apertus-open-source-cinema/pcbs/boards/axiom_beta_power_board_v0.23.brd

## EAGLE design boards/axiom_beta_power_board_v0.23.brd (2021-12-13, an earlier design)

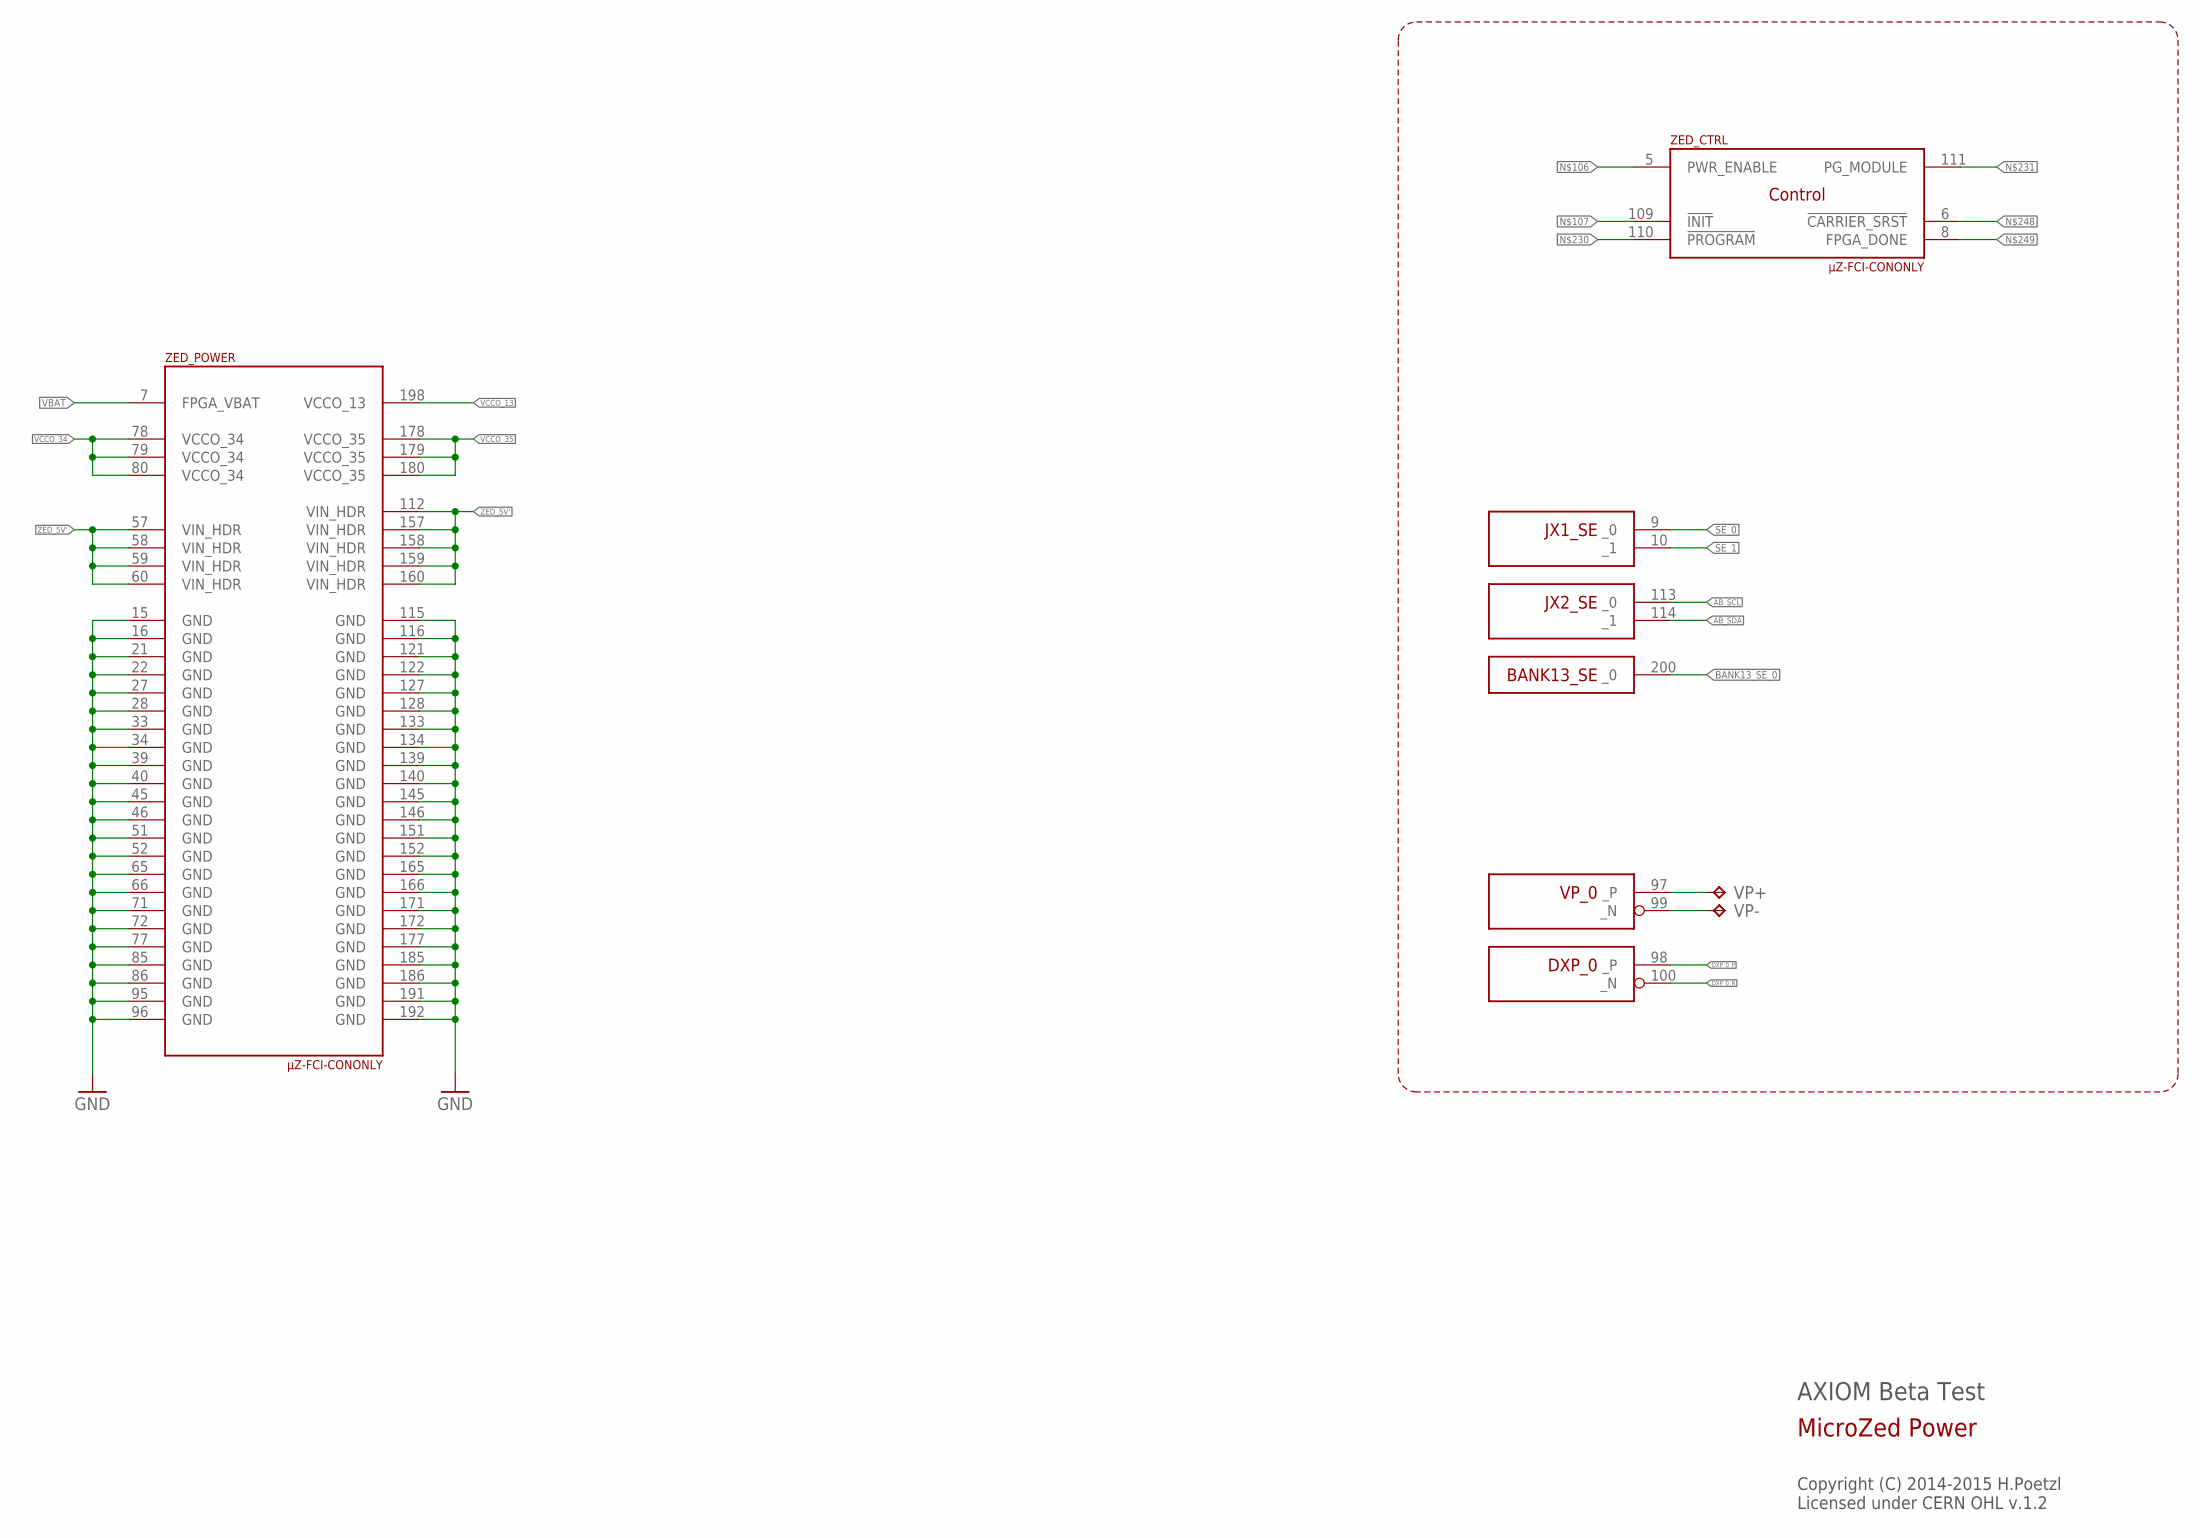
[picture p1: schematic axiom_beta_power_board_v0.23.sch, sheet 1]

Parts:
VP+: TPTP16SQ; TP16SQ
VP-: TPTP16SQ; TP16SQ
ZED: µZ-FCI-CONONLY; µZ-CONONLY

Connections:
AB_SCL: ZED.113 (_0); also elsewhere on the board
AB_SDA: ZED.114 (_1); also elsewhere on the board
BANK13_SE_0: ZED.200 (_0); also elsewhere on the board
DXP_0_N: ZED.100 (_N)
DXP_0_P: ZED.98 (_P)
GND: ZED.15 (GND), ZED.16 (GND), ZED.21 (GND), ZED.22 (GND), ZED.27 (GND), ZED.28 (GND), ZED.33 (GND), ZED.34 (GND), ZED.39 (GND), ZED.40 (GND), ZED.45 (GND), ZED.46 (GND), ZED.51 (GND), ZED.52 (GND), ZED.65 (GND), ZED.66 (GND), ZED.71 (GND), ZED.72 (GND), ZED.77 (GND), ZED.85 (GND), ZED.86 (GND), ZED.95 (GND), ZED.96 (GND), ZED.115 (GND), ZED.116 (GND), ZED.121 (GND), ZED.122 (GND), ZED.127 (GND), ZED.128 (GND), ZED.133 (GND), ZED.134 (GND), ZED.139 (GND), ZED.140 (GND), ZED.145 (GND), ZED.146 (GND), ZED.151 (GND), ZED.152 (GND), ZED.165 (GND), ZED.166 (GND), ZED.171 (GND), ZED.172 (GND), ZED.177 (GND), ZED.185 (GND), ZED.186 (GND), ZED.191 (GND), ZED.192 (GND); also elsewhere on the board
SE_0: ZED.9 (_0); also elsewhere on the board
SE_1: ZED.10 (_1); also elsewhere on the board
VBAT: ZED.7 (FPGA_VBAT)
VCCO_13: ZED.198 (VCCO_13); also elsewhere on the board
VCCO_34: ZED.78 (VCCO_34), ZED.79 (VCCO_34), ZED.80 (VCCO_34); also elsewhere on the board
VCCO_35: ZED.178 (VCCO_35), ZED.179 (VCCO_35), ZED.180 (VCCO_35); also elsewhere on the board
VP_0_N: VP-.TP, ZED.99 (_N)
VP_0_P: VP+.TP, ZED.97 (_P)
ZED_5V': ZED.57 (VIN_HDR), ZED.58 (VIN_HDR), ZED.59 (VIN_HDR), ZED.60 (VIN_HDR), ZED.112 (VIN_HDR), ZED.157 (VIN_HDR), ZED.158 (VIN_HDR), ZED.159 (VIN_HDR), ZED.160 (VIN_HDR); also elsewhere on the board

Notes on the sheet:
AXIOM Beta Test
Copyright (C) 2014-2015 H.Poetzl Licensed under CERN OHL v.1.2
MicroZed Power

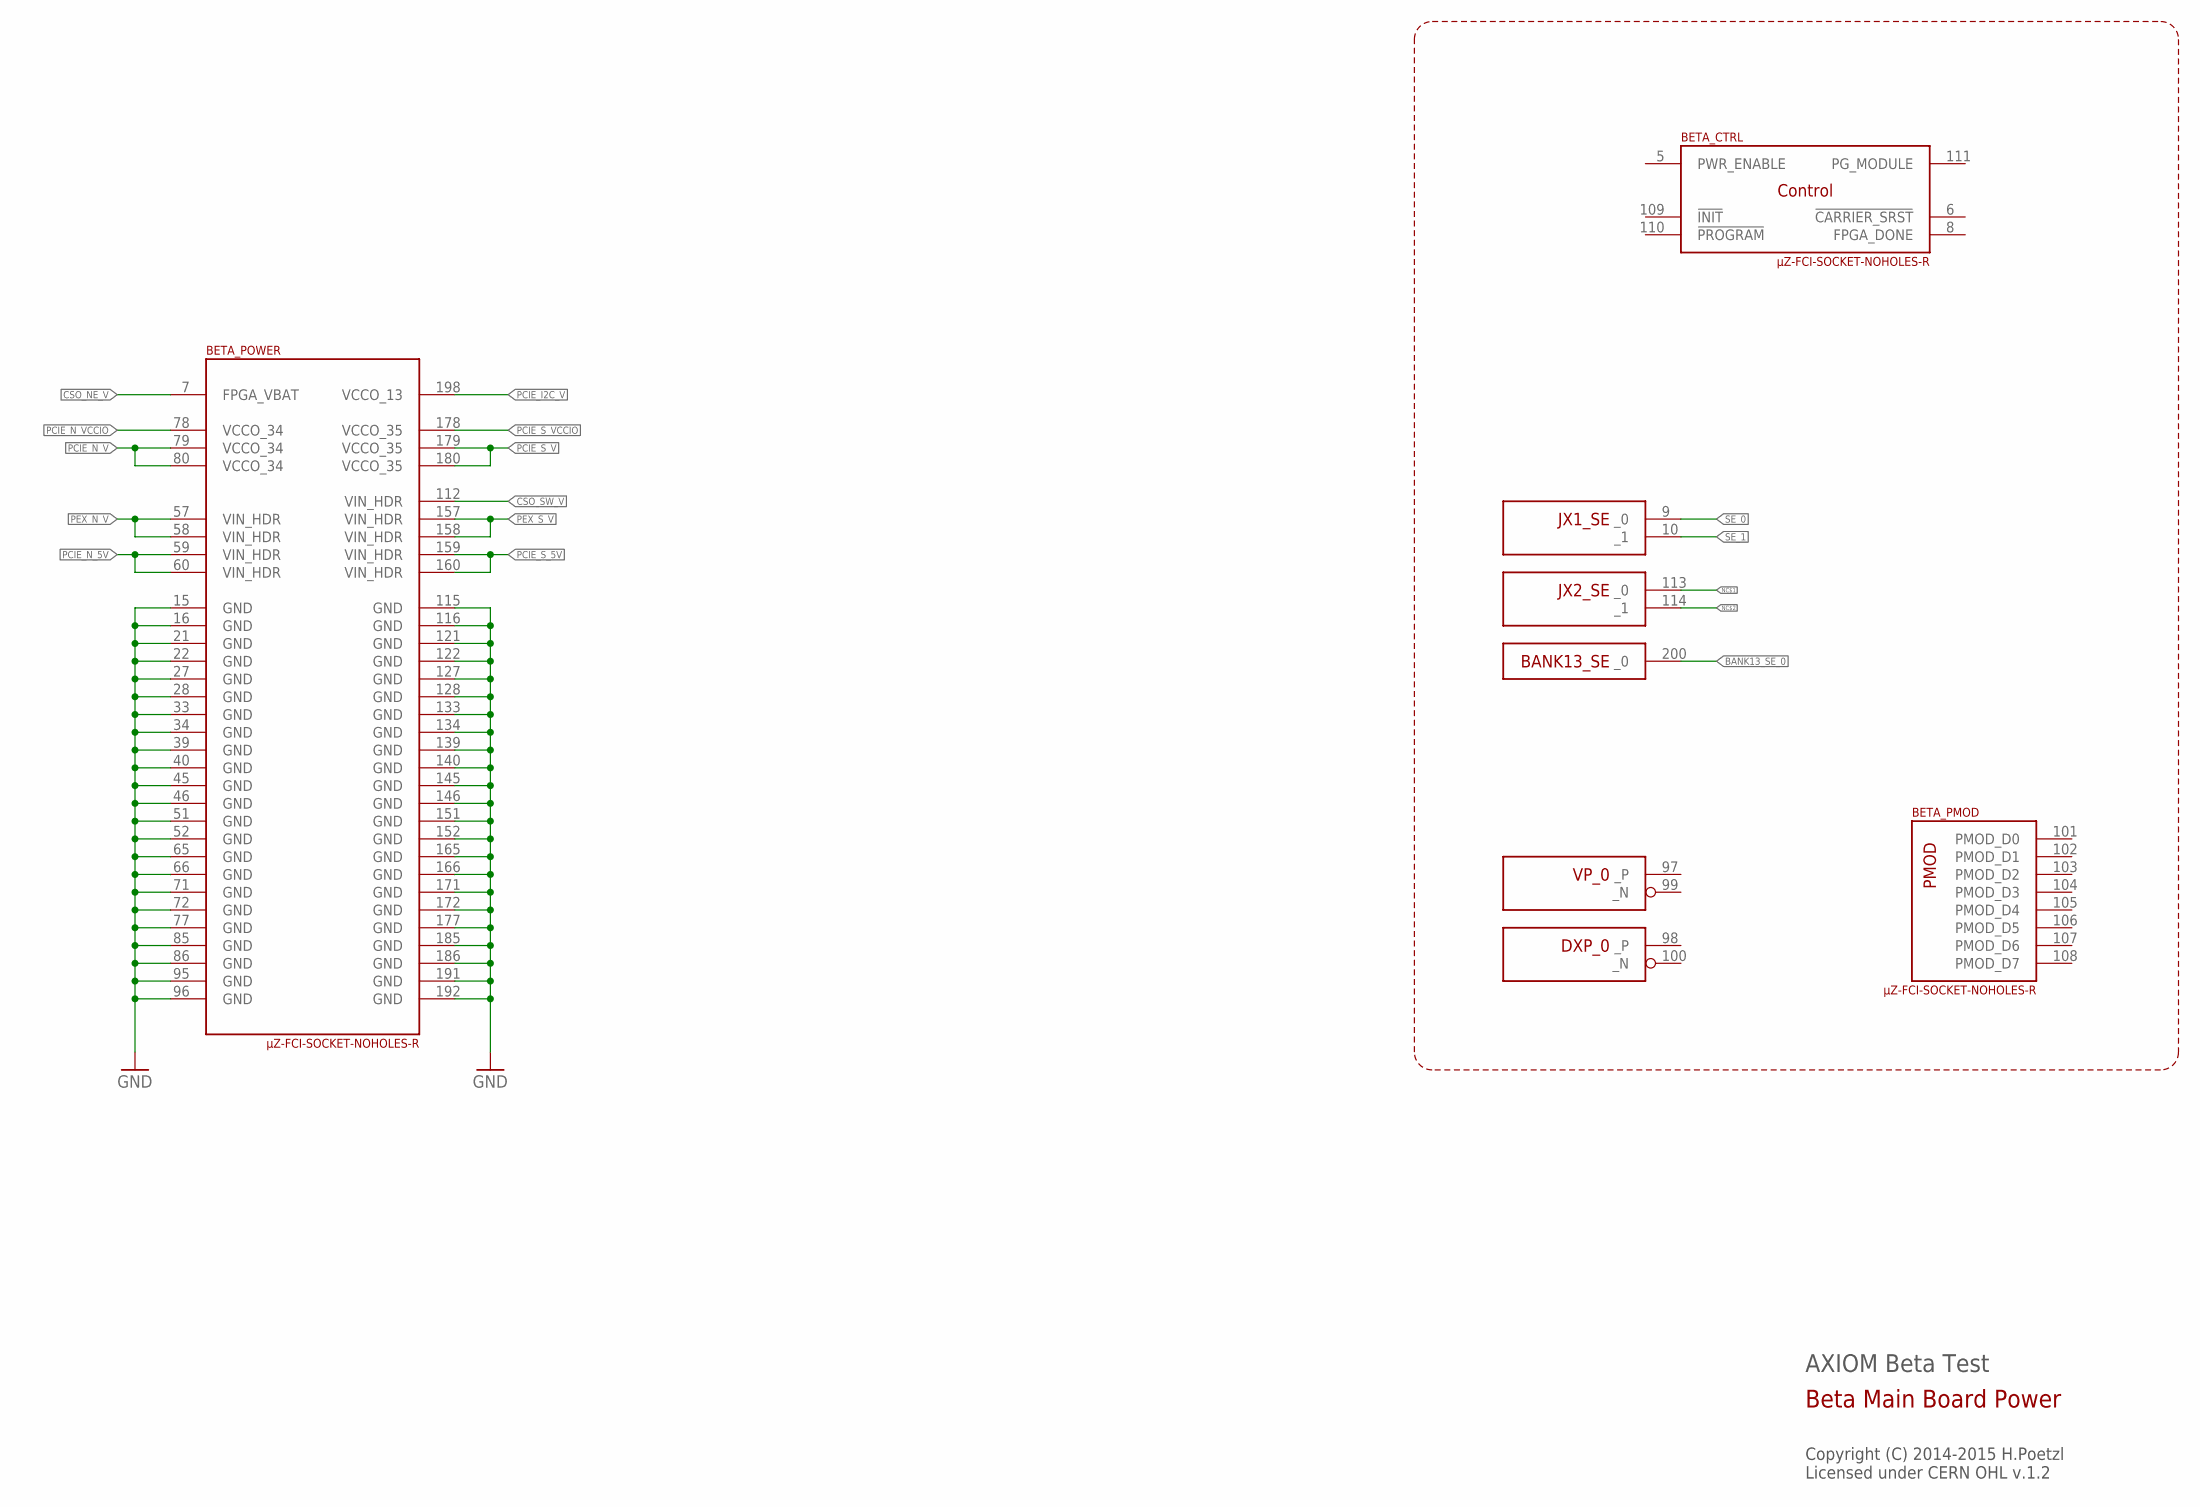
[picture p2: schematic axiom_beta_power_board_v0.23.sch, sheet 2]

Parts:
BETA: µZ-FCI-SOCKET-NOHOLES-R; µZ-SOCKET-NOHOLES-R

Connections:
BANK13_SE_0: BETA.200 (_0); also elsewhere on the board
CSO_NE_V: BETA.7 (FPGA_VBAT); also elsewhere on the board
CSO_SW_V: BETA.112 (VIN_HDR); also elsewhere on the board
GND: BETA.15 (GND), BETA.16 (GND), BETA.21 (GND), BETA.22 (GND), BETA.27 (GND), BETA.28 (GND), BETA.33 (GND), BETA.34 (GND), BETA.39 (GND), BETA.40 (GND), BETA.45 (GND), BETA.46 (GND), BETA.51 (GND), BETA.52 (GND), BETA.65 (GND), BETA.66 (GND), BETA.71 (GND), BETA.72 (GND), BETA.77 (GND), BETA.85 (GND), BETA.86 (GND), BETA.95 (GND), BETA.96 (GND), BETA.115 (GND), BETA.116 (GND), BETA.121 (GND), BETA.122 (GND), BETA.127 (GND), BETA.128 (GND), BETA.133 (GND), BETA.134 (GND), BETA.139 (GND), BETA.140 (GND), BETA.145 (GND), BETA.146 (GND), BETA.151 (GND), BETA.152 (GND), BETA.165 (GND), BETA.166 (GND), BETA.171 (GND), BETA.172 (GND), BETA.177 (GND), BETA.185 (GND), BETA.186 (GND), BETA.191 (GND), BETA.192 (GND); also elsewhere on the board
NC$1: BETA.113 (_0)
NC$2: BETA.114 (_1)
PCIE_I2C_V: BETA.198 (VCCO_13)
PCIE_N_5V: BETA.59 (VIN_HDR), BETA.60 (VIN_HDR)
PCIE_N_V: BETA.79 (VCCO_34), BETA.80 (VCCO_34); also elsewhere on the board
PCIE_N_VCCIO: BETA.78 (VCCO_34)
PCIE_S_5V: BETA.159 (VIN_HDR), BETA.160 (VIN_HDR)
PCIE_S_V: BETA.179 (VCCO_35), BETA.180 (VCCO_35); also elsewhere on the board
PCIE_S_VCCIO: BETA.178 (VCCO_35)
PEX_N_V: BETA.57 (VIN_HDR), BETA.58 (VIN_HDR)
PEX_S_V: BETA.157 (VIN_HDR), BETA.158 (VIN_HDR)
SE_0: BETA.9 (_0); also elsewhere on the board
SE_1: BETA.10 (_1); also elsewhere on the board

Notes on the sheet:
AXIOM Beta Test
Copyright (C) 2014-2015 H.Poetzl Licensed under CERN OHL v.1.2
Beta Main Board Power

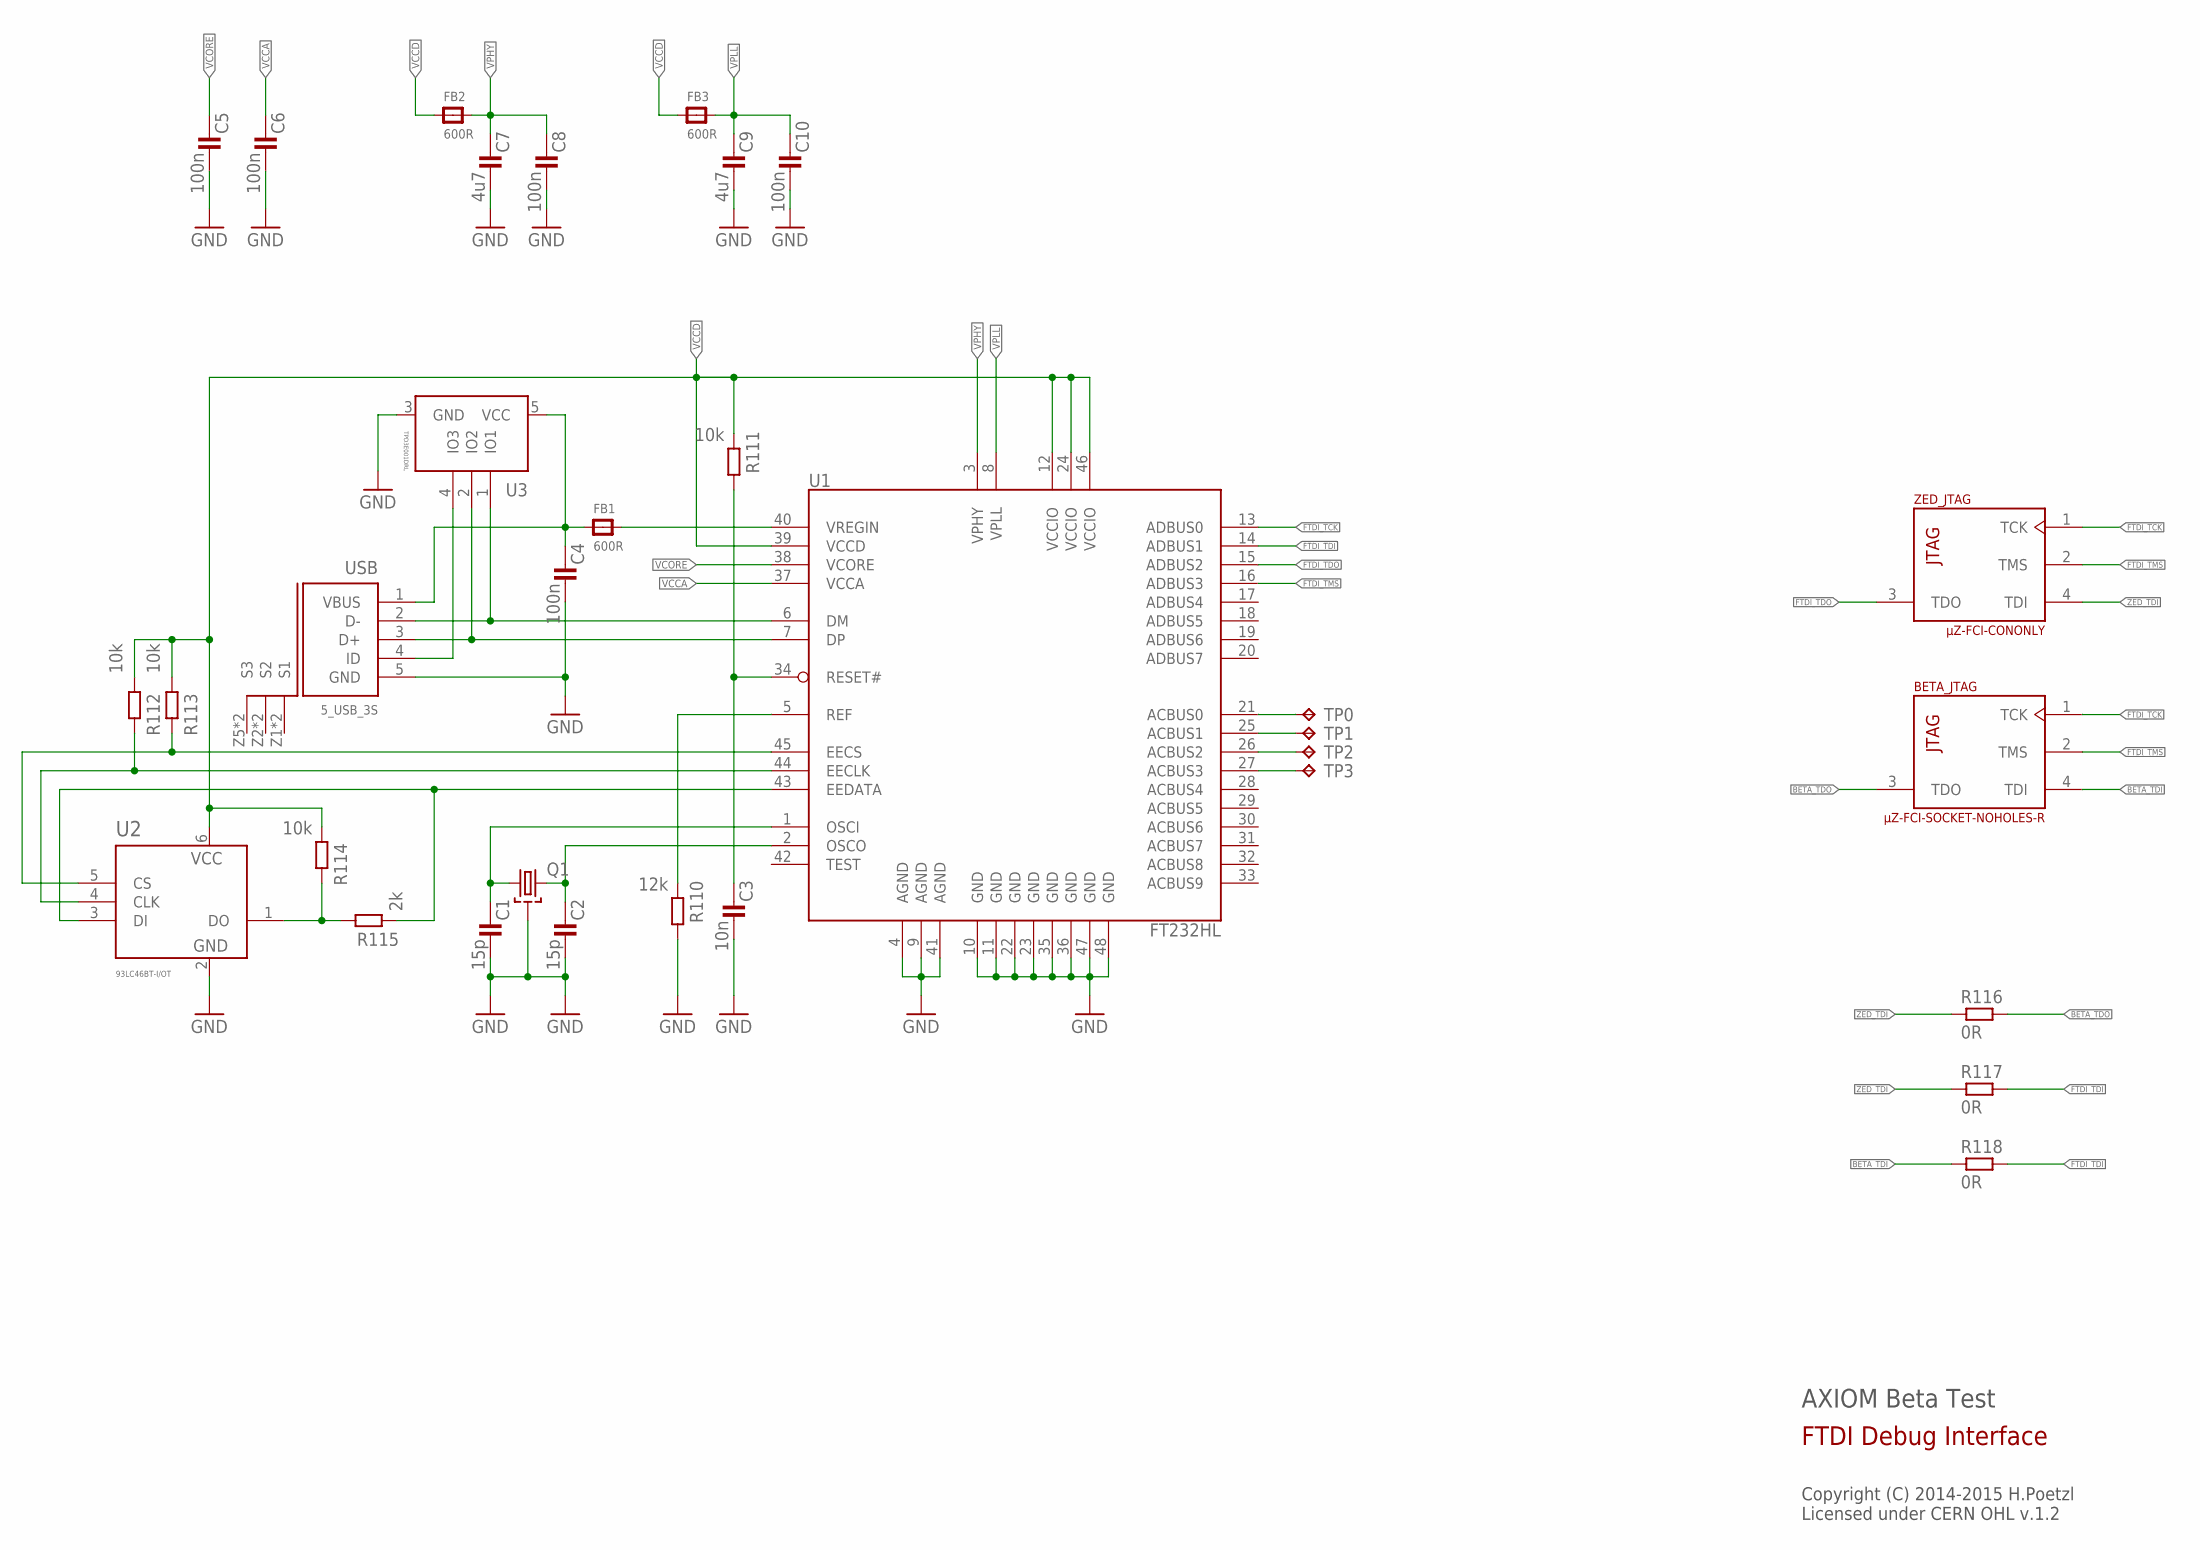
[picture p3: schematic axiom_beta_power_board_v0.23.sch, sheet 3]

Parts:
BETA: µZ-FCI-SOCKET-NOHOLES-R; µZ-SOCKET-NOHOLES-R
C1, C2: 15p; 0402-B
C3: 10n; 0402-B
C4: 100n; 0603-B
C5, C6, C8, C10: 100n; 0402-B
C7, C9: 4u7; 0603-B
FB1, FB2, FB3: 600R; _0603MP
Q1: SMD-4P-2G-3.2X2.5; ABM8G
R110: 12k; 0402-B
R111, R112, R113, R114: 10k; 0402-B
R115: 2k; 0402-B
R116, R117, R118: 0R; 0402-B
TP0, TP1, TP2, TP3: TPTP16SQ; TP16SQ
U1: FT232HL; LQFP48
U2: 93LC46BT-I/OT; SOT95P280X145-6N
U3: TPD3E001DRL; R-PDSO-N5
USB: 5_USB_3S; MICRO-AB-H-SMT
ZED: µZ-FCI-CONONLY; µZ-CONONLY

Connections:
BETA_TDI: BETA.4 (TDI), R118.2
BETA_TDO: BETA.3 (TDO), R116.1
EE_CLK1: R112.1, U1.44 (EECLK), U2.4 (CLK)
EE_CS1: R113.1, U1.45 (EECS), U2.5 (CS)
EE_DATA1: R115.2, U1.43 (EEDATA), U2.3 (DI)
FTDI_D_N: U1.6 (DM), U3.1 (IO1), USB.2 (D-)
FTDI_D_P: U1.7 (DP), U3.2 (IO2), USB.3 (D+)
FTDI_TCK: BETA.1 (TCK), U1.13 (ADBUS0), ZED.1 (TCK)
FTDI_TDI: R117.1, R118.1, U1.14 (ADBUS1)
FTDI_TDO: U1.15 (ADBUS2), ZED.3 (TDO)
FTDI_TMS: BETA.2 (TMS), U1.16 (ADBUS3), ZED.2 (TMS)
GND: C1.2, C2.2, C3.2, C4.2, C5.2, C6.2, C7.2, C8.2, C9.2, C10.2, Q1.2 (GND), Q1.4 (GND), R110.1, U1.4 (AGND), U1.9 (AGND), U1.10 (GND), U1.11 (GND), U1.22 (GND), U1.23 (GND), U1.35 (GND), U1.36 (GND), U1.41 (AGND), U1.47 (GND), U1.48 (GND), U2.2 (VSS), U3.3 (GND), USB.5 (GND); also elsewhere on the board
unnamed: C4.1, FB1.1, U3.5 (VCC), USB.1 (VBUS)
unnamed: TP1.TP, U1.25 (ACBUS1)
unnamed: TP2.TP, U1.26 (ACBUS2)
unnamed: TP3.TP, U1.27 (ACBUS3)
unnamed: TP0.TP, U1.21 (ACBUS0)
unnamed: R114.1, R115.1, U2.1 (DO)
unnamed: C1.1, Q1.1, U1.1 (OSCI)
unnamed: C2.1, Q1.3 (2), U1.2 (OSCO)
unnamed: C3.1, R111.1, U1.34 (RESET#)
unnamed: R110.2, U1.5 (REF)
unnamed: U3.4 (IO3), USB.4 (ID)
VCCA: C6.1, U1.37 (VCCA)
VCCD: FB2.1, FB3.1, R111.2, R112.2, R113.2, R114.2, U1.12 (VCCIO), U1.24 (VCCIO), U1.39 (VCCD), U1.46 (VCCIO), U2.6 (VCC)
VCORE: C5.1, U1.38 (VCORE)
VPHY: C7.1, C8.1, FB2.2, U1.3 (VPHY)
VPLL: C9.1, C10.1, FB3.2, U1.8 (VPLL)
VREGIN: FB1.2, U1.40 (VREGIN)
ZED_TDI: R116.2, R117.2, ZED.4 (TDI)

Notes on the sheet:
AXIOM Beta Test
Copyright (C) 2014-2015 H.Poetzl Licensed under CERN OHL v.1.2
FTDI Debug Interface

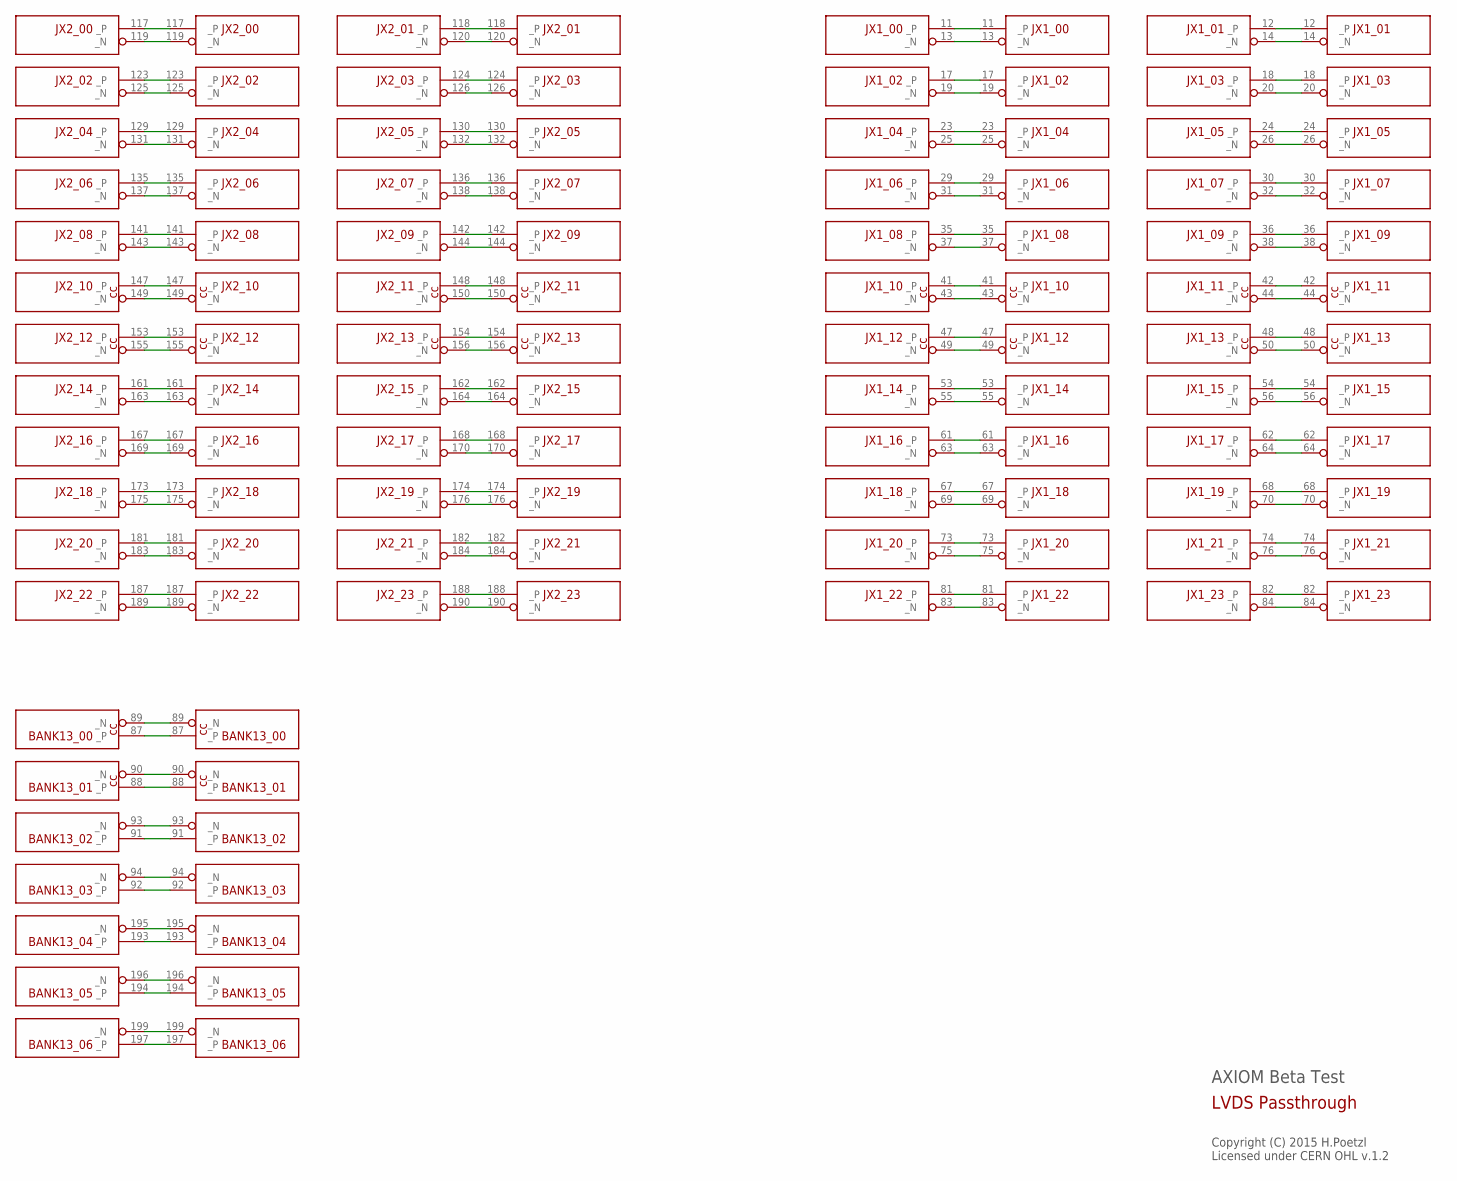
[picture p4: schematic axiom_beta_power_board_v0.23.sch, sheet 4]

Parts:
BETA: µZ-FCI-SOCKET-NOHOLES-R; µZ-SOCKET-NOHOLES-R
ZED: µZ-FCI-CONONLY; µZ-CONONLY

Connections:
BANK13_00_N: BETA.89 (_N), ZED.89 (_N)
BANK13_00_P: BETA.87 (_P), ZED.87 (_P)
BANK13_01_N: BETA.90 (_N), ZED.90 (_N)
BANK13_01_P: BETA.88 (_P), ZED.88 (_P)
BANK13_02_N: BETA.93 (_N), ZED.93 (_N)
BANK13_02_P: BETA.91 (_P), ZED.91 (_P)
BANK13_03_N: BETA.94 (_N), ZED.94 (_N)
BANK13_03_P: BETA.92 (_P), ZED.92 (_P)
BANK13_04_N: BETA.195 (_N), ZED.195 (_N)
BANK13_04_P: BETA.193 (_P), ZED.193 (_P)
BANK13_05_N: BETA.196 (_N), ZED.196 (_N)
BANK13_05_P: BETA.194 (_P), ZED.194 (_P)
BANK13_06_N: BETA.199 (_N), ZED.199 (_N)
BANK13_06_P: BETA.197 (_P), ZED.197 (_P)
JX1_00_N: BETA.13 (_N), ZED.13 (_N)
JX1_00_P: BETA.11 (_P), ZED.11 (_P)
JX1_01_N: BETA.14 (_N), ZED.14 (_N)
JX1_01_P: BETA.12 (_P), ZED.12 (_P)
JX1_02_N: BETA.19 (_N), ZED.19 (_N)
JX1_02_P: BETA.17 (_P), ZED.17 (_P)
JX1_03_N: BETA.20 (_N), ZED.20 (_N)
JX1_03_P: BETA.18 (_P), ZED.18 (_P)
JX1_04_N: BETA.25 (_N), ZED.25 (_N)
JX1_04_P: BETA.23 (_P), ZED.23 (_P)
JX1_05_N: BETA.26 (_N), ZED.26 (_N)
JX1_05_P: BETA.24 (_P), ZED.24 (_P)
JX1_06_N: BETA.31 (_N), ZED.31 (_N)
JX1_06_P: BETA.29 (_P), ZED.29 (_P)
JX1_07_N: BETA.32 (_N), ZED.32 (_N)
JX1_07_P: BETA.30 (_P), ZED.30 (_P)
JX1_08_N: BETA.37 (_N), ZED.37 (_N)
JX1_08_P: BETA.35 (_P), ZED.35 (_P)
JX1_09_N: BETA.38 (_N), ZED.38 (_N)
JX1_09_P: BETA.36 (_P), ZED.36 (_P)
JX1_10_N: BETA.43 (_N), ZED.43 (_N)
JX1_10_P: BETA.41 (_P), ZED.41 (_P)
JX1_11_N: BETA.44 (_N), ZED.44 (_N)
JX1_11_P: BETA.42 (_P), ZED.42 (_P)
JX1_12_N: BETA.49 (_N), ZED.49 (_N)
JX1_12_P: BETA.47 (_P), ZED.47 (_P)
JX1_13_N: BETA.50 (_N), ZED.50 (_N)
JX1_13_P: BETA.48 (_P), ZED.48 (_P)
JX1_14_N: BETA.55 (_N), ZED.55 (_N)
JX1_14_P: BETA.53 (_P), ZED.53 (_P)
JX1_15_N: BETA.56 (_N), ZED.56 (_N)
JX1_15_P: BETA.54 (_P), ZED.54 (_P)
JX1_16_N: BETA.63 (_N), ZED.63 (_N)
JX1_16_P: BETA.61 (_P), ZED.61 (_P)
JX1_17_N: BETA.64 (_N), ZED.64 (_N)
JX1_17_P: BETA.62 (_P), ZED.62 (_P)
JX1_18_N: BETA.69 (_N), ZED.69 (_N)
JX1_18_P: BETA.67 (_P), ZED.67 (_P)
JX1_19_N: BETA.70 (_N), ZED.70 (_N)
JX1_19_P: BETA.68 (_P), ZED.68 (_P)
JX1_20_N: BETA.75 (_N), ZED.75 (_N)
JX1_20_P: BETA.73 (_P), ZED.73 (_P)
JX1_21_N: BETA.76 (_N), ZED.76 (_N)
JX1_21_P: BETA.74 (_P), ZED.74 (_P)
JX1_22_N: BETA.83 (_N), ZED.83 (_N)
JX1_22_P: BETA.81 (_P), ZED.81 (_P)
JX1_23_N: BETA.84 (_N), ZED.84 (_N)
JX1_23_P: BETA.82 (_P), ZED.82 (_P)
JX2_00_N: BETA.119 (_N), ZED.119 (_N)
JX2_00_P: BETA.117 (_P), ZED.117 (_P)
JX2_01_N: BETA.120 (_N), ZED.120 (_N)
JX2_01_P: BETA.118 (_P), ZED.118 (_P)
JX2_02_N: BETA.125 (_N), ZED.125 (_N)
JX2_02_P: BETA.123 (_P), ZED.123 (_P)
JX2_03_N: BETA.126 (_N), ZED.126 (_N)
JX2_03_P: BETA.124 (_P), ZED.124 (_P)
JX2_04_N: BETA.131 (_N), ZED.131 (_N)
JX2_04_P: BETA.129 (_P), ZED.129 (_P)
JX2_05_N: BETA.132 (_N), ZED.132 (_N)
JX2_05_P: BETA.130 (_P), ZED.130 (_P)
JX2_06_N: BETA.137 (_N), ZED.137 (_N)
JX2_06_P: BETA.135 (_P), ZED.135 (_P)
JX2_07_N: BETA.138 (_N), ZED.138 (_N)
JX2_07_P: BETA.136 (_P), ZED.136 (_P)
JX2_08_N: BETA.143 (_N), ZED.143 (_N)
JX2_08_P: BETA.141 (_P), ZED.141 (_P)
JX2_09_N: BETA.144 (_N), ZED.144 (_N)
JX2_09_P: BETA.142 (_P), ZED.142 (_P)
JX2_10_N: BETA.149 (_N), ZED.149 (_N)
JX2_10_P: BETA.147 (_P), ZED.147 (_P)
JX2_11_N: BETA.150 (_N), ZED.150 (_N)
JX2_11_P: BETA.148 (_P), ZED.148 (_P)
JX2_12_N: BETA.155 (_N), ZED.155 (_N)
JX2_12_P: BETA.153 (_P), ZED.153 (_P)
JX2_13_N: BETA.156 (_N), ZED.156 (_N)
JX2_13_P: BETA.154 (_P), ZED.154 (_P)
JX2_14_N: BETA.163 (_N), ZED.163 (_N)
JX2_14_P: BETA.161 (_P), ZED.161 (_P)
JX2_15_N: BETA.164 (_N), ZED.164 (_N)
JX2_15_P: BETA.162 (_P), ZED.162 (_P)
JX2_16_N: BETA.169 (_N), ZED.169 (_N)
JX2_16_P: BETA.167 (_P), ZED.167 (_P)
JX2_17_N: BETA.170 (_N), ZED.170 (_N)
JX2_17_P: BETA.168 (_P), ZED.168 (_P)
JX2_18_N: BETA.175 (_N), ZED.175 (_N)
JX2_18_P: BETA.173 (_P), ZED.173 (_P)
JX2_19_N: BETA.176 (_N), ZED.176 (_N)
JX2_19_P: BETA.174 (_P), ZED.174 (_P)
JX2_20_N: BETA.183 (_N), ZED.183 (_N)
JX2_20_P: BETA.181 (_P), ZED.181 (_P)
JX2_21_N: BETA.184 (_N), ZED.184 (_N)
JX2_21_P: BETA.182 (_P), ZED.182 (_P)
JX2_22_N: BETA.189 (_N), ZED.189 (_N)
JX2_22_P: BETA.187 (_P), ZED.187 (_P)
JX2_23_N: BETA.190 (_N), ZED.190 (_N)
JX2_23_P: BETA.188 (_P), ZED.188 (_P)

Notes on the sheet:
AXIOM Beta Test
Copyright (C) 2015 H.Poetzl Licensed under CERN OHL v.1.2
LVDS Passthrough
