apertus-open-source-cinema/pcbs/boards/axiom_beta_power_board_v0.23.brd

## EAGLE design boards/axiom_beta_power_board_v0.23.brd (continued)

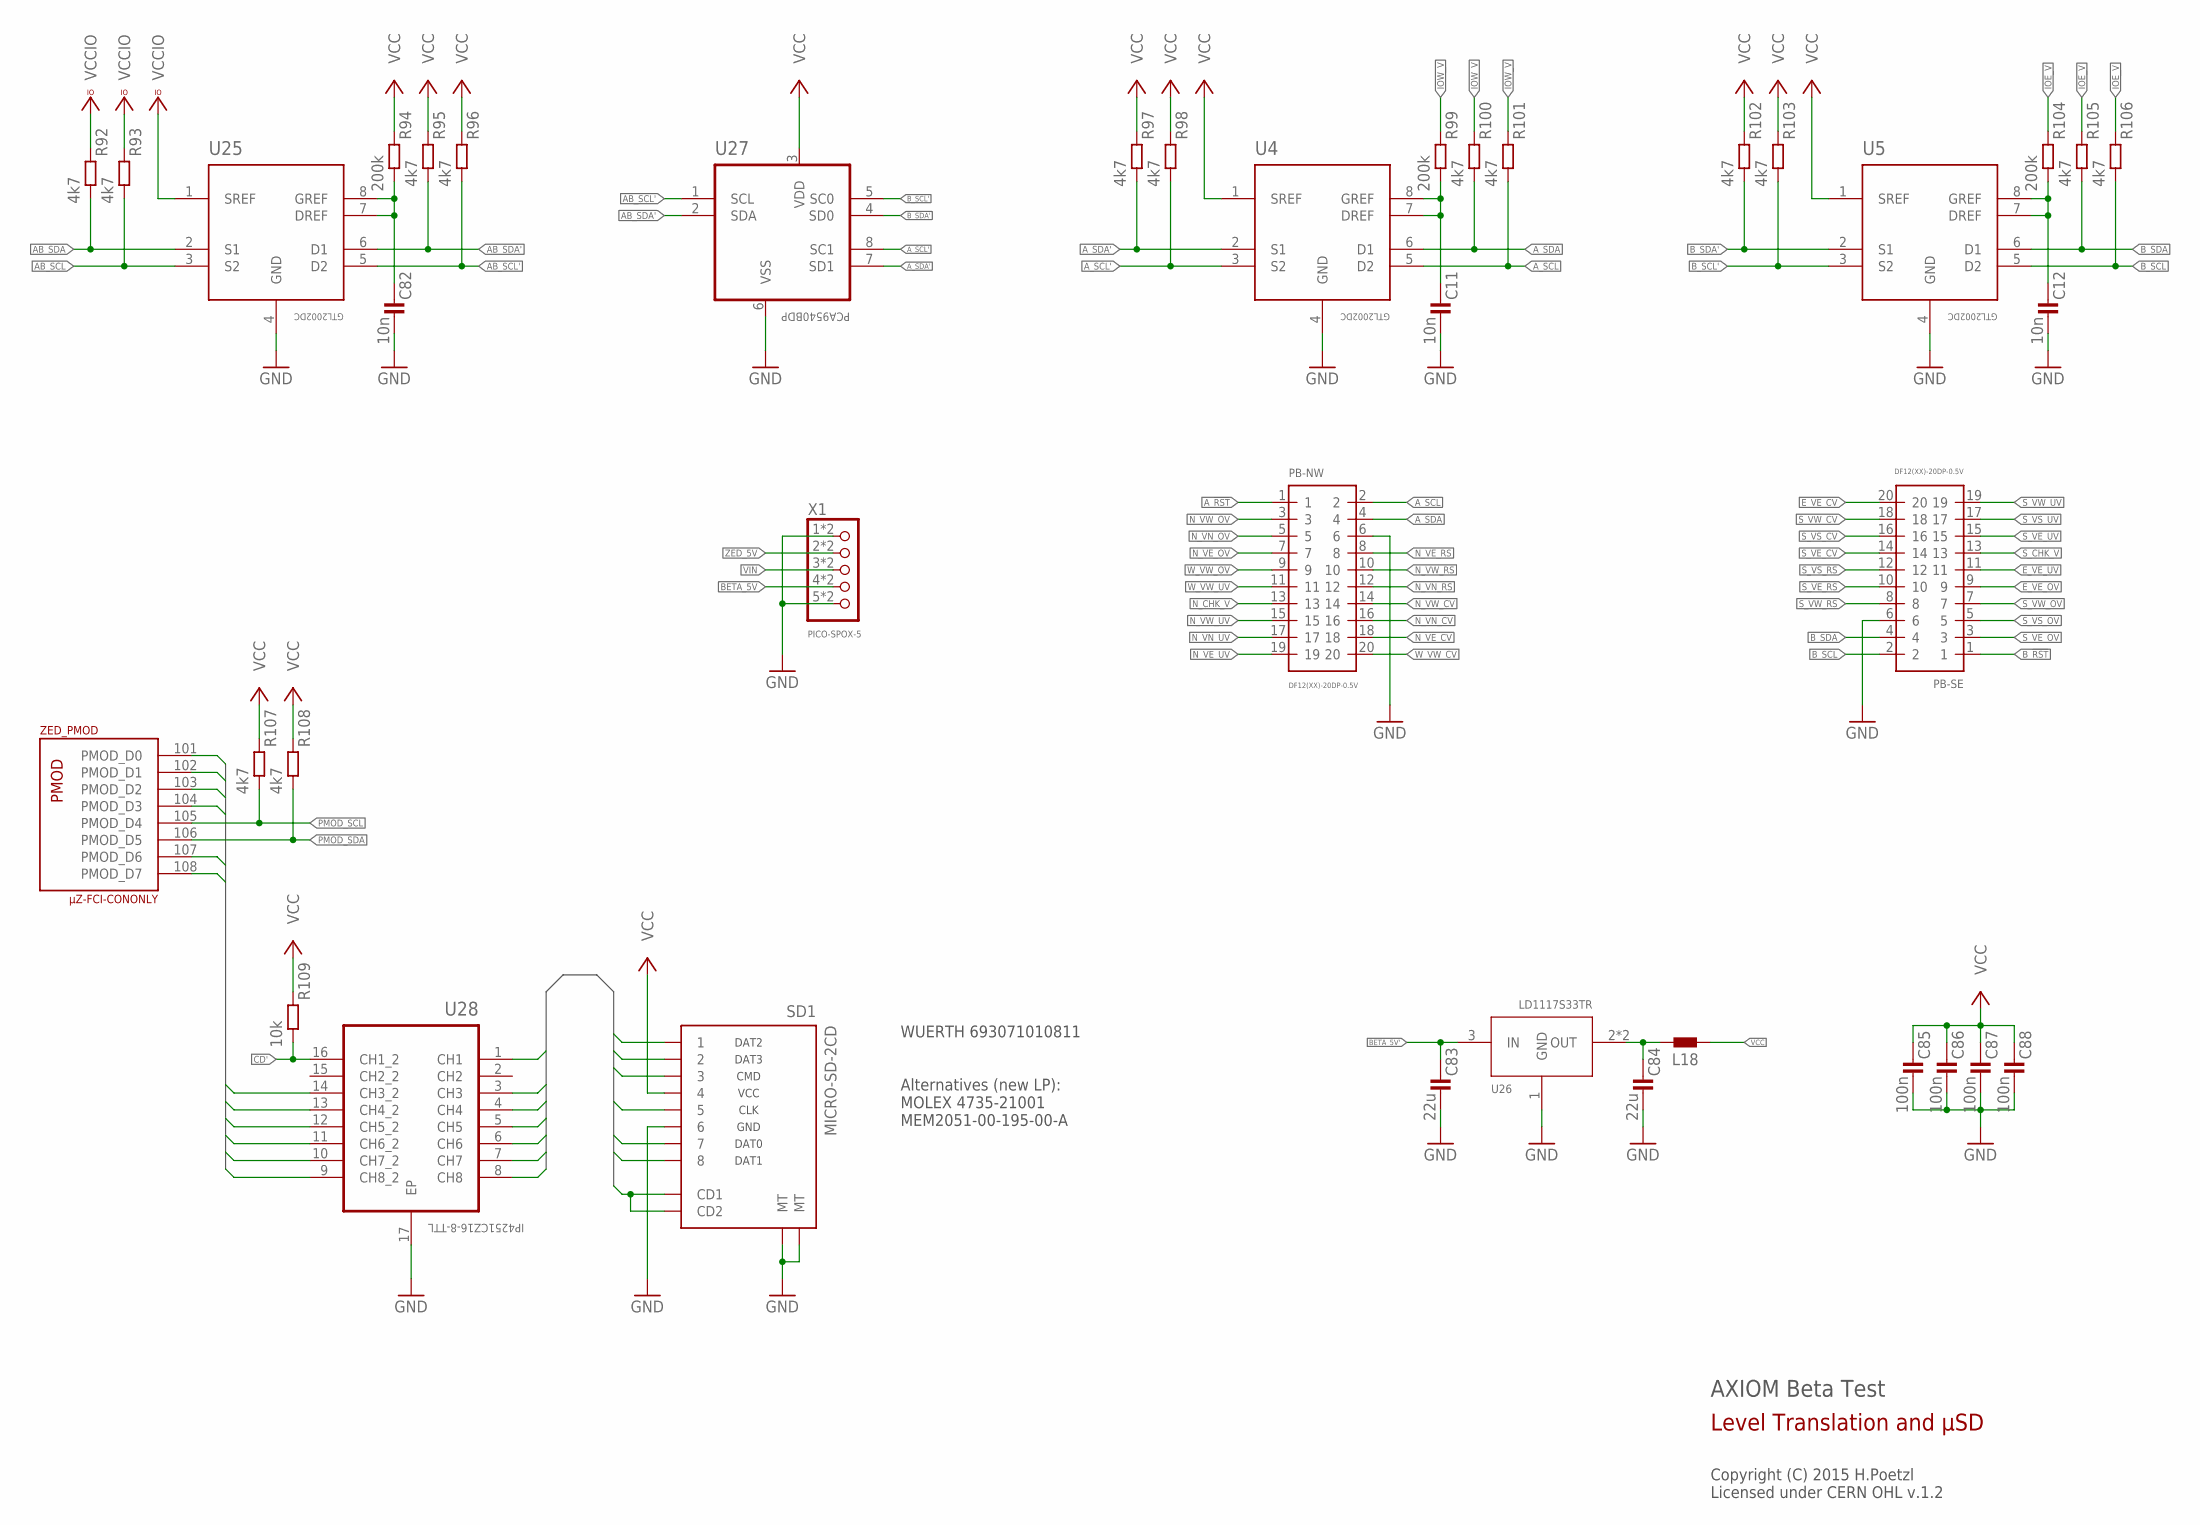
[picture p5: schematic axiom_beta_power_board_v0.23.sch, sheet 5]

Parts:
C11, C12, C82: 10n; 0402-B
C83, C84: 22u; 0805-B
C85, C86, C87, C88: 100n; 0402-B
L18: L0805-A; 0805-A
PB-NW: DF12(XX)-20DP-0.5V
PB-SE: DF12(XX)-20DP-0.5V
R92, R93, R95, R96, R97, R98, R100, R101, R102, R103, R105, R106, R107, R108: 4k7; 0402-B
R94, R99, R104: 200k; 0402-B
R109: 10k; 0402-B
SD1: MICRO-SD-2CD; TF-MICRO-SD_PP2
U4, U5, U25: GTL2002DC; VSSOP-8
U26: LD1117S33TR; SOT-223
U27: PCA9540BDP; SOP65P490X300-8N
U28: IP4251CZ16-8-TTL; SON40P135X330X55-17N
X1: PICO-SPOX-5
ZED: µZ-FCI-CONONLY; µZ-CONONLY

Connections:
AB_SCL: R93.2, U25.3 (S2); also elsewhere on the board
AB_SCL': R96.2, U25.5 (D2), U27.1 (SCL)
AB_SDA: R92.2, U25.2 (S1); also elsewhere on the board
AB_SDA': R95.2, U25.6 (D1), U27.2 (SDA)
A_!RST: PB-NW.1; also elsewhere on the board
A_SCL: PB-NW.2, R101.2, U4.5 (D2)
A_SCL': R98.2, U4.3 (S2), U27.8 (SC1)
A_SDA: PB-NW.4, R100.2, U4.6 (D1)
A_SDA': R97.2, U4.2 (S1), U27.7 (SD1)
BETA_5V: X1.4, X1.4A (4); also elsewhere on the board
BETA_5V': C83.1, U26.3 (IN); also elsewhere on the board
B_!RST: PB-SE.1; also elsewhere on the board
B_SCL: PB-SE.2, R106.2, U5.5 (D2)
B_SCL': R103.2, U5.3 (S2), U27.5 (SC0)
B_SDA: PB-SE.4, R105.2, U5.6 (D1)
B_SDA': R102.2, U5.2 (S1), U27.4 (SD0)
CD: SD1.CD1, SD1.CD2, U28.1 (CH1)
CD': R109.2, U28.16 (CH1_2); also elsewhere on the board
CLK: SD1.5, U28.6 (CH6)
CMD: SD1.3, U28.5 (CH5)
DAT0: SD1.7, U28.7 (CH7)
DAT1: SD1.8, U28.8 (CH8)
DAT2: SD1.1, U28.3 (CH3)
DAT3: SD1.2, U28.4 (CH4)
E_VE_CV: PB-SE.20
E_VE_OV: PB-SE.9
E_VE_UV: PB-SE.11
GND: C11.2, C12.2, C82.2, C83.2, C84.2, C85.2, C86.2, C87.2, C88.2, PB-NW.6, PB-SE.6, SD1.6, SD1.MT1 (MT), SD1.MT2 (MT), U4.4 (GND), U5.4 (GND), U25.4 (GND), U26.1 (GND), U27.6 (VSS), U28.17 (EP), X1.1, X1.1A (1), X1.5, X1.5A (5); also elsewhere on the board
IOE_V: R104.1, R105.1, R106.1; also elsewhere on the board
IOW_V: R99.1, R100.1, R101.1; also elsewhere on the board
unnamed: C11.1, R99.2, U4.7 (DREF), U4.8 (GREF)
unnamed: C12.1, R104.2, U5.7 (DREF), U5.8 (GREF)
unnamed: C82.1, R94.2, U25.7 (DREF), U25.8 (GREF)
N_CHK_V: PB-NW.13
N_VE_CV: PB-NW.18
N_VE_OV: PB-NW.7
N_VE_RS: PB-NW.8
N_VE_UV: PB-NW.19
N_VN_CV: PB-NW.16
N_VN_OV: PB-NW.5
N_VN_RS: PB-NW.12
N_VN_UV: PB-NW.17
N_VW_CV: PB-NW.14
N_VW_OV: PB-NW.3
N_VW_RS: PB-NW.10
N_VW_UV: PB-NW.15
PMOD_D0: U28.9 (CH8_2), ZED.101 (PMOD_D0)
PMOD_D1: U28.10 (CH7_2), ZED.102 (PMOD_D1)
PMOD_D2: U28.12 (CH5_2), ZED.103 (PMOD_D2)
PMOD_D3: U28.11 (CH6_2), ZED.104 (PMOD_D3)
PMOD_D6: U28.14 (CH3_2), ZED.107 (PMOD_D6)
PMOD_D7: U28.13 (CH4_2), ZED.108 (PMOD_D7)
PMOD_SCL: R107.2, ZED.105 (PMOD_D4); also elsewhere on the board
PMOD_SDA: R108.2, ZED.106 (PMOD_D5); also elsewhere on the board
REGOUT: C84.1, L18.1, U26.2 (OUT), U26.TER (OUT)
S_CHK_V: PB-SE.13
S_VE_CV: PB-SE.14
S_VE_OV: PB-SE.3
S_VE_RS: PB-SE.10
S_VE_UV: PB-SE.15
S_VS_CV: PB-SE.16
S_VS_OV: PB-SE.5
S_VS_RS: PB-SE.12
S_VS_UV: PB-SE.17
S_VW_CV: PB-SE.18
S_VW_OV: PB-SE.7
S_VW_RS: PB-SE.8
S_VW_UV: PB-SE.19
VCC: C85.1, C86.1, C87.1, C88.1, L18.2, R94.1, R95.1, R96.1, R97.1, R98.1, R102.1, R103.1, R107.1, R108.1, R109.1, SD1.4, U4.1 (SREF), U5.1 (SREF), U27.3 (VDD); also elsewhere on the board
VCCIO: R92.1, R93.1, U25.1 (SREF); also elsewhere on the board
VIN: X1.3, X1.3A (3)
W_VW_CV: PB-NW.20
W_VW_OV: PB-NW.9
W_VW_UV: PB-NW.11
ZED_5V: X1.2, X1.2A (2); also elsewhere on the board

Notes on the sheet:
AXIOM Beta Test
Copyright (C) 2015 H.Poetzl Licensed under CERN OHL v.1.2
Level Translation and µSD
WUERTH 693071010811 Alternatives (new LP): MOLEX 4735-21001 MEM2051-00-195-00-A

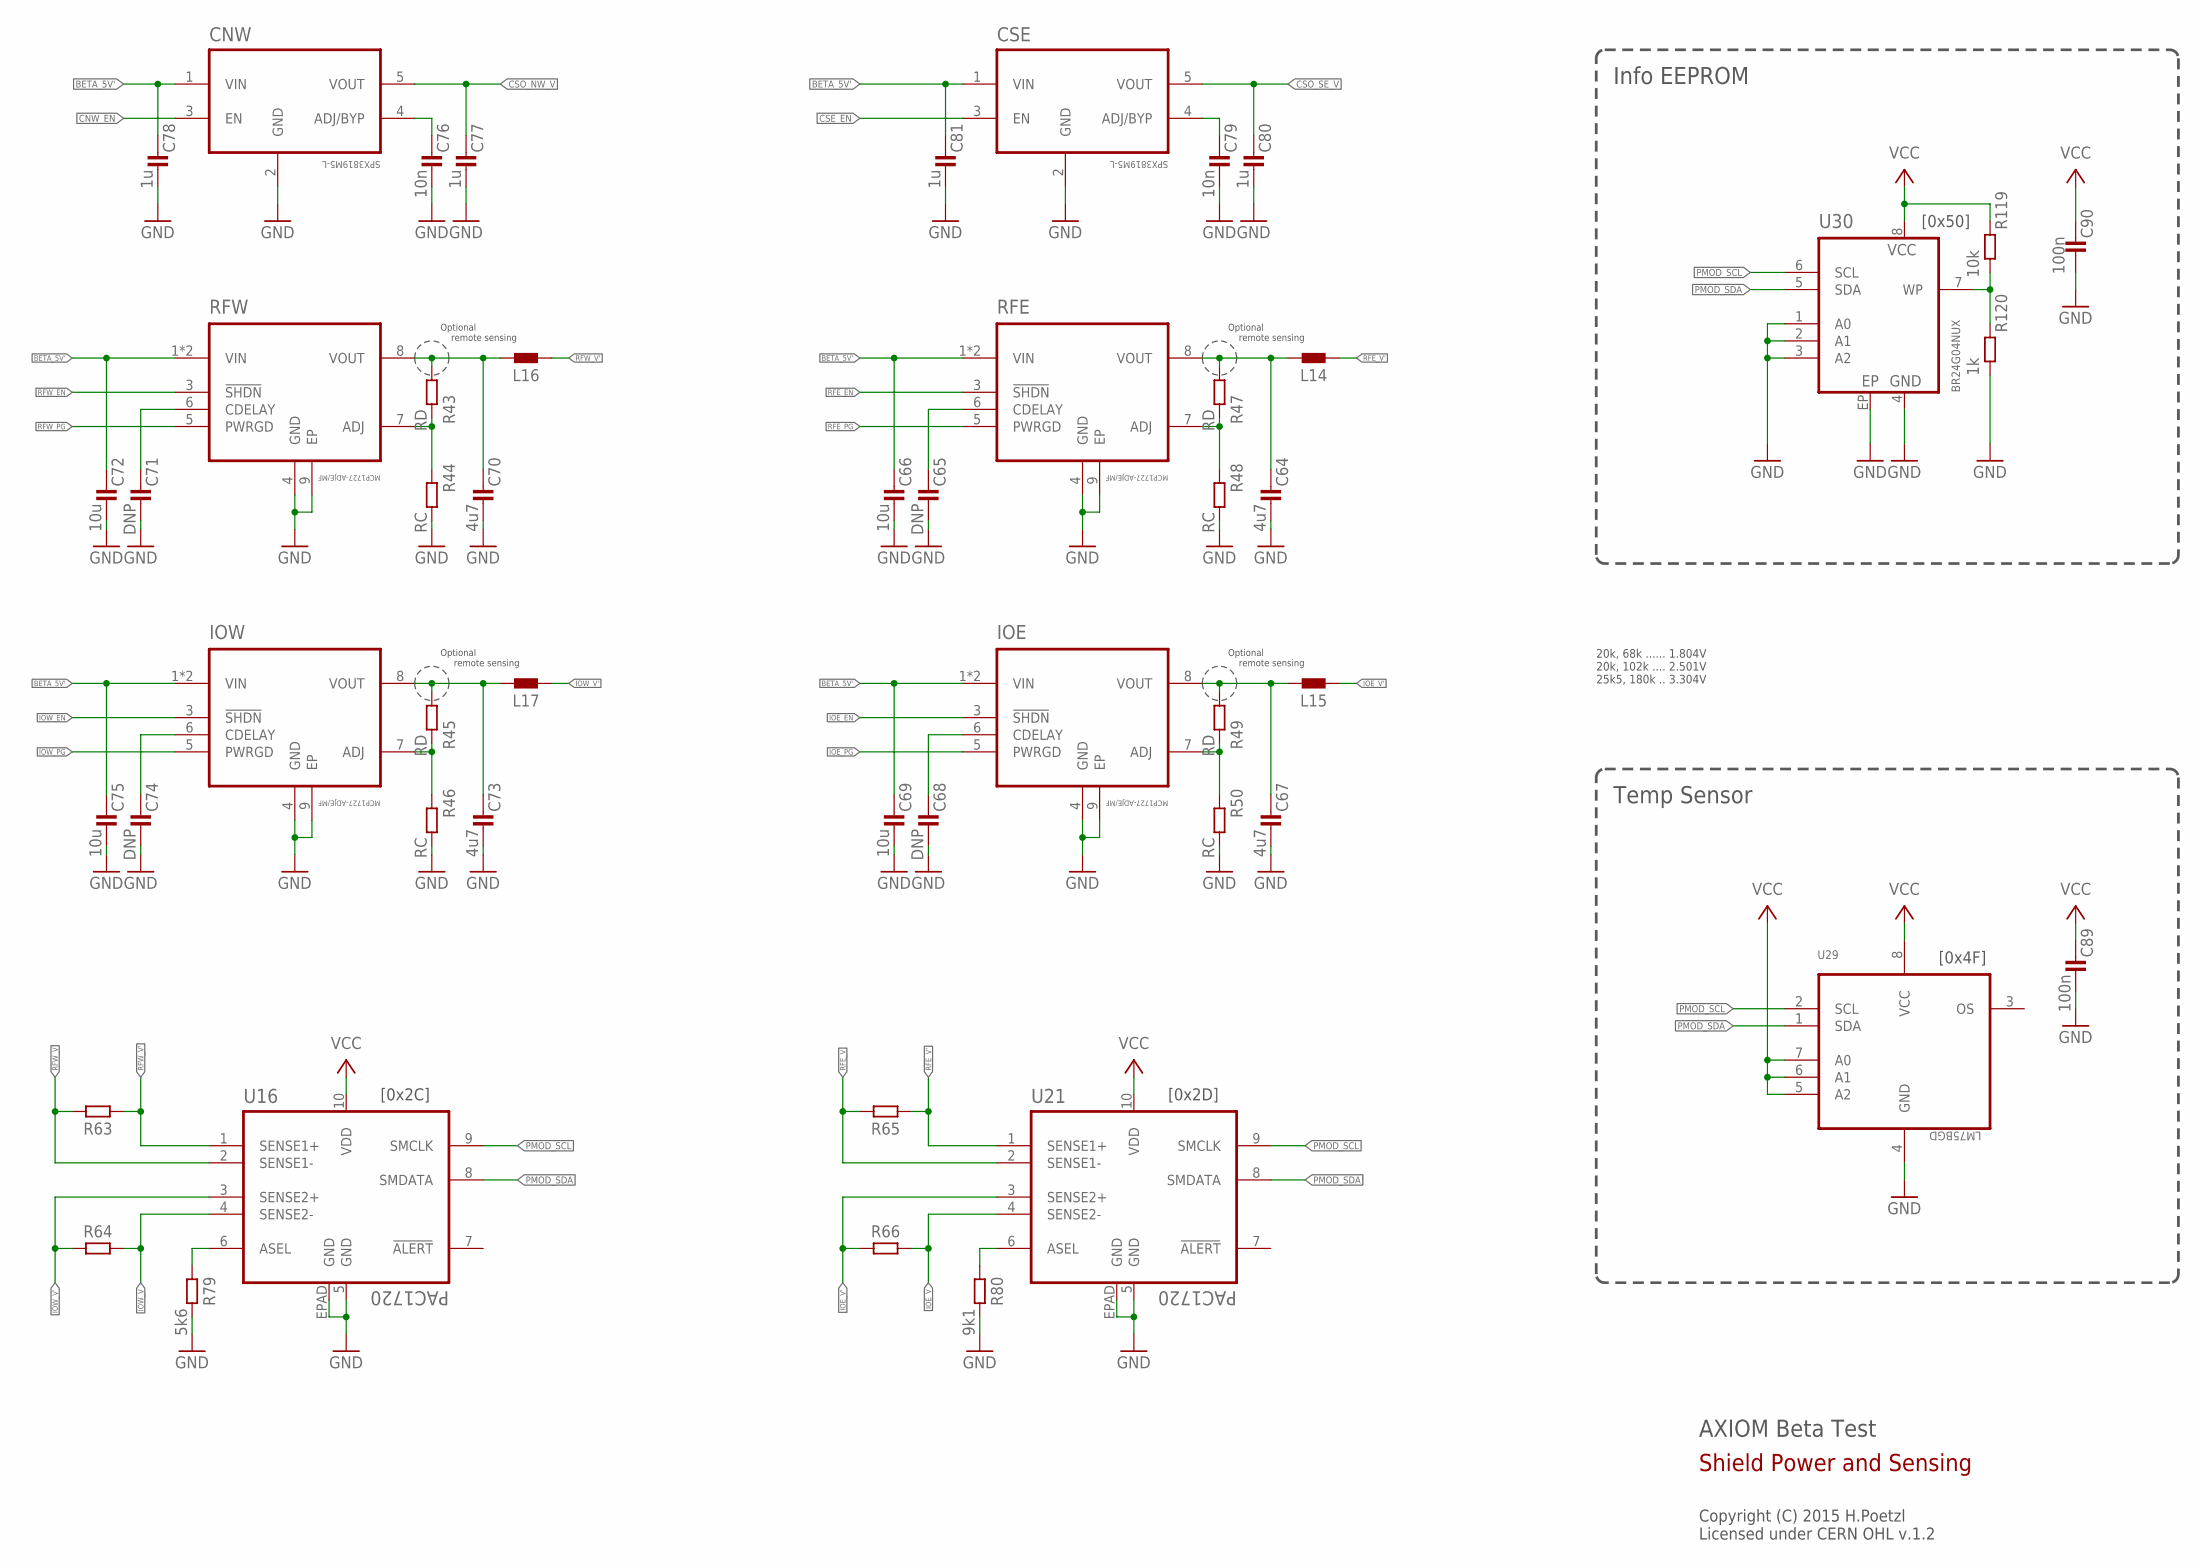
[picture p6: schematic axiom_beta_power_board_v0.23.sch, sheet 6]

Parts:
C64, C67, C70, C73: 4u7; 0603-B
C65, C68, C71, C74: DNP; 0402-B
C66, C69, C72, C75: 10u; 0603-B
C76, C79: 10n; 0402-B
C77, C78, C80, C81: 1u; 0402-B
C89, C90: 100n; 0402-B
CNW: SPX3819M5-L; SOT95P280X145-5N
CSE: SPX3819M5-L; SOT95P280X145-5N
IOE: MCP1727-ADJE/MF; DFN65P300X300X100-9N
IOW: MCP1727-ADJE/MF; DFN65P300X300X100-9N
L14, L15, L16, L17: L0805-B; 0805-B
R43, R45, R47, R49: RD; 0402-B
R44, R46, R48, R50: RC; 0402-B
R63, R64, R65, R66: R1206-B; 1206-B
R79: 5k6; 0402-B
R80: 9k1; 0402-B
R119: 10k; 0402-B
R120: 1k; 0402-B
RFE: MCP1727-ADJE/MF; DFN65P300X300X100-9N
RFW: MCP1727-ADJE/MF; DFN65P300X300X100-9N
U16, U21: PAC1720; DFN3X3_10LEAD
U29: LM75BGD; SOT996-2/3
U30: BR24G04NUX; DFN200X300X100-9N

Connections:
BETA_5V': C66.1, C69.1, C72.1, C75.1, C78.1, C81.1, CNW.1 (VIN), CSE.1 (VIN), IOE.1 (VIN), IOE.2 (VIN), IOW.1 (VIN), IOW.2 (VIN), RFE.1 (VIN), RFE.2 (VIN), RFW.1 (VIN), RFW.2 (VIN); also elsewhere on the board
CNW_EN: CNW.3 (EN); also elsewhere on the board
CSE_EN: CSE.3 (EN); also elsewhere on the board
CSO_NW_V: C77.1, CNW.5 (VOUT); also elsewhere on the board
CSO_SE_V: C80.1, CSE.5 (VOUT); also elsewhere on the board
GND: C64.2, C65.2, C66.2, C67.2, C68.2, C69.2, C70.2, C71.2, C72.2, C73.2, C74.2, C75.2, C76.2, C77.2, C78.2, C79.2, C80.2, C81.2, C89.2, C90.2, CNW.2 (GND), CSE.2 (GND), IOE.4 (GND), IOE.9 (EP), IOW.4 (GND), IOW.9 (EP), R44.2, R46.2, R48.2, R50.2, R79.2, R80.2, R120.2, RFE.4 (GND), RFE.9 (EP), RFW.4 (GND), RFW.9 (EP), U16.5 (GND), U16.EPAD (GND), U21.5 (GND), U21.EPAD (GND), U29.4 (GND), U30.1 (A0), U30.2 (A1), U30.3 (A2), U30.4 (GND), U30.EP; also elsewhere on the board
IOE_EN: IOE.3 (!SHDN); also elsewhere on the board
IOE_PG: IOE.5 (PWRGD); also elsewhere on the board
IOE_V: R66.2, U21.4 (SENSE2-); also elsewhere on the board
IOE_V': L15.2, R66.1, U21.3 (SENSE2+)
IOW_EN: IOW.3 (!SHDN); also elsewhere on the board
IOW_PG: IOW.5 (PWRGD); also elsewhere on the board
IOW_V: R64.2, U16.4 (SENSE2-); also elsewhere on the board
IOW_V': L17.2, R64.1, U16.3 (SENSE2+)
unnamed: R119.2, R120.1, U30.7 (WP)
unnamed: C64.1, L14.1, R47.1, RFE.8 (VOUT)
unnamed: R47.2, R48.1, RFE.7 (ADJ)
unnamed: C65.1, RFE.6 (CDELAY)
unnamed: C67.1, IOE.8 (VOUT), L15.1, R49.1
unnamed: IOE.7 (ADJ), R49.2, R50.1
unnamed: C68.1, IOE.6 (CDELAY)
unnamed: C70.1, L16.1, R43.1, RFW.8 (VOUT)
unnamed: R43.2, R44.1, RFW.7 (ADJ)
unnamed: C71.1, RFW.6 (CDELAY)
unnamed: C73.1, IOW.8 (VOUT), L17.1, R45.1
unnamed: IOW.7 (ADJ), R45.2, R46.1
unnamed: C74.1, IOW.6 (CDELAY)
unnamed: R79.1, U16.6 (ASEL)
unnamed: R80.1, U21.6 (ASEL)
unnamed: C76.1, CNW.4 (ADJ/BYP)
unnamed: C79.1, CSE.4 (ADJ/BYP)
PMOD_SCL: U16.9 (SMCLK), U21.9 (SMCLK), U29.2 (SCL), U30.6 (SCL); also elsewhere on the board
PMOD_SDA: U16.8 (SMDATA), U21.8 (SMDATA), U29.1 (SDA), U30.5 (SDA); also elsewhere on the board
RFE_EN: RFE.3 (!SHDN); also elsewhere on the board
RFE_PG: RFE.5 (PWRGD); also elsewhere on the board
RFE_V: R65.2, U21.2 (SENSE1-); also elsewhere on the board
RFE_V': L14.2, R65.1, U21.1 (SENSE1+)
RFW_EN: RFW.3 (!SHDN); also elsewhere on the board
RFW_PG: RFW.5 (PWRGD); also elsewhere on the board
RFW_V: R63.2, U16.2 (SENSE1-); also elsewhere on the board
RFW_V': L16.2, R63.1, U16.1 (SENSE1+)
VCC: C89.1, C90.1, R119.1, U16.10 (VDD), U21.10 (VDD), U29.5 (A2), U29.6 (A1), U29.7 (A0), U29.8 (VCC), U30.8 (VCC); also elsewhere on the board

Notes on the sheet:
Optional remote sensing
Optional remote sensing
AXIOM Beta Test
Copyright (C) 2015 H.Poetzl Licensed under CERN OHL v.1.2
Shield Power and Sensing
20k, 68k ...... 1.804V 20k, 102k .... 2.501V 25k5, 180k .. 3.304V
[0x2C]
[0x2D]
[0x4F]
Info EEPROM
[0x50]
Temp Sensor

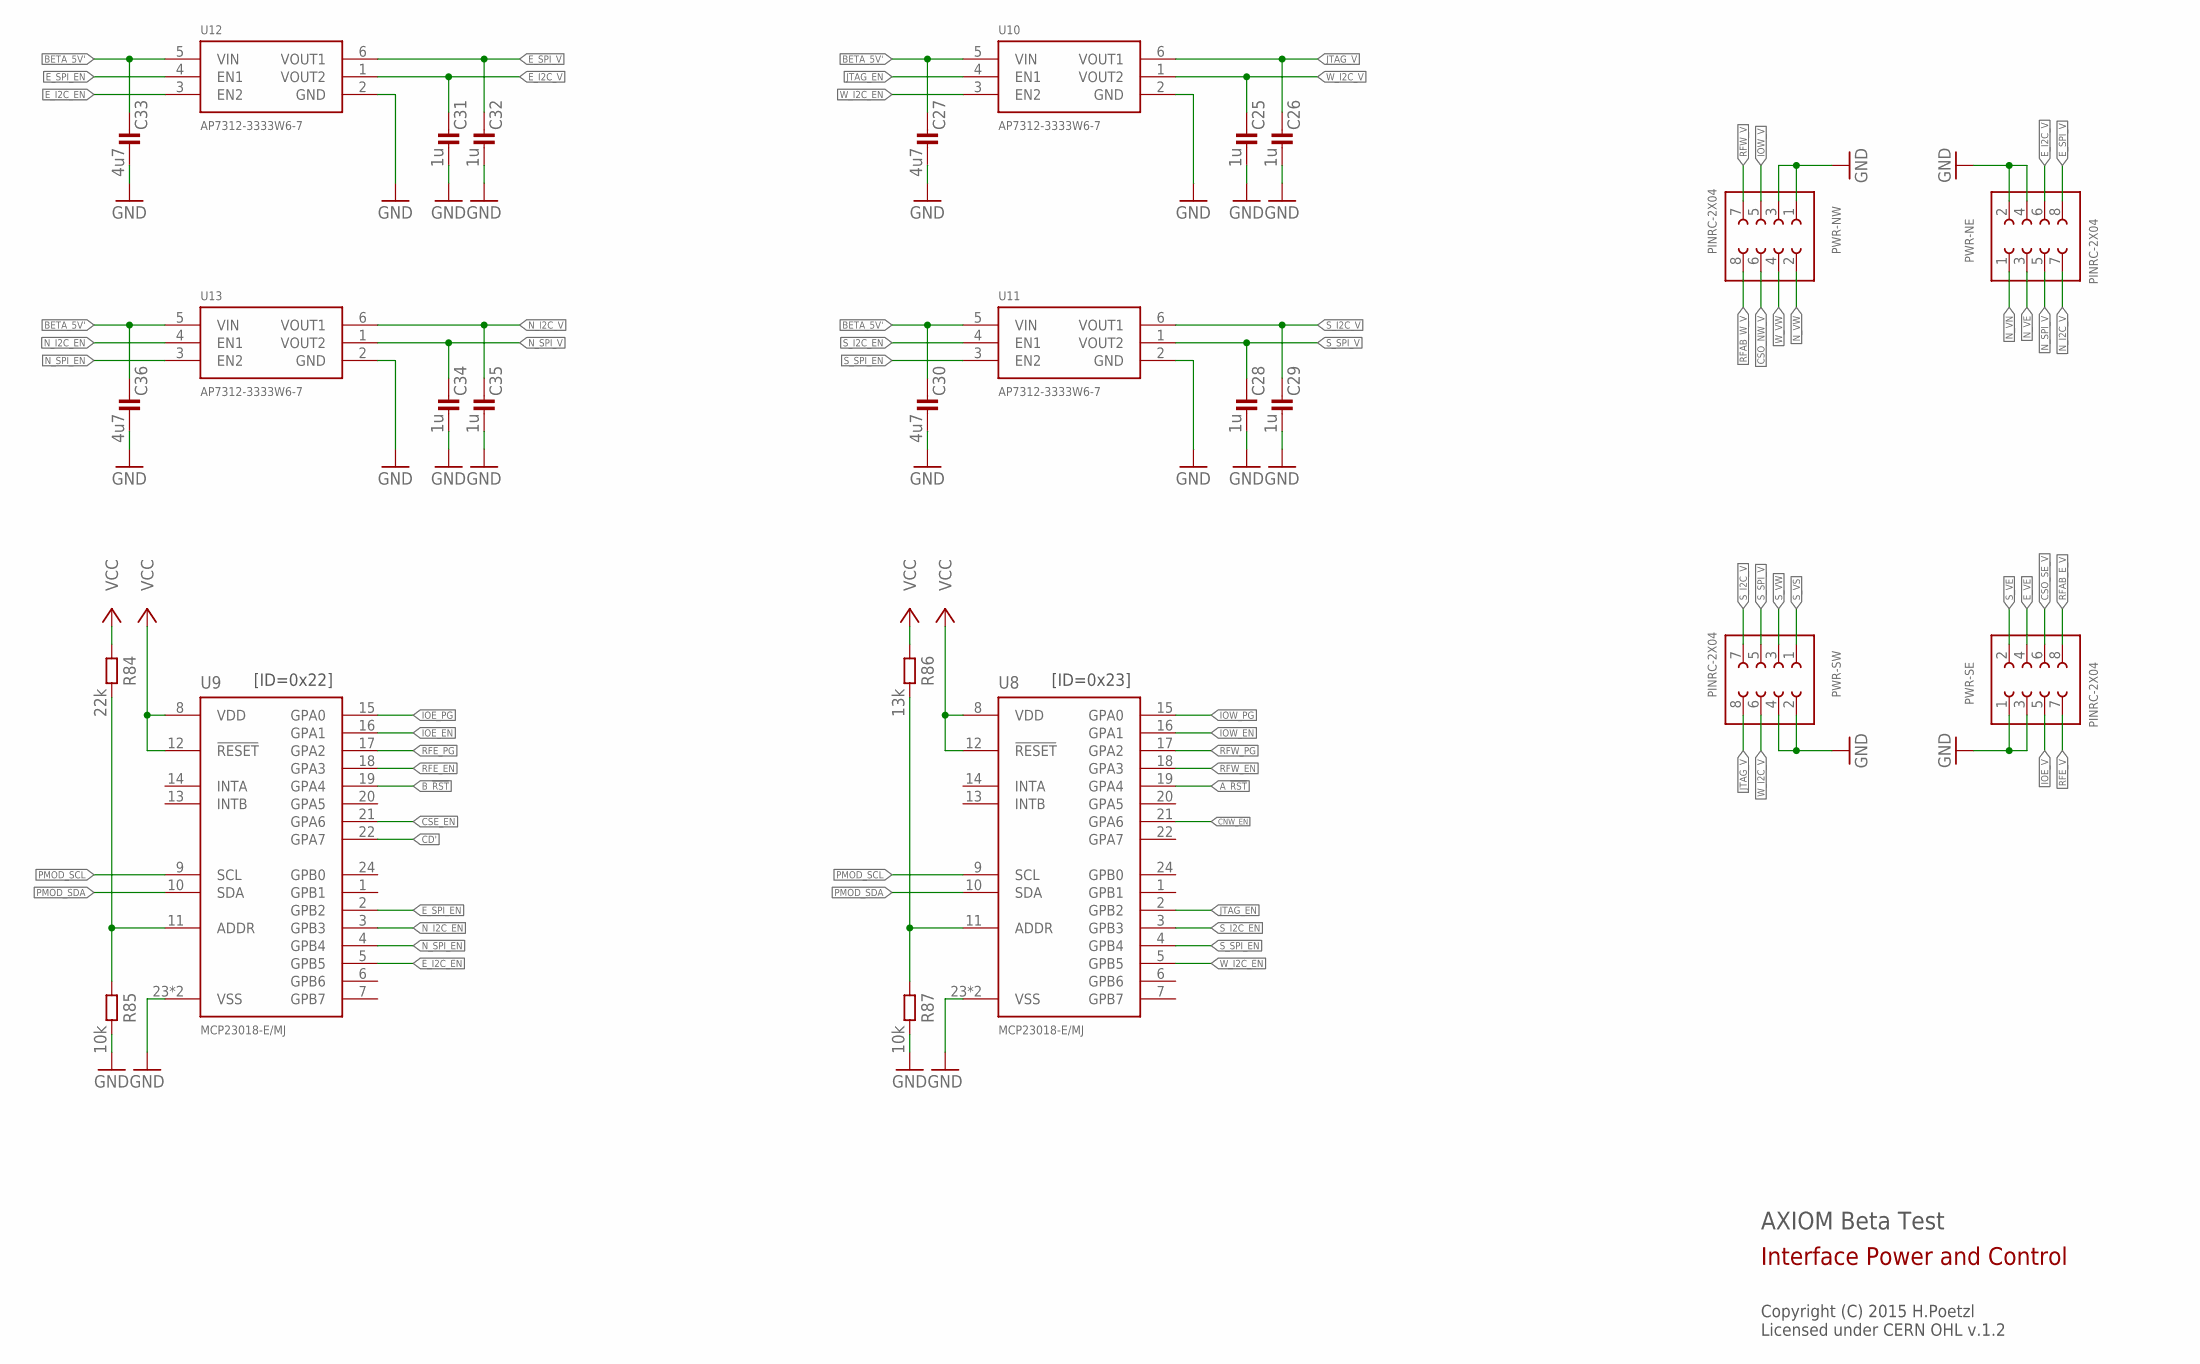
[picture p7: schematic axiom_beta_power_board_v0.23.sch, sheet 7]

Parts:
C25, C26, C28, C29, C31, C32, C34, C35: 1u; 0402-B
C27, C30, C33, C36: 4u7; 0603-B
PWR-NE: PINRC-2X04; R2X04
PWR-NW: PINRC-2X04; R2X04
PWR-SE: PINRC-2X04; R2X04
PWR-SW: PINRC-2X04; R2X04
R84: 22k; 0402-B
R85, R87: 10k; 0402-B
R86: 13k; 0402-B
U8, U9: MCP23018-E/MJ; QFN50P400X400X80-25N
U10, U11, U12, U13: AP7312-3333W6-7; SOT23-6

Connections:
A_!RST: U8.19 (GPA4); also elsewhere on the board
BETA_5V': C27.1, C30.1, C33.1, C36.1, U10.5 (VIN), U11.5 (VIN), U12.5 (VIN), U13.5 (VIN); also elsewhere on the board
B_!RST: U9.19 (GPA4); also elsewhere on the board
CD': U9.22 (GPA7); also elsewhere on the board
CNW_EN: U8.21 (GPA6); also elsewhere on the board
CSE_EN: U9.21 (GPA6); also elsewhere on the board
CSO_NW_V: PWR-NW.6; also elsewhere on the board
CSO_SE_V: PWR-SE.6; also elsewhere on the board
E_I2C_EN: U9.5 (GPB5), U12.3 (EN2)
E_I2C_V: C31.1, PWR-NE.6, U12.1 (VOUT2)
E_SPI_EN: U9.2 (GPB2), U12.4 (EN1)
E_SPI_V: C32.1, PWR-NE.8, U12.6 (VOUT1)
E_VE: PWR-SE.4; also elsewhere on the board
GND: C25.2, C26.2, C27.2, C28.2, C29.2, C30.2, C31.2, C32.2, C33.2, C34.2, C35.2, C36.2, PWR-NE.2, PWR-NE.4, PWR-NW.1, PWR-NW.3, PWR-SE.1, PWR-SE.3, PWR-SW.2, PWR-SW.4, R85.2, R87.2, U8.23 (VSS), U8.25 (VSS), U9.23 (VSS), U9.25 (VSS), U10.2 (GND), U11.2 (GND), U12.2 (GND), U13.2 (GND); also elsewhere on the board
IOE_EN: U9.16 (GPA1); also elsewhere on the board
IOE_PG: U9.15 (GPA0); also elsewhere on the board
IOE_V: PWR-SE.5; also elsewhere on the board
IOW_EN: U8.16 (GPA1); also elsewhere on the board
IOW_PG: U8.15 (GPA0); also elsewhere on the board
IOW_V: PWR-NW.5; also elsewhere on the board
JTAG_EN: U8.2 (GPB2), U10.4 (EN1)
JTAG_V: C26.1, PWR-SW.8, U10.6 (VOUT1)
unnamed: R84.2, R85.1, U9.11 (ADDR)
unnamed: R86.2, R87.1, U8.11 (ADDR)
N_I2C_EN: U9.3 (GPB3), U13.4 (EN1)
N_I2C_V: C35.1, PWR-NE.7, U13.6 (VOUT1)
N_SPI_EN: U9.4 (GPB4), U13.3 (EN2)
N_SPI_V: C34.1, PWR-NE.5, U13.1 (VOUT2)
N_VE: PWR-NE.3; also elsewhere on the board
N_VN: PWR-NE.1; also elsewhere on the board
N_VW: PWR-NW.2; also elsewhere on the board
PMOD_SCL: U8.9 (SCL), U9.9 (SCL); also elsewhere on the board
PMOD_SDA: U8.10 (SDA), U9.10 (SDA); also elsewhere on the board
RFAB_E_V: PWR-SE.8
RFAB_W_V: PWR-NW.8
RFE_EN: U9.18 (GPA3); also elsewhere on the board
RFE_PG: U9.17 (GPA2); also elsewhere on the board
RFE_V: PWR-SE.7; also elsewhere on the board
RFW_EN: U8.18 (GPA3); also elsewhere on the board
RFW_PG: U8.17 (GPA2); also elsewhere on the board
RFW_V: PWR-NW.7; also elsewhere on the board
S_I2C_EN: U8.3 (GPB3), U11.4 (EN1)
S_I2C_V: C29.1, PWR-SW.7, U11.6 (VOUT1)
S_SPI_EN: U8.4 (GPB4), U11.3 (EN2)
S_SPI_V: C28.1, PWR-SW.5, U11.1 (VOUT2)
S_VE: PWR-SE.2; also elsewhere on the board
S_VS: PWR-SW.1; also elsewhere on the board
S_VW: PWR-SW.3; also elsewhere on the board
VCC: R84.1, R86.1, U8.8 (VDD), U8.12 (!RESET), U9.8 (VDD), U9.12 (!RESET); also elsewhere on the board
W_I2C_EN: U8.5 (GPB5), U10.3 (EN2)
W_I2C_V: C25.1, PWR-SW.6, U10.1 (VOUT2)
W_VW: PWR-NW.4; also elsewhere on the board

Notes on the sheet:
AXIOM Beta Test
Copyright (C) 2015 H.Poetzl Licensed under CERN OHL v.1.2
Interface Power and Control
[ID=0x22]
[ID=0x23]

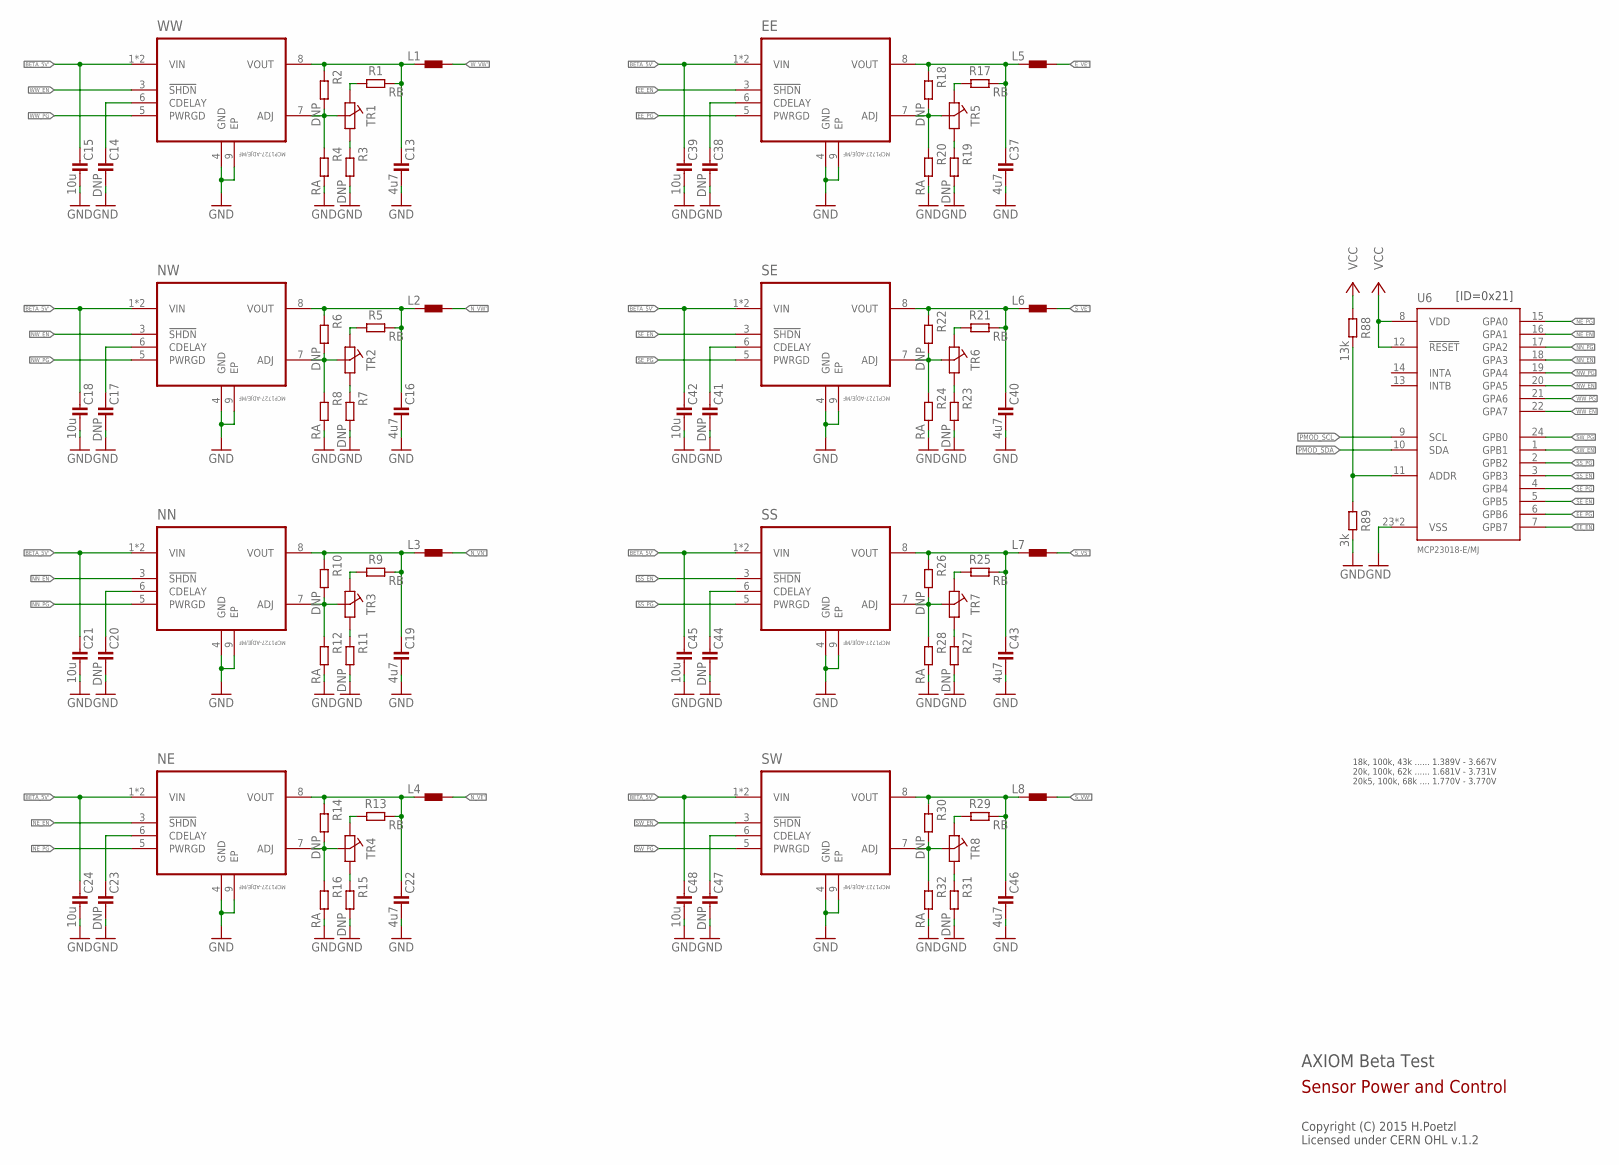
[picture p8: schematic axiom_beta_power_board_v0.23.sch, sheet 8]

Parts:
C13, C16, C19, C22, C37, C40, C43, C46: 4u7; 0603-B
C14, C17, C20, C23, C38, C41, C44, C47: DNP; 0402-B
C15, C18, C21, C24, C39, C42, C45, C48: 10u; 0603-B
EE: MCP1727-ADJE/MF; DFN65P300X300X100-9N
L1, L2, L3, L4, L5, L6, L7, L8: L0805-B; 0805-B
NE: MCP1727-ADJE/MF; DFN65P300X300X100-9N
NN: MCP1727-ADJE/MF; DFN65P300X300X100-9N
NW: MCP1727-ADJE/MF; DFN65P300X300X100-9N
R1, R5, R9, R13, R17, R21, R25, R29: RB; 0402-B
R2, R3, R6, R7, R10, R11, R14, R15, R18, R19, R22, R23, R26, R27, R30, R31: DNP; 0402-B
R4, R8, R12, R16, R20, R24, R28, R32: RA; 0402-B
R88: 13k; 0402-B
R89: 3k; 0402-B
SE: MCP1727-ADJE/MF; DFN65P300X300X100-9N
SS: MCP1727-ADJE/MF; DFN65P300X300X100-9N
SW: MCP1727-ADJE/MF; DFN65P300X300X100-9N
TR1, TR2, TR3, TR4, TR5, TR6, TR7, TR8: PVZ2A; TRIM-PVZ2A
U6: MCP23018-E/MJ; QFN50P400X400X80-25N
WW: MCP1727-ADJE/MF; DFN65P300X300X100-9N

Connections:
BETA_5V': C15.1, C18.1, C21.1, C24.1, C39.1, C42.1, C45.1, C48.1, EE.1 (VIN), EE.2 (VIN), NE.1 (VIN), NE.2 (VIN), NN.1 (VIN), NN.2 (VIN), NW.1 (VIN), NW.2 (VIN), SE.1 (VIN), SE.2 (VIN), SS.1 (VIN), SS.2 (VIN), SW.1 (VIN), SW.2 (VIN), WW.1 (VIN), WW.2 (VIN); also elsewhere on the board
EE_EN: EE.3 (!SHDN), U6.7 (GPB7)
EE_PG: EE.5 (PWRGD), U6.6 (GPB6)
E_VE': L5.2; also elsewhere on the board
GND: C13.2, C14.2, C15.2, C16.2, C17.2, C18.2, C19.2, C20.2, C21.2, C22.2, C23.2, C24.2, C37.2, C38.2, C39.2, C40.2, C41.2, C42.2, C43.2, C44.2, C45.2, C46.2, C47.2, C48.2, EE.4 (GND), EE.9 (EP), NE.4 (GND), NE.9 (EP), NN.4 (GND), NN.9 (EP), NW.4 (GND), NW.9 (EP), R3.2, R4.2, R7.2, R8.2, R11.2, R12.2, R15.2, R16.2, R19.2, R20.2, R23.2, R24.2, R27.2, R28.2, R31.2, R32.2, R89.2, SE.4 (GND), SE.9 (EP), SS.4 (GND), SS.9 (EP), SW.4 (GND), SW.9 (EP), U6.23 (VSS), U6.25 (VSS), WW.4 (GND), WW.9 (EP); also elsewhere on the board
unnamed: C13.1, L1.1, R1.2, R2.1, WW.8 (VOUT)
unnamed: R2.2, R4.1, TR1.2 (B), WW.7 (ADJ)
unnamed: R3.1, TR1.1 (A)
unnamed: C14.1, WW.6 (CDELAY)
unnamed: R1.1, TR1.3 (C)
unnamed: C16.1, L2.1, NW.8 (VOUT), R5.2, R6.1
unnamed: NW.7 (ADJ), R6.2, R8.1, TR2.2 (B)
unnamed: R7.1, TR2.1 (A)
unnamed: C17.1, NW.6 (CDELAY)
unnamed: C19.1, L3.1, NN.8 (VOUT), R9.2, R10.1
unnamed: NN.7 (ADJ), R10.2, R12.1, TR3.2 (B)
unnamed: R5.1, TR2.3 (C)
unnamed: C20.1, NN.6 (CDELAY)
unnamed: C22.1, L4.1, NE.8 (VOUT), R13.2, R14.1
unnamed: NE.7 (ADJ), R14.2, R16.1, TR4.2 (B)
unnamed: R11.1, TR3.1 (A)
unnamed: C23.1, NE.6 (CDELAY)
unnamed: C37.1, EE.8 (VOUT), L5.1, R17.2, R18.1
unnamed: EE.7 (ADJ), R18.2, R20.1, TR5.2 (B)
unnamed: R9.1, TR3.3 (C)
unnamed: C38.1, EE.6 (CDELAY)
unnamed: R15.1, TR4.1 (A)
unnamed: C40.1, L6.1, R21.2, R22.1, SE.8 (VOUT)
unnamed: R22.2, R24.1, SE.7 (ADJ), TR6.2 (B)
unnamed: R13.1, TR4.3 (C)
unnamed: C41.1, SE.6 (CDELAY)
unnamed: R19.1, TR5.1 (A)
unnamed: C43.1, L7.1, R25.2, R26.1, SS.8 (VOUT)
unnamed: R26.2, R28.1, SS.7 (ADJ), TR7.2 (B)
unnamed: R17.1, TR5.3 (C)
unnamed: C44.1, SS.6 (CDELAY)
unnamed: R23.1, TR6.1 (A)
unnamed: C46.1, L8.1, R29.2, R30.1, SW.8 (VOUT)
unnamed: R30.2, R32.1, SW.7 (ADJ), TR8.2 (B)
unnamed: R21.1, TR6.3 (C)
unnamed: C47.1, SW.6 (CDELAY)
unnamed: R27.1, TR7.1 (A)
unnamed: R25.1, TR7.3 (C)
unnamed: R31.1, TR8.1 (A)
unnamed: R29.1, TR8.3 (C)
unnamed: R88.2, R89.1, U6.11 (ADDR)
NE_EN: NE.3 (!SHDN), U6.16 (GPA1)
NE_PG: NE.5 (PWRGD), U6.15 (GPA0)
NN_EN: NN.3 (!SHDN), U6.18 (GPA3)
NN_PG: NN.5 (PWRGD), U6.17 (GPA2)
NW_EN: NW.3 (!SHDN), U6.20 (GPA5)
NW_PG: NW.5 (PWRGD), U6.19 (GPA4)
N_VE': L4.2; also elsewhere on the board
N_VN': L3.2; also elsewhere on the board
N_VW': L2.2; also elsewhere on the board
PMOD_SCL: U6.9 (SCL); also elsewhere on the board
PMOD_SDA: U6.10 (SDA); also elsewhere on the board
SE_EN: SE.3 (!SHDN), U6.5 (GPB5)
SE_PG: SE.5 (PWRGD), U6.4 (GPB4)
SS_EN: SS.3 (!SHDN), U6.3 (GPB3)
SS_PG: SS.5 (PWRGD), U6.2 (GPB2)
SW_EN: SW.3 (!SHDN), U6.1 (GPB1)
SW_PG: SW.5 (PWRGD), U6.24 (GPB0)
S_VE': L6.2; also elsewhere on the board
S_VS': L7.2; also elsewhere on the board
S_VW': L8.2; also elsewhere on the board
VCC: R88.1, U6.8 (VDD), U6.12 (!RESET); also elsewhere on the board
WW_EN: U6.22 (GPA7), WW.3 (!SHDN)
WW_PG: U6.21 (GPA6), WW.5 (PWRGD)
W_VW': L1.2; also elsewhere on the board

Notes on the sheet:
AXIOM Beta Test
Copyright (C) 2015 H.Poetzl Licensed under CERN OHL v.1.2
Sensor Power and Control
[ID=0x21]
18k, 100k, 43k ...... 1.389V - 3.667V 20k, 100k, 62k ...... 1.681V - 3.731V 20k5, 100k, 68k .... 1.770V - 3.770V
