apertus-open-source-cinema/pcbs/boards/axiom_beta_power_board_v0.23.brd

## EAGLE design boards/axiom_beta_power_board_v0.23.brd (continued)

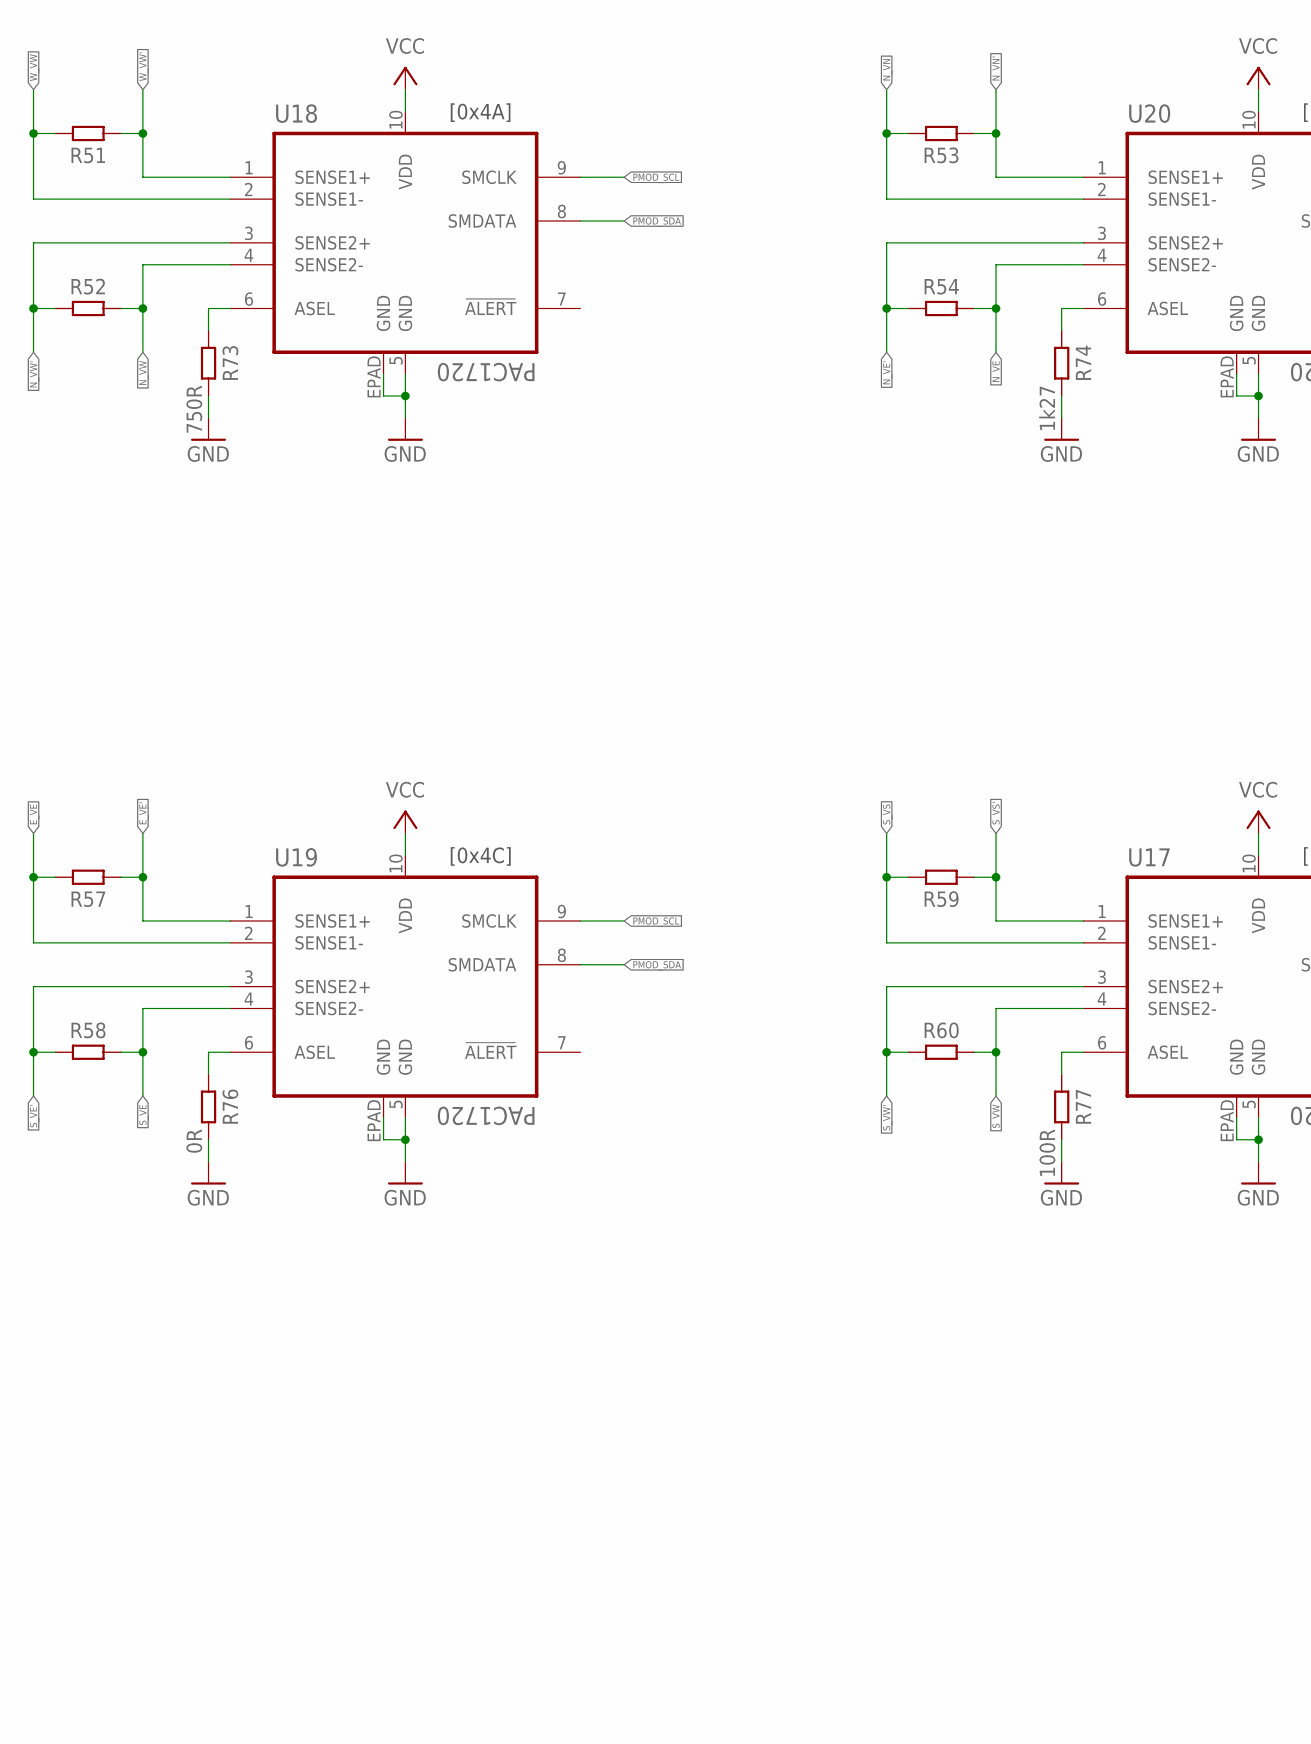
[picture p9: schematic axiom_beta_power_board_v0.23.sch, sheet 9, part in row 1, column 1]

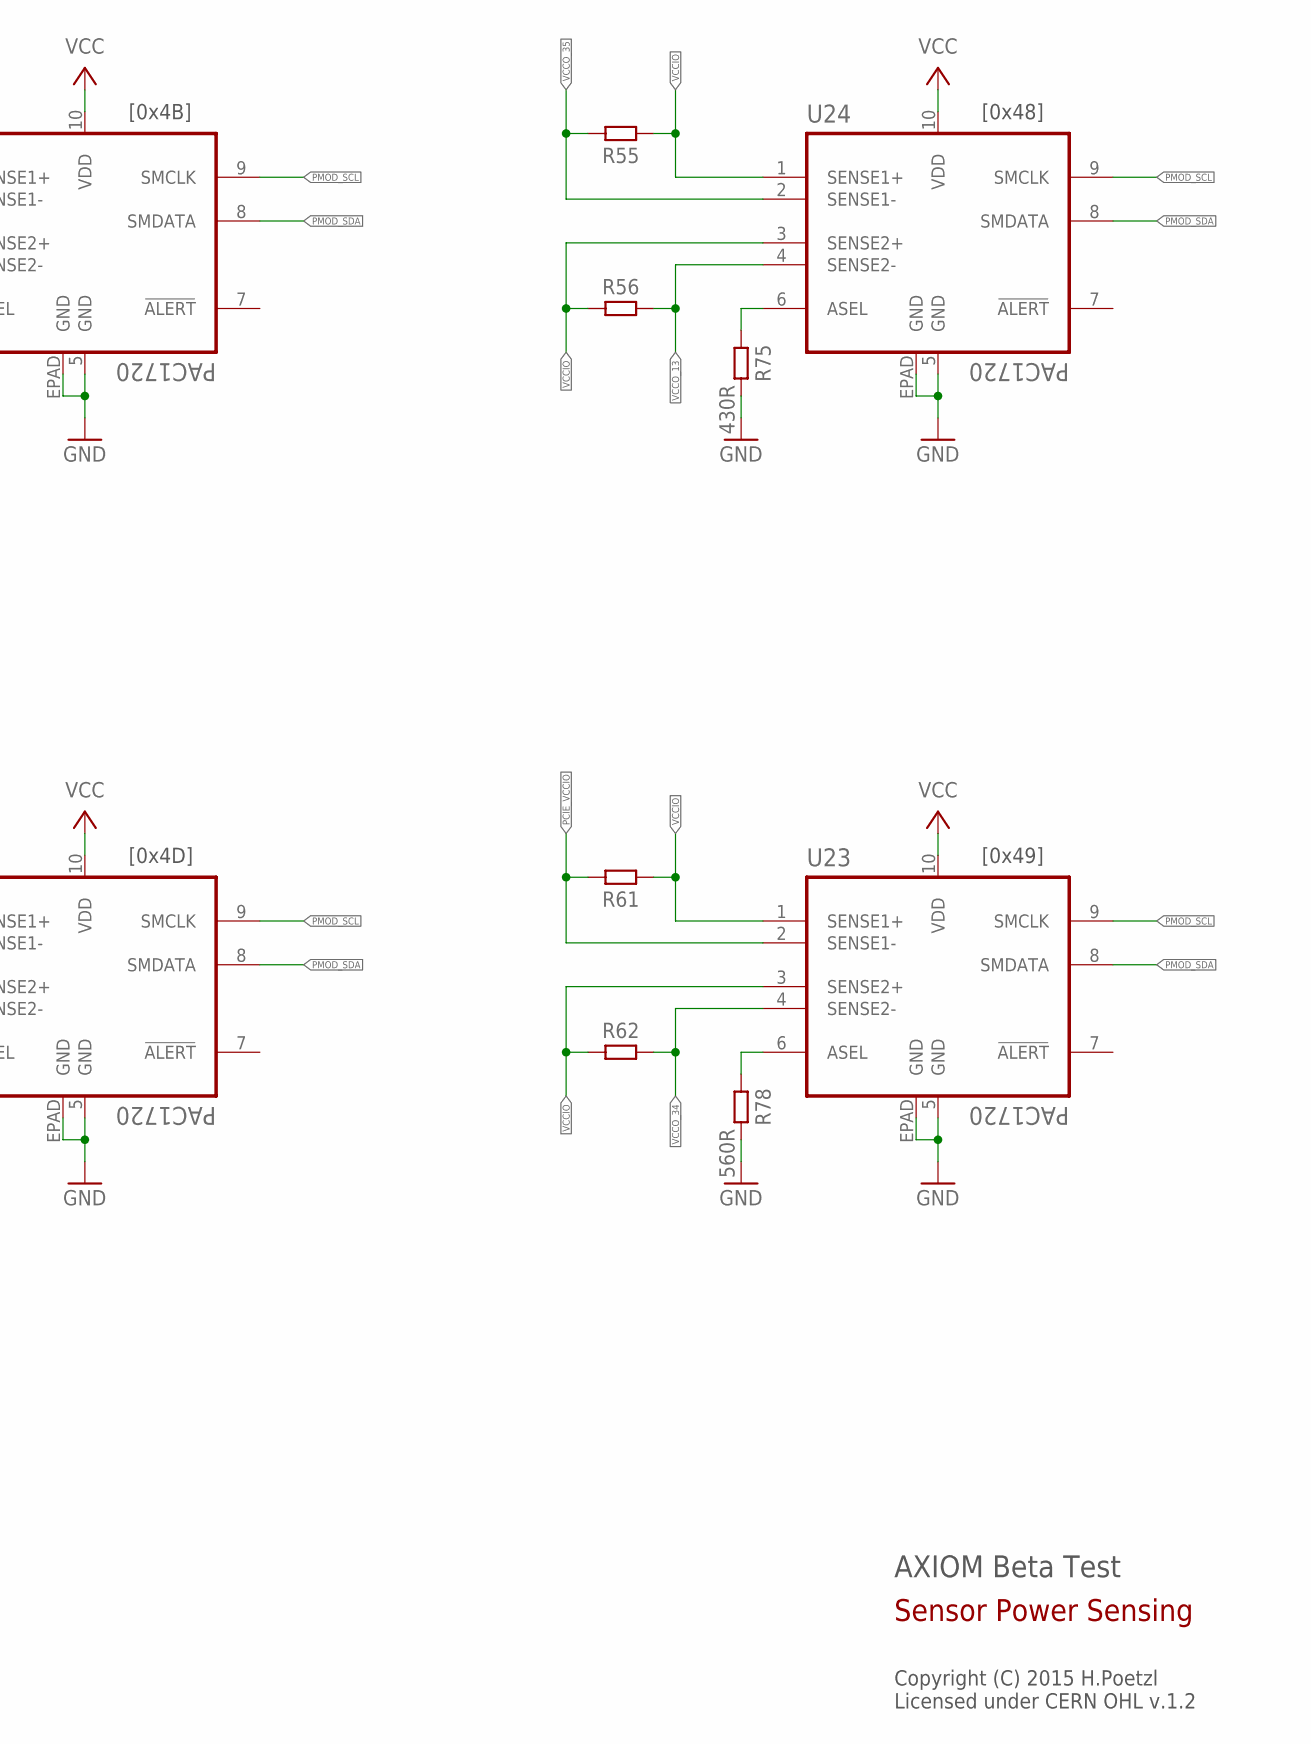
[picture p10: schematic axiom_beta_power_board_v0.23.sch, sheet 9, part in row 1, column 2]

Parts:
R51, R52, R53, R54, R55, R56, R57, R58, R59, R60, R61, R62: R1206-B; 1206-B
R73: 750R; 0402-B
R74: 1k27; 0402-B
R75: 430R; 0402-B
R76: 0R; 0402-B
R77: 100R; 0402-B
R78: 560R; 0402-B
U17, U18, U19, U20, U23, U24: PAC1720; DFN3X3_10LEAD

Connections:
E_VE: R57.2, U19.2 (SENSE1-); also elsewhere on the board
E_VE': R57.1, U19.1 (SENSE1+); also elsewhere on the board
GND: R73.2, R74.2, R75.2, R76.2, R77.2, R78.2, U17.5 (GND), U17.EPAD (GND), U18.5 (GND), U18.EPAD (GND), U19.5 (GND), U19.EPAD (GND), U20.5 (GND), U20.EPAD (GND), U23.5 (GND), U23.EPAD (GND), U24.5 (GND), U24.EPAD (GND); also elsewhere on the board
unnamed: R73.1, U18.6 (ASEL)
unnamed: R75.1, U24.6 (ASEL)
unnamed: R78.1, U23.6 (ASEL)
unnamed: R74.1, U20.6 (ASEL)
unnamed: R76.1, U19.6 (ASEL)
unnamed: R77.1, U17.6 (ASEL)
N_VE: R54.2, U20.4 (SENSE2-); also elsewhere on the board
N_VE': R54.1, U20.3 (SENSE2+); also elsewhere on the board
N_VN: R53.2, U20.2 (SENSE1-); also elsewhere on the board
N_VN': R53.1, U20.1 (SENSE1+); also elsewhere on the board
N_VW: R52.2, U18.4 (SENSE2-); also elsewhere on the board
N_VW': R52.1, U18.3 (SENSE2+); also elsewhere on the board
PCIE_VCCIO: R61.2, U23.2 (SENSE1-)
PMOD_SCL: U17.9 (SMCLK), U18.9 (SMCLK), U19.9 (SMCLK), U20.9 (SMCLK), U23.9 (SMCLK), U24.9 (SMCLK); also elsewhere on the board
PMOD_SDA: U17.8 (SMDATA), U18.8 (SMDATA), U19.8 (SMDATA), U20.8 (SMDATA), U23.8 (SMDATA), U24.8 (SMDATA); also elsewhere on the board
S_VE: R58.2, U19.4 (SENSE2-); also elsewhere on the board
S_VE': R58.1, U19.3 (SENSE2+); also elsewhere on the board
S_VS: R59.2, U17.2 (SENSE1-); also elsewhere on the board
S_VS': R59.1, U17.1 (SENSE1+); also elsewhere on the board
S_VW: R60.2, U17.4 (SENSE2-); also elsewhere on the board
S_VW': R60.1, U17.3 (SENSE2+); also elsewhere on the board
VCC: U17.10 (VDD), U18.10 (VDD), U19.10 (VDD), U20.10 (VDD), U23.10 (VDD), U24.10 (VDD); also elsewhere on the board
VCCIO: R55.1, R56.1, R61.1, R62.1, U23.1 (SENSE1+), U23.3 (SENSE2+), U24.1 (SENSE1+), U24.3 (SENSE2+); also elsewhere on the board
VCCO_13: R56.2, U24.4 (SENSE2-); also elsewhere on the board
VCCO_34: R62.2, U23.4 (SENSE2-); also elsewhere on the board
VCCO_35: R55.2, U24.2 (SENSE1-); also elsewhere on the board
W_VW: R51.2, U18.2 (SENSE1-); also elsewhere on the board
W_VW': R51.1, U18.1 (SENSE1+); also elsewhere on the board

Notes on the sheet:
AXIOM Beta Test
Copyright (C) 2015 H.Poetzl Licensed under CERN OHL v.1.2
Sensor Power Sensing
[0x48]
[0x49]
[0x4B]
[0x4D]
[0x4A]
[0x4C]

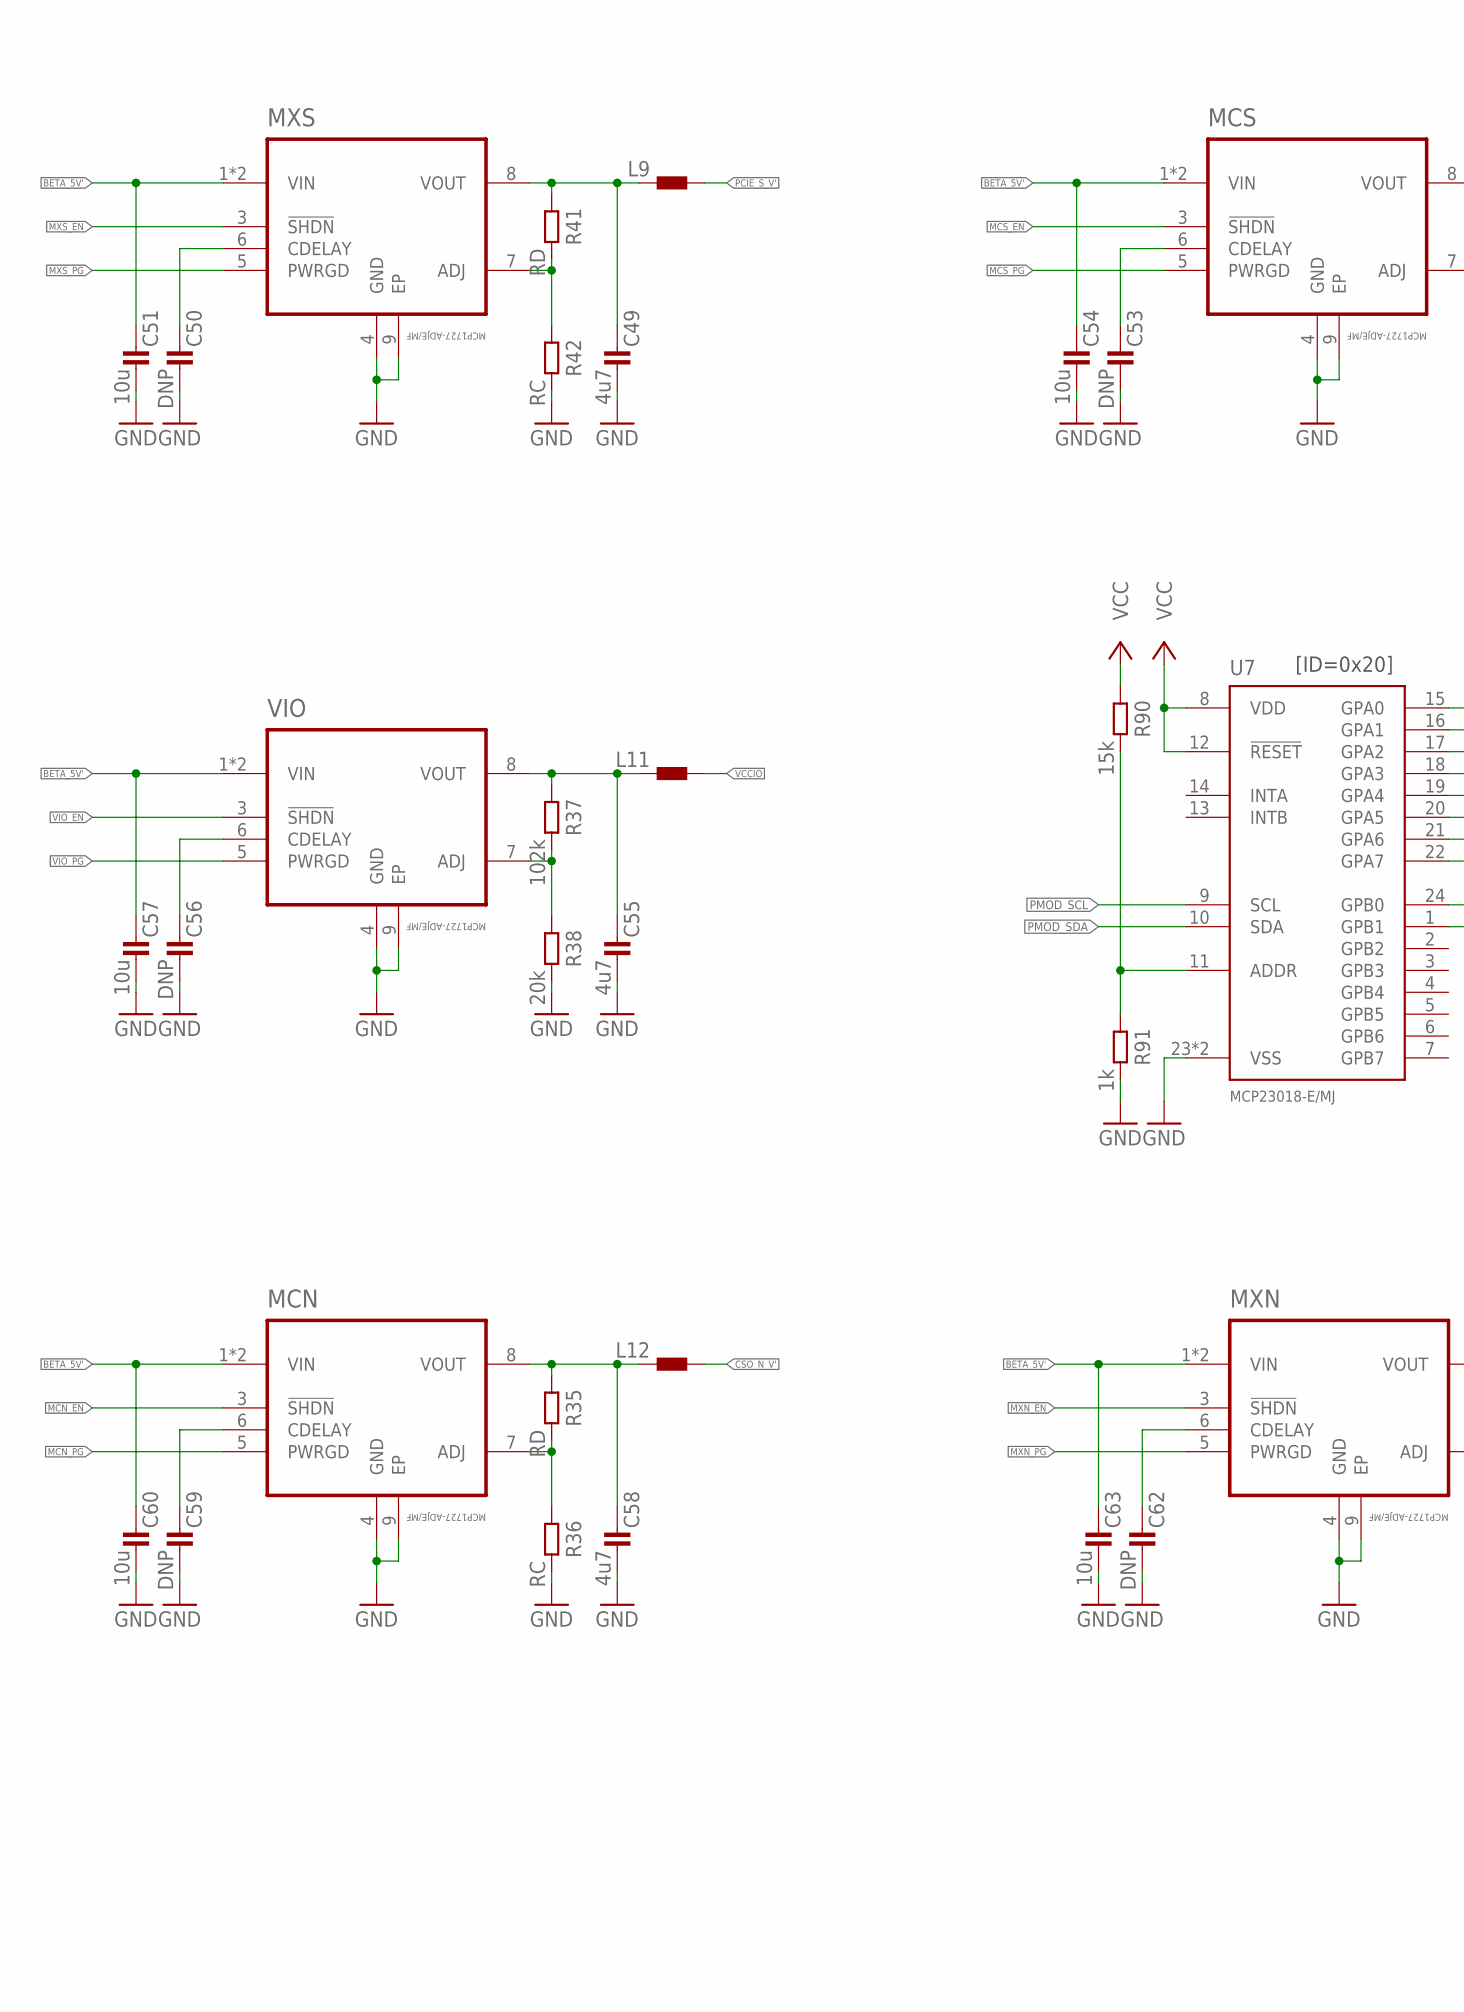
[picture p11: schematic axiom_beta_power_board_v0.23.sch, sheet 10, part in row 1, column 1]

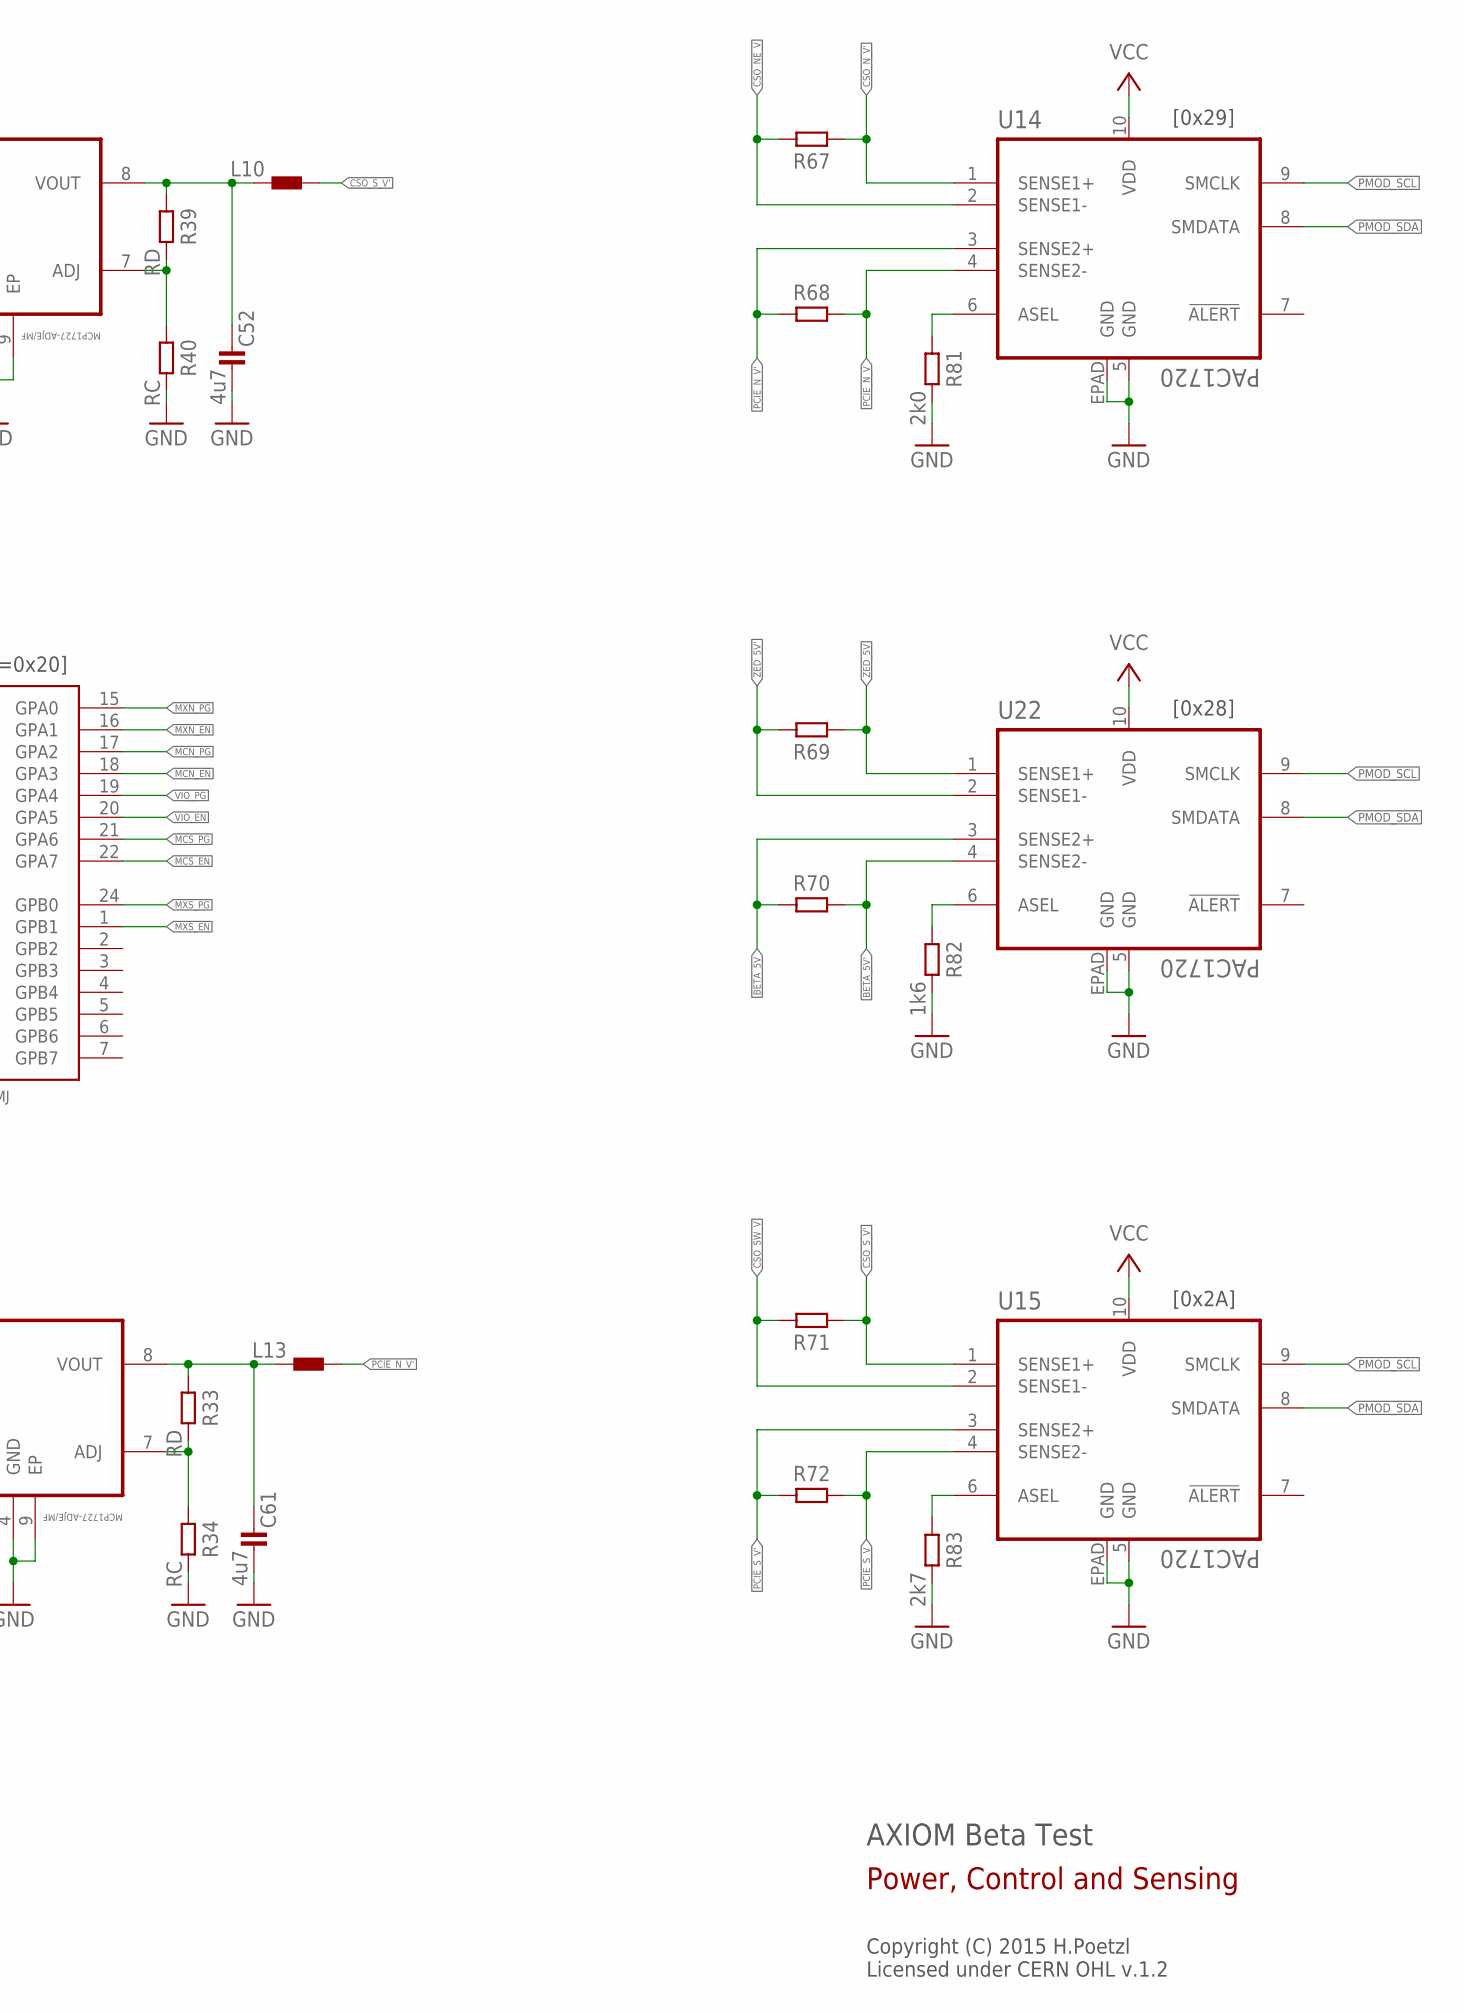
[picture p12: schematic axiom_beta_power_board_v0.23.sch, sheet 10, part in row 1, column 2]

Parts:
C49, C52, C55, C58, C61: 4u7; 0603-B
C50, C53, C56, C59, C62: DNP; 0402-B
C51, C54, C57, C60, C63: 10u; 0603-B
L9, L10, L11, L12, L13: L0805-A; 0805-A
MCN: MCP1727-ADJE/MF; DFN65P300X300X100-9N
MCS: MCP1727-ADJE/MF; DFN65P300X300X100-9N
MXN: MCP1727-ADJE/MF; DFN65P300X300X100-9N
MXS: MCP1727-ADJE/MF; DFN65P300X300X100-9N
R33, R35, R39, R41: RD; 0402-B
R34, R36, R40, R42: RC; 0402-B
R37: 102k; 0402-B
R38: 20k; 0402-B
R67, R68, R69, R70, R71, R72: R1206-B; 1206-B
R81: 2k0; 0402-B
R82: 1k6; 0402-B
R83: 2k7; 0402-B
R90: 15k; 0402-B
R91: 1k; 0402-B
U7: MCP23018-E/MJ; QFN50P400X400X80-25N
U14, U15, U22: PAC1720; DFN3X3_10LEAD
VIO: MCP1727-ADJE/MF; DFN65P300X300X100-9N

Connections:
BETA_5V: R70.1, U22.3 (SENSE2+); also elsewhere on the board
BETA_5V': C51.1, C54.1, C57.1, C60.1, C63.1, MCN.1 (VIN), MCN.2 (VIN), MCS.1 (VIN), MCS.2 (VIN), MXN.1 (VIN), MXN.2 (VIN), MXS.1 (VIN), MXS.2 (VIN), R70.2, U22.4 (SENSE2-), VIO.1 (VIN), VIO.2 (VIN); also elsewhere on the board
CSO_NE_V: R67.2, U14.2 (SENSE1-); also elsewhere on the board
CSO_N_V': L12.2, R67.1, U14.1 (SENSE1+)
CSO_SW_V: R71.2, U15.2 (SENSE1-); also elsewhere on the board
CSO_S_V': L10.2, R71.1, U15.1 (SENSE1+)
GND: C49.2, C50.2, C51.2, C52.2, C53.2, C54.2, C55.2, C56.2, C57.2, C58.2, C59.2, C60.2, C61.2, C62.2, C63.2, MCN.4 (GND), MCN.9 (EP), MCS.4 (GND), MCS.9 (EP), MXN.4 (GND), MXN.9 (EP), MXS.4 (GND), MXS.9 (EP), R34.2, R36.2, R38.2, R40.2, R42.2, R81.2, R82.2, R83.2, R91.2, U7.23 (VSS), U7.25 (VSS), U14.5 (GND), U14.EPAD (GND), U15.5 (GND), U15.EPAD (GND), U22.5 (GND), U22.EPAD (GND), VIO.4 (GND), VIO.9 (EP); also elsewhere on the board
MCN_EN: MCN.3 (!SHDN), U7.18 (GPA3)
MCN_PG: MCN.5 (PWRGD), U7.17 (GPA2)
MCS_EN: MCS.3 (!SHDN), U7.22 (GPA7)
MCS_PG: MCS.5 (PWRGD), U7.21 (GPA6)
MXN_EN: MXN.3 (!SHDN), U7.16 (GPA1)
MXN_PG: MXN.5 (PWRGD), U7.15 (GPA0)
MXS_EN: MXS.3 (!SHDN), U7.1 (GPB1)
MXS_PG: MXS.5 (PWRGD), U7.24 (GPB0)
unnamed: C49.1, L9.1, MXS.8 (VOUT), R41.1
unnamed: MXS.7 (ADJ), R41.2, R42.1
unnamed: C50.1, MXS.6 (CDELAY)
unnamed: R81.1, U14.6 (ASEL)
unnamed: R83.1, U15.6 (ASEL)
unnamed: C52.1, L10.1, MCS.8 (VOUT), R39.1
unnamed: MCS.7 (ADJ), R39.2, R40.1
unnamed: C53.1, MCS.6 (CDELAY)
unnamed: R82.1, U22.6 (ASEL)
unnamed: C55.1, L11.1, R37.1, VIO.8 (VOUT)
unnamed: R37.2, R38.1, VIO.7 (ADJ)
unnamed: C56.1, VIO.6 (CDELAY)
unnamed: C58.1, L12.1, MCN.8 (VOUT), R35.1
unnamed: MCN.7 (ADJ), R35.2, R36.1
unnamed: C59.1, MCN.6 (CDELAY)
unnamed: C61.1, L13.1, MXN.8 (VOUT), R33.1
unnamed: MXN.7 (ADJ), R33.2, R34.1
unnamed: C62.1, MXN.6 (CDELAY)
unnamed: R90.2, R91.1, U7.11 (ADDR)
PCIE_N_V: R68.2, U14.4 (SENSE2-); also elsewhere on the board
PCIE_N_V': L13.2, R68.1, U14.3 (SENSE2+)
PCIE_S_V: R72.2, U15.4 (SENSE2-); also elsewhere on the board
PCIE_S_V': L9.2, R72.1, U15.3 (SENSE2+)
PMOD_SCL: U7.9 (SCL), U14.9 (SMCLK), U15.9 (SMCLK), U22.9 (SMCLK); also elsewhere on the board
PMOD_SDA: U7.10 (SDA), U14.8 (SMDATA), U15.8 (SMDATA), U22.8 (SMDATA); also elsewhere on the board
VCC: R90.1, U7.8 (VDD), U7.12 (!RESET), U14.10 (VDD), U15.10 (VDD), U22.10 (VDD); also elsewhere on the board
VCCIO: L11.2; also elsewhere on the board
VIO_EN: U7.20 (GPA5), VIO.3 (!SHDN)
VIO_PG: U7.19 (GPA4), VIO.5 (PWRGD)
ZED_5V: R69.1, U22.1 (SENSE1+); also elsewhere on the board
ZED_5V': R69.2, U22.2 (SENSE1-); also elsewhere on the board

Notes on the sheet:
AXIOM Beta Test
Copyright (C) 2015 H.Poetzl Licensed under CERN OHL v.1.2
Power, Control and Sensing
[ID=0x20]
[0x29]
[0x28]
[0x2A]

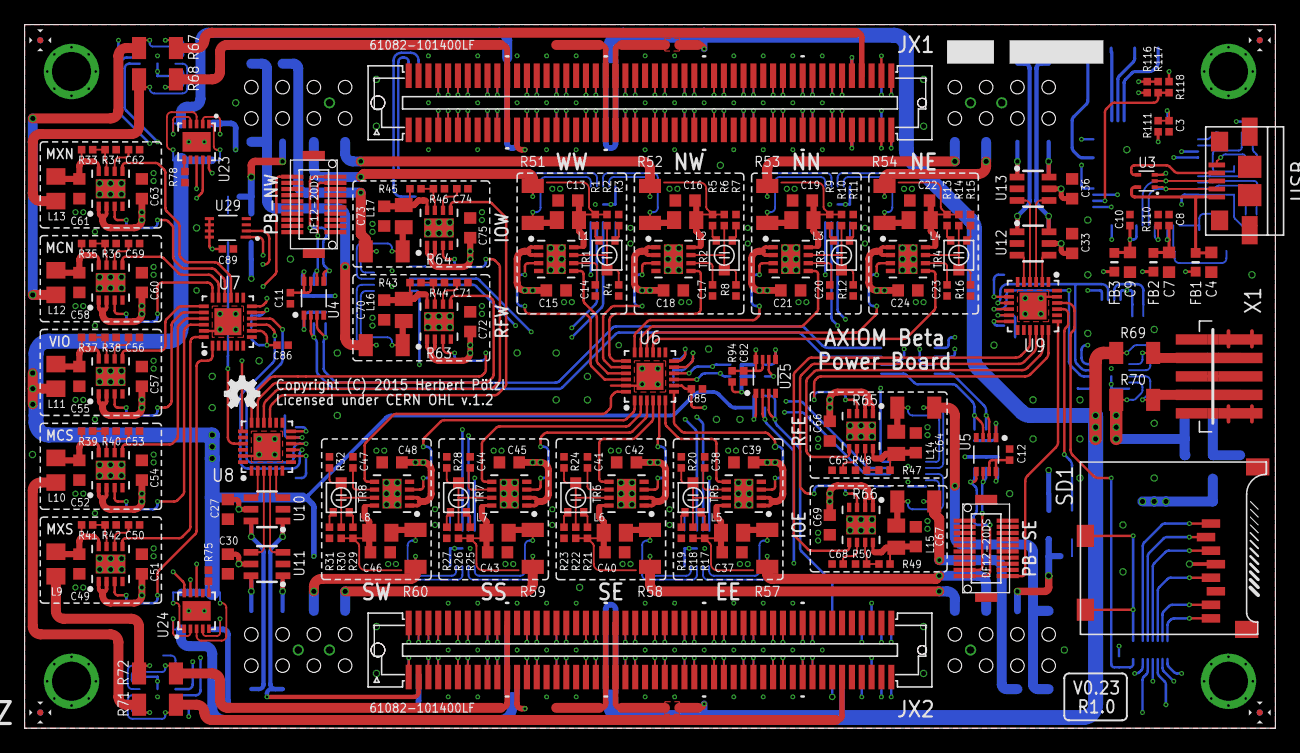
[picture p13: board axiom_beta_power_board_v0.23.brd from above]

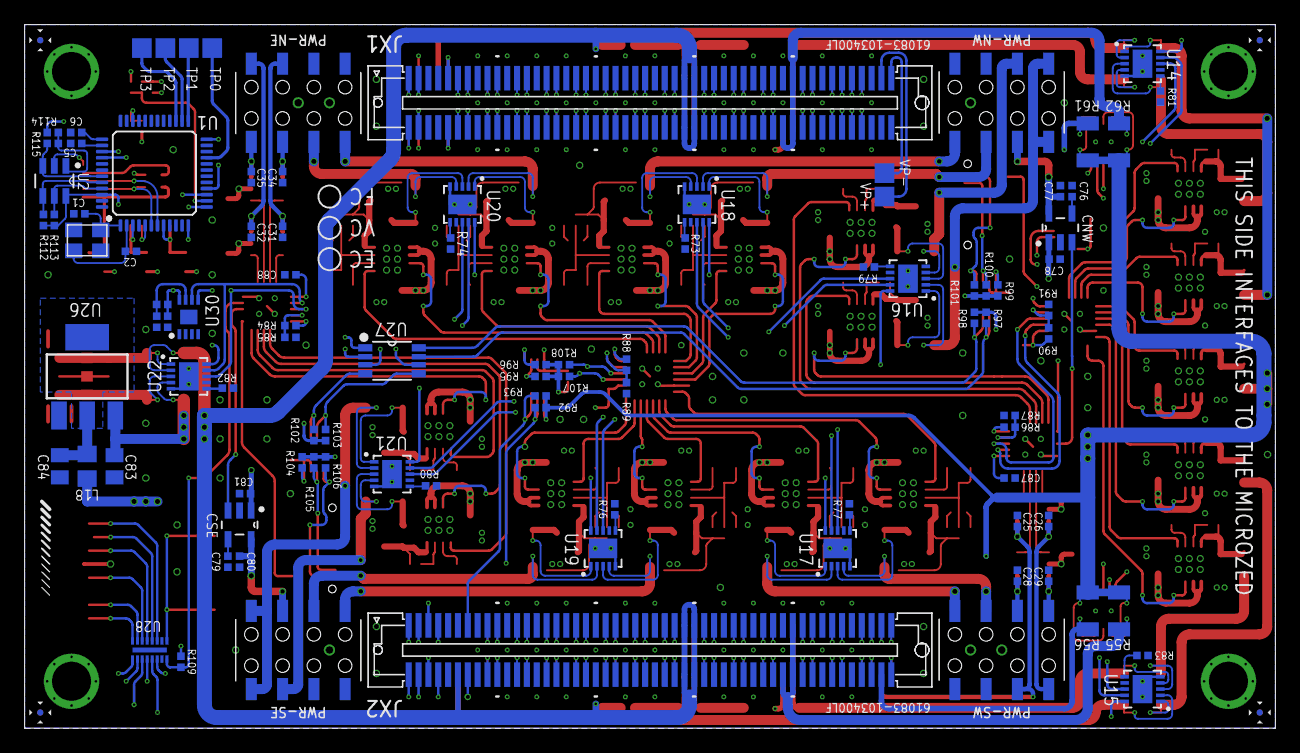
[picture p14: board axiom_beta_power_board_v0.23.brd from below]

Board: 4 copper layers, 101.6 x 57.1 mm, 307 parts (97 on the bottom side), 365 nets.

Other parts of the board:
LOGO1: OSHW_LOGO_FILLX0100-NT; OSHW_FILLX100_NOTEXT
