apertus-open-source-cinema/pcbs/boards/axiom_beta_main_board_v0.31_test.brd

## EAGLE design boards/axiom_beta_main_board_v0.31_test.brd (2021-12-13, an earlier design)

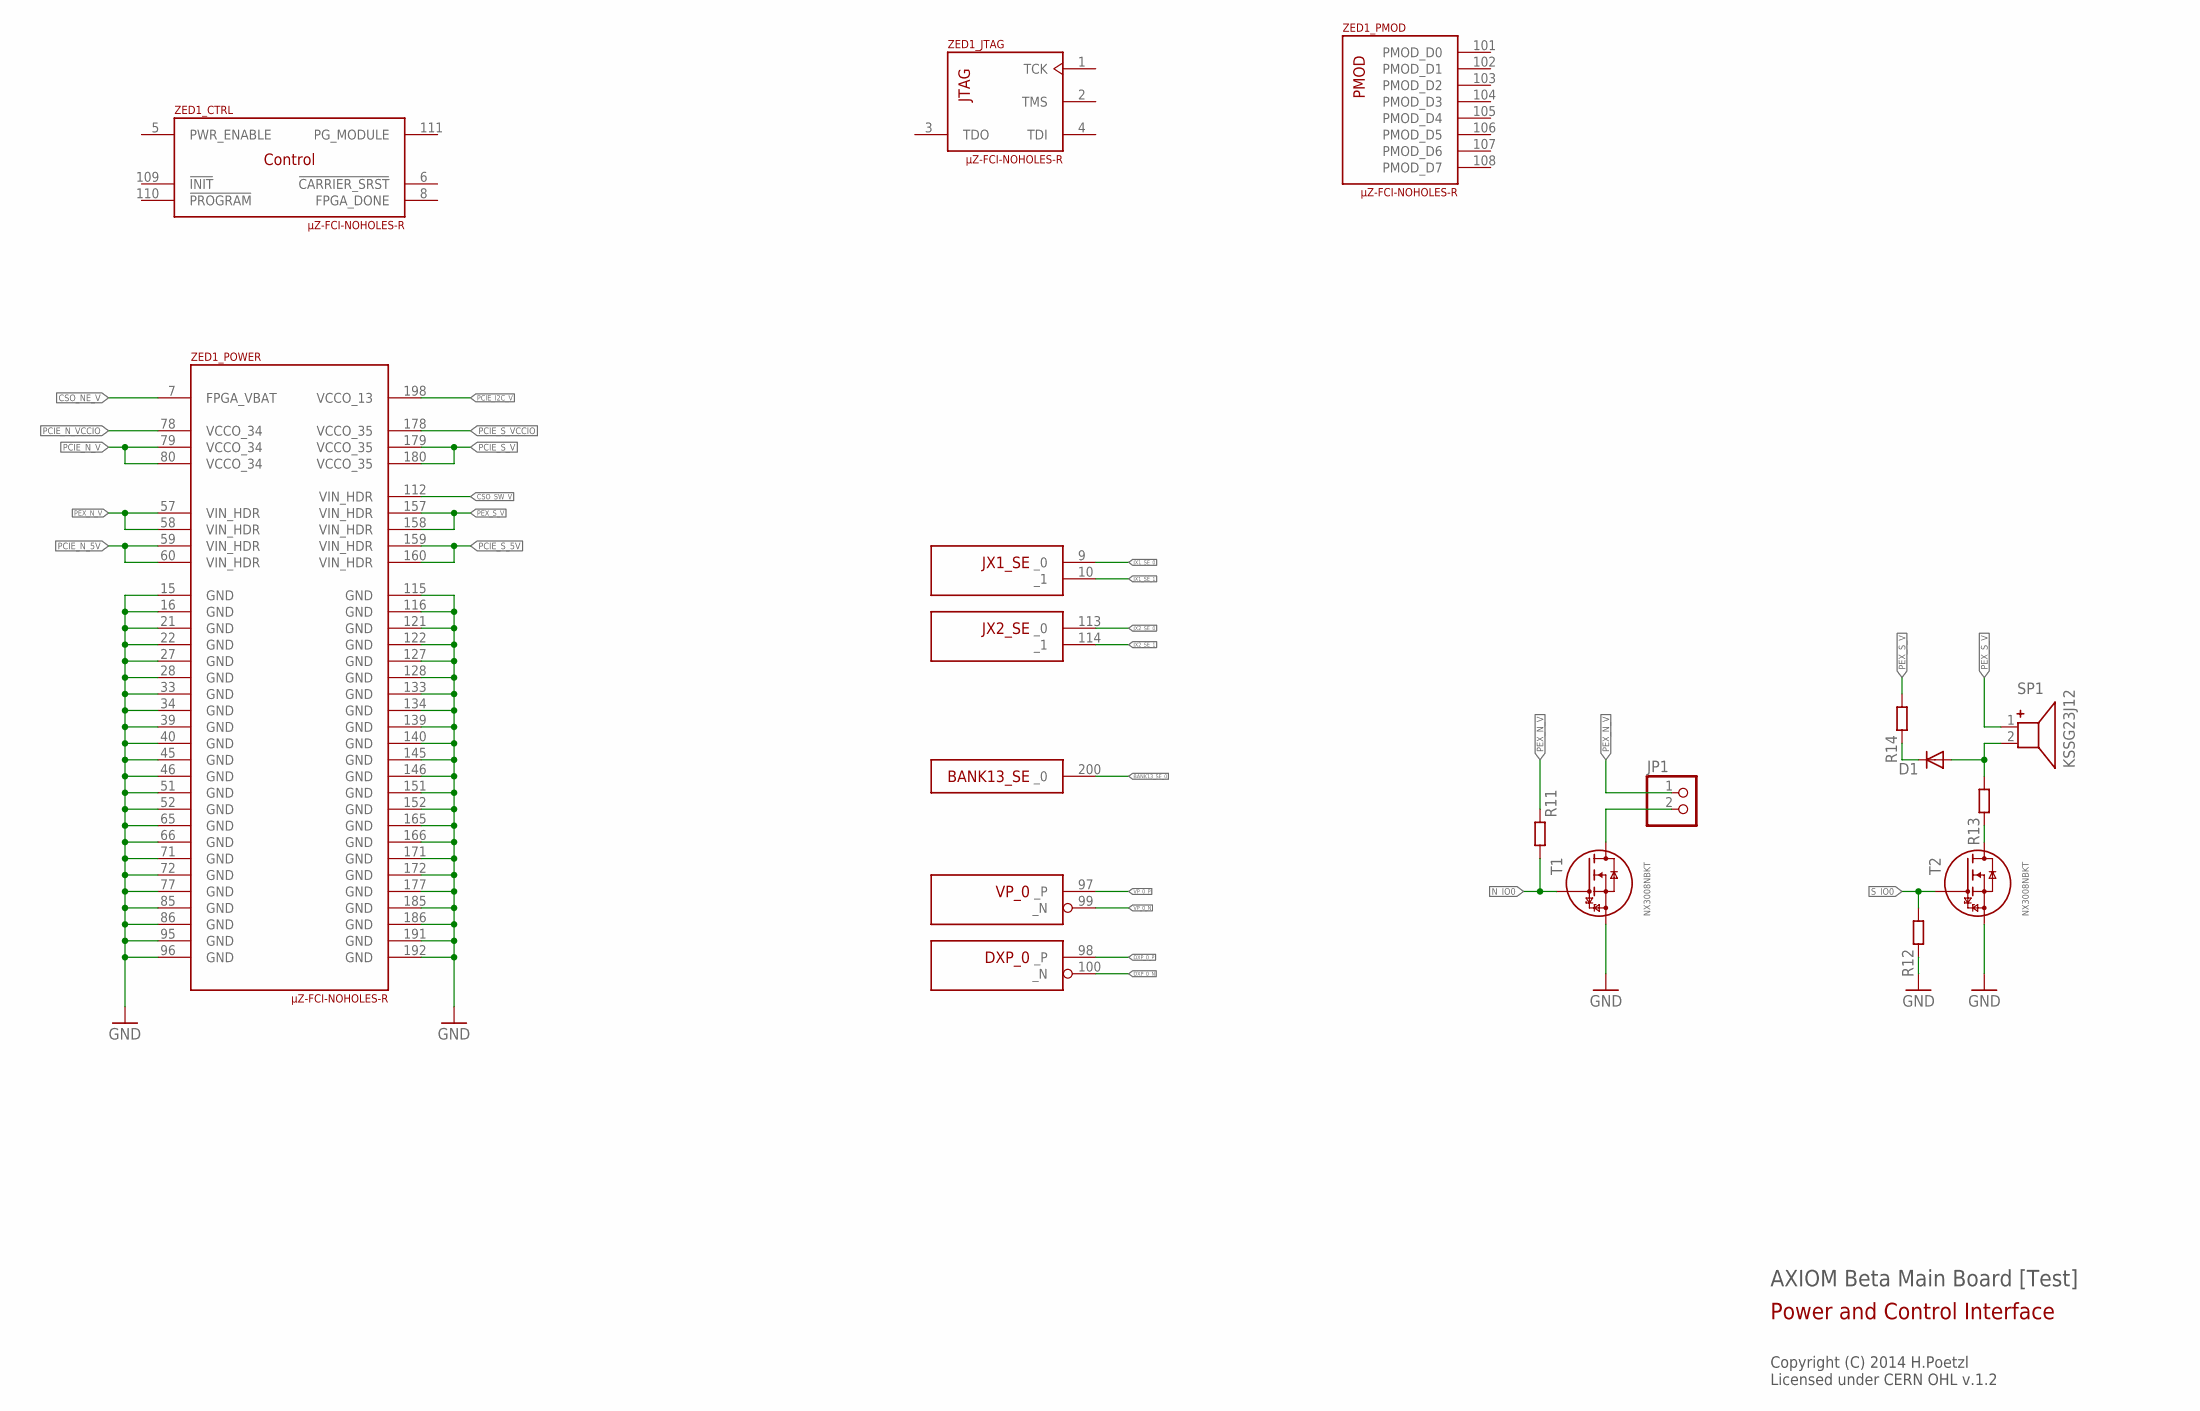
[picture p15: schematic axiom_beta_main_board_v0.31_test.sch, sheet 1]

Parts:
D1: DIODE-MICROMELF-R; MICROMELF-R
JP1: PINHD-1X02_2.00; 1X02M
R11, R12, R13, R14: R0402-B; 0402-B
SP1: KSSG23J12
T1, T2: NX3008NBKT; SOT416
ZED1: µZ-FCI-NOHOLES-R; µZ-NOHOLES-R

Connections:
BANK13_SE_0: ZED1.200 (_0)
CSO_NE_V: ZED1.7 (FPGA_VBAT); also elsewhere on the board
CSO_SW_V: ZED1.112 (VIN_HDR); also elsewhere on the board
DXP_0_N: ZED1.100 (_N)
DXP_0_P: ZED1.98 (_P)
GND: R12.1, T1.2 (S), ZED1.15 (GND), ZED1.16 (GND), ZED1.21 (GND), ZED1.22 (GND), ZED1.27 (GND), ZED1.28 (GND), ZED1.33 (GND), ZED1.34 (GND), ZED1.39 (GND), ZED1.40 (GND), ZED1.45 (GND), ZED1.46 (GND), ZED1.51 (GND), ZED1.52 (GND), ZED1.65 (GND), ZED1.66 (GND), ZED1.71 (GND), ZED1.72 (GND), ZED1.77 (GND), ZED1.85 (GND), ZED1.86 (GND), ZED1.95 (GND), ZED1.96 (GND), ZED1.115 (GND), ZED1.116 (GND), ZED1.121 (GND), ZED1.122 (GND), ZED1.127 (GND), ZED1.128 (GND), ZED1.133 (GND), ZED1.134 (GND), ZED1.139 (GND), ZED1.140 (GND), ZED1.145 (GND), ZED1.146 (GND), ZED1.151 (GND), ZED1.152 (GND), ZED1.165 (GND), ZED1.166 (GND), ZED1.171 (GND), ZED1.172 (GND), ZED1.177 (GND), ZED1.185 (GND), ZED1.186 (GND), ZED1.191 (GND), ZED1.192 (GND); also elsewhere on the board
JX1_SE_0: ZED1.9 (_0)
JX1_SE_1: ZED1.10 (_1)
JX2_SE_0: ZED1.113 (_0)
JX2_SE_1: ZED1.114 (_1)
unnamed: JP1.2, T1.3 (D)
unnamed: R13.1, T2.3 (D)
unnamed: D1.C, R14.1
unnamed: D1.A, R13.2, SP1.2
N_IO0: R11.2, T1.1 (G); also elsewhere on the board
PCIE_I2C_V: ZED1.198 (VCCO_13); also elsewhere on the board
PCIE_N_5V: ZED1.59 (VIN_HDR), ZED1.60 (VIN_HDR); also elsewhere on the board
PCIE_N_V: ZED1.79 (VCCO_34), ZED1.80 (VCCO_34); also elsewhere on the board
PCIE_N_VCCIO: ZED1.78 (VCCO_34); also elsewhere on the board
PCIE_S_5V: ZED1.159 (VIN_HDR), ZED1.160 (VIN_HDR); also elsewhere on the board
PCIE_S_V: ZED1.179 (VCCO_35), ZED1.180 (VCCO_35); also elsewhere on the board
PCIE_S_VCCIO: ZED1.178 (VCCO_35); also elsewhere on the board
PEX_N_V: JP1.1, R11.1, ZED1.57 (VIN_HDR), ZED1.58 (VIN_HDR)
PEX_S_V: R14.2, SP1.1, ZED1.157 (VIN_HDR), ZED1.158 (VIN_HDR)
S_IO0: R12.2, T2.1 (G); also elsewhere on the board
VP_0_N: ZED1.99 (_N)
VP_0_P: ZED1.97 (_P)

Notes on the sheet:
AXIOM Beta Main Board [Test]
Copyright (C) 2014 H.Poetzl Licensed under CERN OHL v.1.2
Power and Control Interface
