apertus-open-source-cinema/pcbs/boards/axiom_beta_main_board_v0.31_test.brd

## EAGLE design boards/axiom_beta_main_board_v0.31_test.brd (continued)

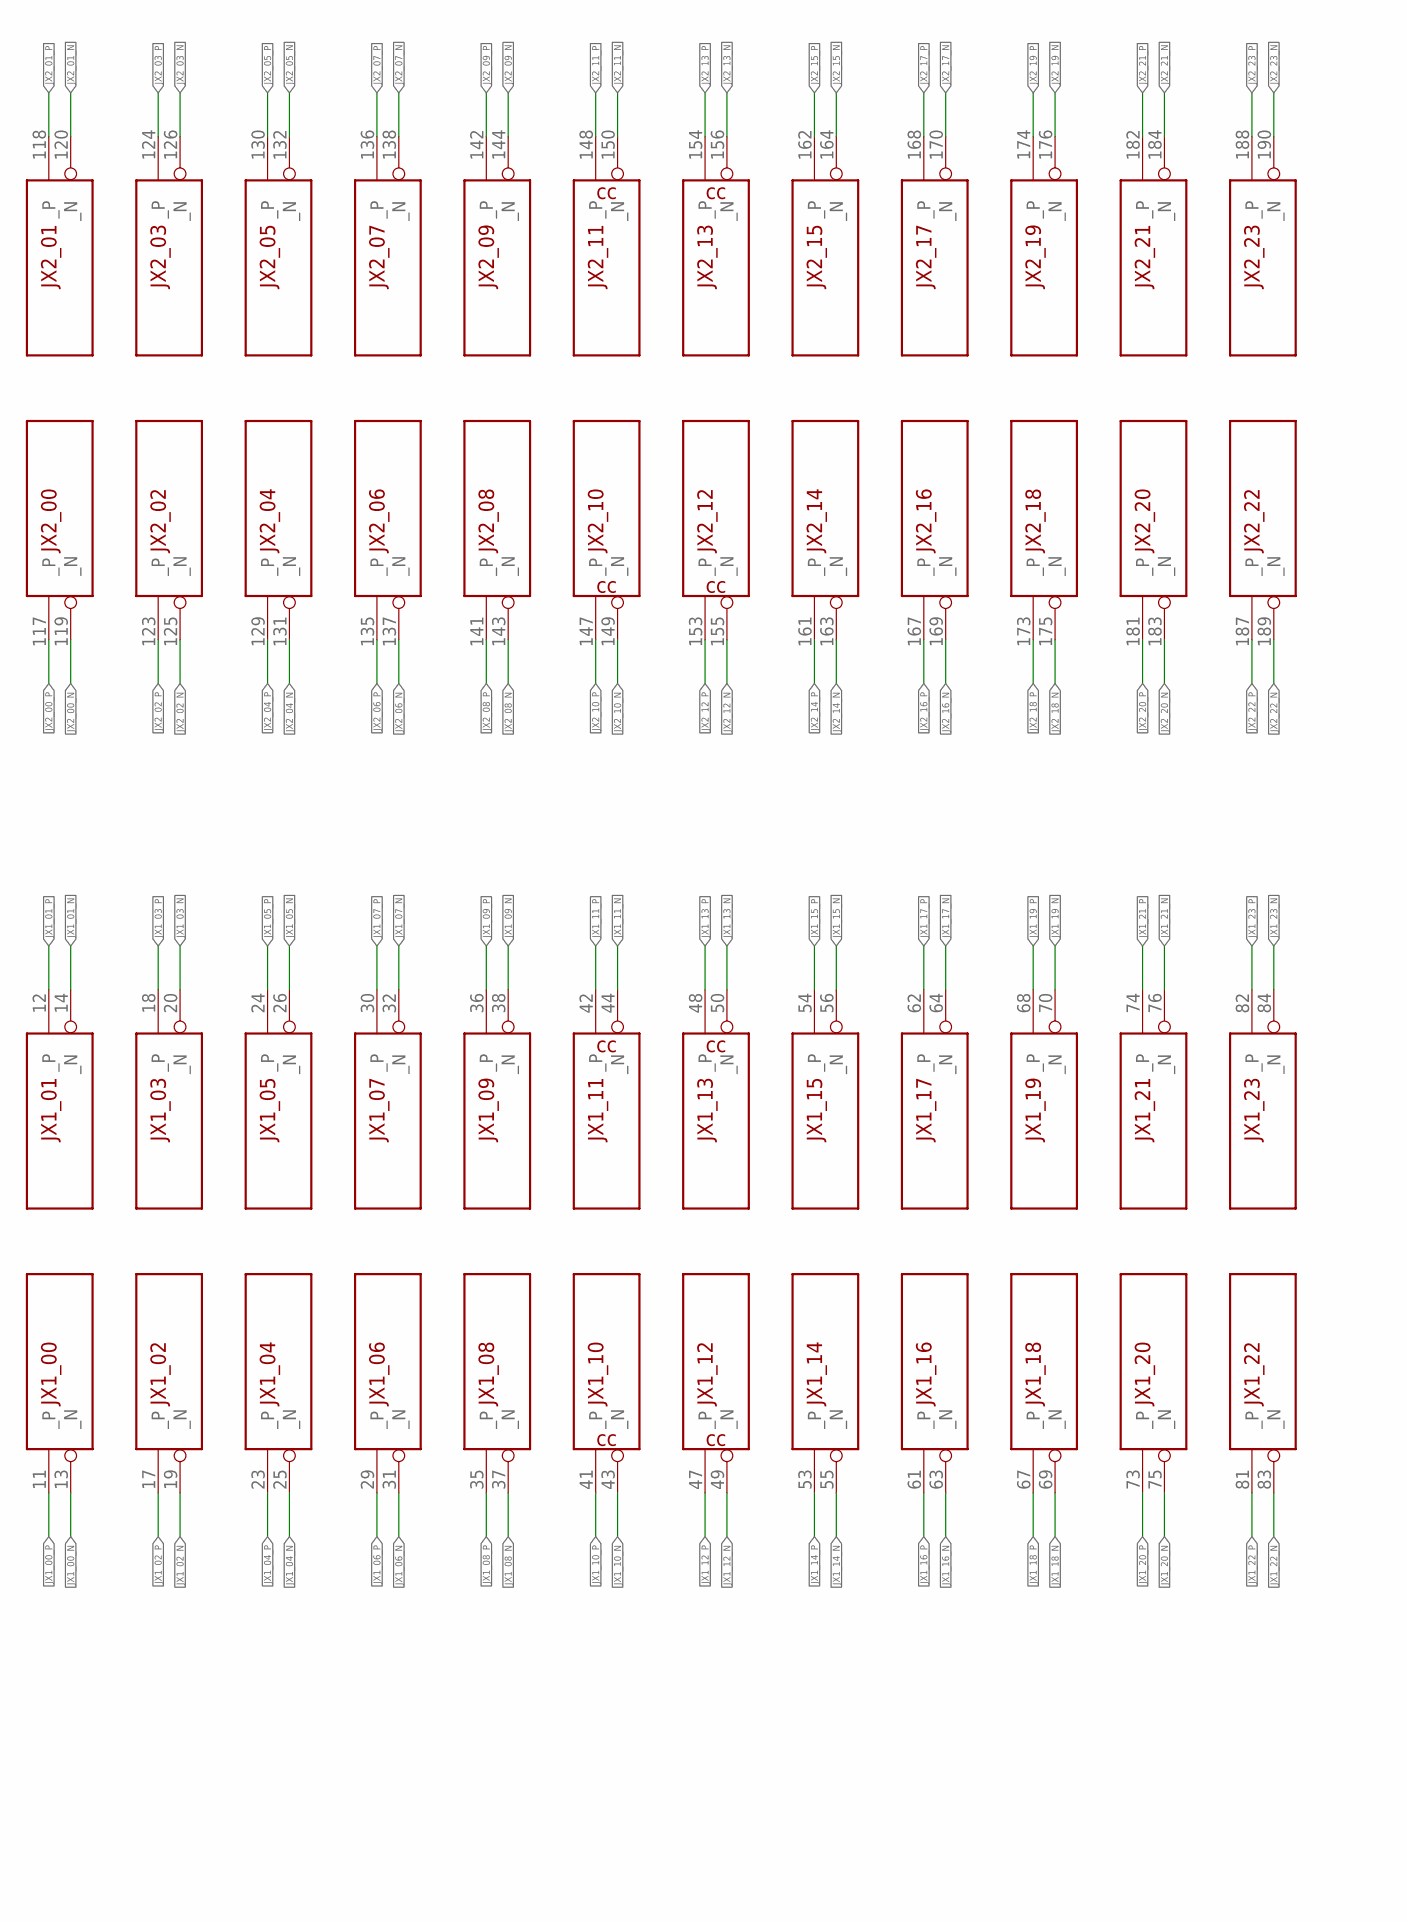
[picture p16: schematic axiom_beta_main_board_v0.31_test.sch, sheet 2, part in row 1, column 1]

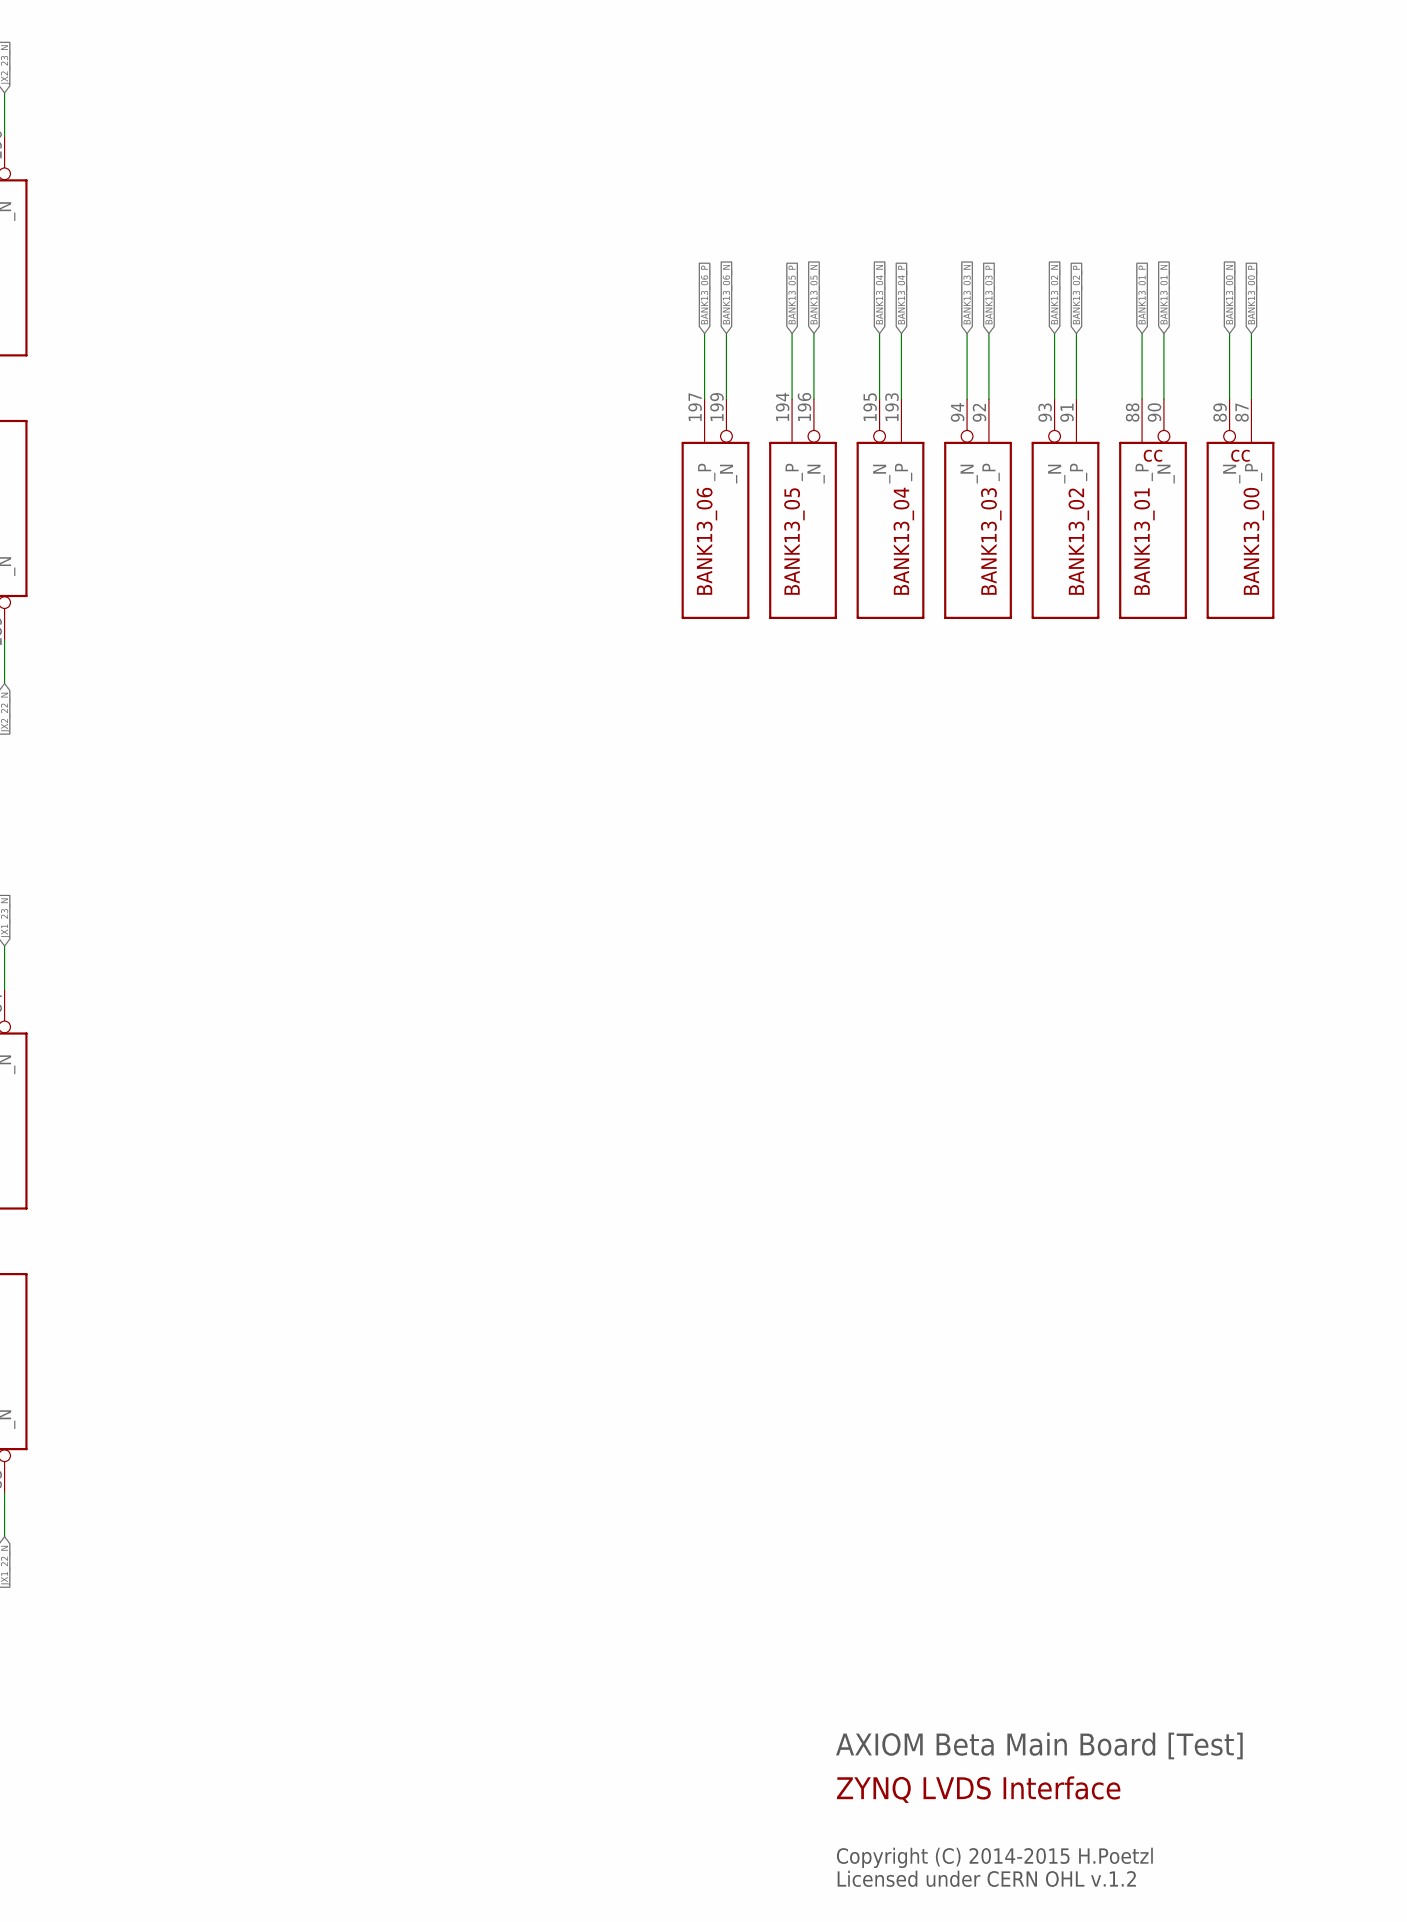
[picture p17: schematic axiom_beta_main_board_v0.31_test.sch, sheet 2, part in row 1, column 2]

Parts:
ZED1: µZ-FCI-NOHOLES-R; µZ-NOHOLES-R

Connections:
BANK13_00_N: ZED1.89 (_N); also elsewhere on the board
BANK13_00_P: ZED1.87 (_P); also elsewhere on the board
BANK13_01_N: ZED1.90 (_N); also elsewhere on the board
BANK13_01_P: ZED1.88 (_P); also elsewhere on the board
BANK13_02_N: ZED1.93 (_N); also elsewhere on the board
BANK13_02_P: ZED1.91 (_P); also elsewhere on the board
BANK13_03_N: ZED1.94 (_N); also elsewhere on the board
BANK13_03_P: ZED1.92 (_P); also elsewhere on the board
BANK13_04_N: ZED1.195 (_N); also elsewhere on the board
BANK13_04_P: ZED1.193 (_P); also elsewhere on the board
BANK13_05_N: ZED1.196 (_N); also elsewhere on the board
BANK13_05_P: ZED1.194 (_P); also elsewhere on the board
BANK13_06_N: ZED1.199 (_N); also elsewhere on the board
BANK13_06_P: ZED1.197 (_P); also elsewhere on the board
JX1_00_N: ZED1.13 (_N); also elsewhere on the board
JX1_00_P: ZED1.11 (_P); also elsewhere on the board
JX1_01_N: ZED1.14 (_N); also elsewhere on the board
JX1_01_P: ZED1.12 (_P); also elsewhere on the board
JX1_02_N: ZED1.19 (_N); also elsewhere on the board
JX1_02_P: ZED1.17 (_P); also elsewhere on the board
JX1_03_N: ZED1.20 (_N); also elsewhere on the board
JX1_03_P: ZED1.18 (_P); also elsewhere on the board
JX1_04_N: ZED1.25 (_N); also elsewhere on the board
JX1_04_P: ZED1.23 (_P); also elsewhere on the board
JX1_05_N: ZED1.26 (_N); also elsewhere on the board
JX1_05_P: ZED1.24 (_P); also elsewhere on the board
JX1_06_N: ZED1.31 (_N); also elsewhere on the board
JX1_06_P: ZED1.29 (_P); also elsewhere on the board
JX1_07_N: ZED1.32 (_N); also elsewhere on the board
JX1_07_P: ZED1.30 (_P); also elsewhere on the board
JX1_08_N: ZED1.37 (_N); also elsewhere on the board
JX1_08_P: ZED1.35 (_P); also elsewhere on the board
JX1_09_N: ZED1.38 (_N); also elsewhere on the board
JX1_09_P: ZED1.36 (_P); also elsewhere on the board
JX1_10_N: ZED1.43 (_N); also elsewhere on the board
JX1_10_P: ZED1.41 (_P); also elsewhere on the board
JX1_11_N: ZED1.44 (_N); also elsewhere on the board
JX1_11_P: ZED1.42 (_P); also elsewhere on the board
JX1_12_N: ZED1.49 (_N); also elsewhere on the board
JX1_12_P: ZED1.47 (_P); also elsewhere on the board
JX1_13_N: ZED1.50 (_N); also elsewhere on the board
JX1_13_P: ZED1.48 (_P); also elsewhere on the board
JX1_14_N: ZED1.55 (_N); also elsewhere on the board
JX1_14_P: ZED1.53 (_P); also elsewhere on the board
JX1_15_N: ZED1.56 (_N); also elsewhere on the board
JX1_15_P: ZED1.54 (_P); also elsewhere on the board
JX1_16_N: ZED1.63 (_N); also elsewhere on the board
JX1_16_P: ZED1.61 (_P); also elsewhere on the board
JX1_17_N: ZED1.64 (_N); also elsewhere on the board
JX1_17_P: ZED1.62 (_P); also elsewhere on the board
JX1_18_N: ZED1.69 (_N); also elsewhere on the board
JX1_18_P: ZED1.67 (_P); also elsewhere on the board
JX1_19_N: ZED1.70 (_N); also elsewhere on the board
JX1_19_P: ZED1.68 (_P); also elsewhere on the board
JX1_20_N: ZED1.75 (_N); also elsewhere on the board
JX1_20_P: ZED1.73 (_P); also elsewhere on the board
JX1_21_N: ZED1.76 (_N); also elsewhere on the board
JX1_21_P: ZED1.74 (_P); also elsewhere on the board
JX1_22_N: ZED1.83 (_N); also elsewhere on the board
JX1_22_P: ZED1.81 (_P); also elsewhere on the board
JX1_23_N: ZED1.84 (_N); also elsewhere on the board
JX1_23_P: ZED1.82 (_P); also elsewhere on the board
JX2_00_N: ZED1.119 (_N); also elsewhere on the board
JX2_00_P: ZED1.117 (_P); also elsewhere on the board
JX2_01_N: ZED1.120 (_N); also elsewhere on the board
JX2_01_P: ZED1.118 (_P); also elsewhere on the board
JX2_02_N: ZED1.125 (_N); also elsewhere on the board
JX2_02_P: ZED1.123 (_P); also elsewhere on the board
JX2_03_N: ZED1.126 (_N); also elsewhere on the board
JX2_03_P: ZED1.124 (_P); also elsewhere on the board
JX2_04_N: ZED1.131 (_N); also elsewhere on the board
JX2_04_P: ZED1.129 (_P); also elsewhere on the board
JX2_05_N: ZED1.132 (_N); also elsewhere on the board
JX2_05_P: ZED1.130 (_P); also elsewhere on the board
JX2_06_N: ZED1.137 (_N); also elsewhere on the board
JX2_06_P: ZED1.135 (_P); also elsewhere on the board
JX2_07_N: ZED1.138 (_N); also elsewhere on the board
JX2_07_P: ZED1.136 (_P); also elsewhere on the board
JX2_08_N: ZED1.143 (_N); also elsewhere on the board
JX2_08_P: ZED1.141 (_P); also elsewhere on the board
JX2_09_N: ZED1.144 (_N); also elsewhere on the board
JX2_09_P: ZED1.142 (_P); also elsewhere on the board
JX2_10_N: ZED1.149 (_N); also elsewhere on the board
JX2_10_P: ZED1.147 (_P); also elsewhere on the board
JX2_11_N: ZED1.150 (_N); also elsewhere on the board
JX2_11_P: ZED1.148 (_P); also elsewhere on the board
JX2_12_N: ZED1.155 (_N); also elsewhere on the board
JX2_12_P: ZED1.153 (_P); also elsewhere on the board
JX2_13_N: ZED1.156 (_N); also elsewhere on the board
JX2_13_P: ZED1.154 (_P); also elsewhere on the board
JX2_14_N: ZED1.163 (_N); also elsewhere on the board
JX2_14_P: ZED1.161 (_P); also elsewhere on the board
JX2_15_N: ZED1.164 (_N); also elsewhere on the board
JX2_15_P: ZED1.162 (_P); also elsewhere on the board
JX2_16_N: ZED1.169 (_N); also elsewhere on the board
JX2_16_P: ZED1.167 (_P); also elsewhere on the board
JX2_17_N: ZED1.170 (_N); also elsewhere on the board
JX2_17_P: ZED1.168 (_P); also elsewhere on the board
JX2_18_N: ZED1.175 (_N); also elsewhere on the board
JX2_18_P: ZED1.173 (_P); also elsewhere on the board
JX2_19_N: ZED1.176 (_N); also elsewhere on the board
JX2_19_P: ZED1.174 (_P); also elsewhere on the board
JX2_20_N: ZED1.183 (_N); also elsewhere on the board
JX2_20_P: ZED1.181 (_P); also elsewhere on the board
JX2_21_N: ZED1.184 (_N); also elsewhere on the board
JX2_21_P: ZED1.182 (_P); also elsewhere on the board
JX2_22_N: ZED1.189 (_N); also elsewhere on the board
JX2_22_P: ZED1.187 (_P); also elsewhere on the board
JX2_23_N: ZED1.190 (_N); also elsewhere on the board
JX2_23_P: ZED1.188 (_P); also elsewhere on the board

Notes on the sheet:
AXIOM Beta Main Board [Test]
Copyright (C) 2014-2015 H.Poetzl Licensed under CERN OHL v.1.2
ZYNQ LVDS Interface
