apertus-open-source-cinema/pcbs/boards/axiom_beta_main_board_v0.31_test.brd

## EAGLE design boards/axiom_beta_main_board_v0.31_test.brd (continued)

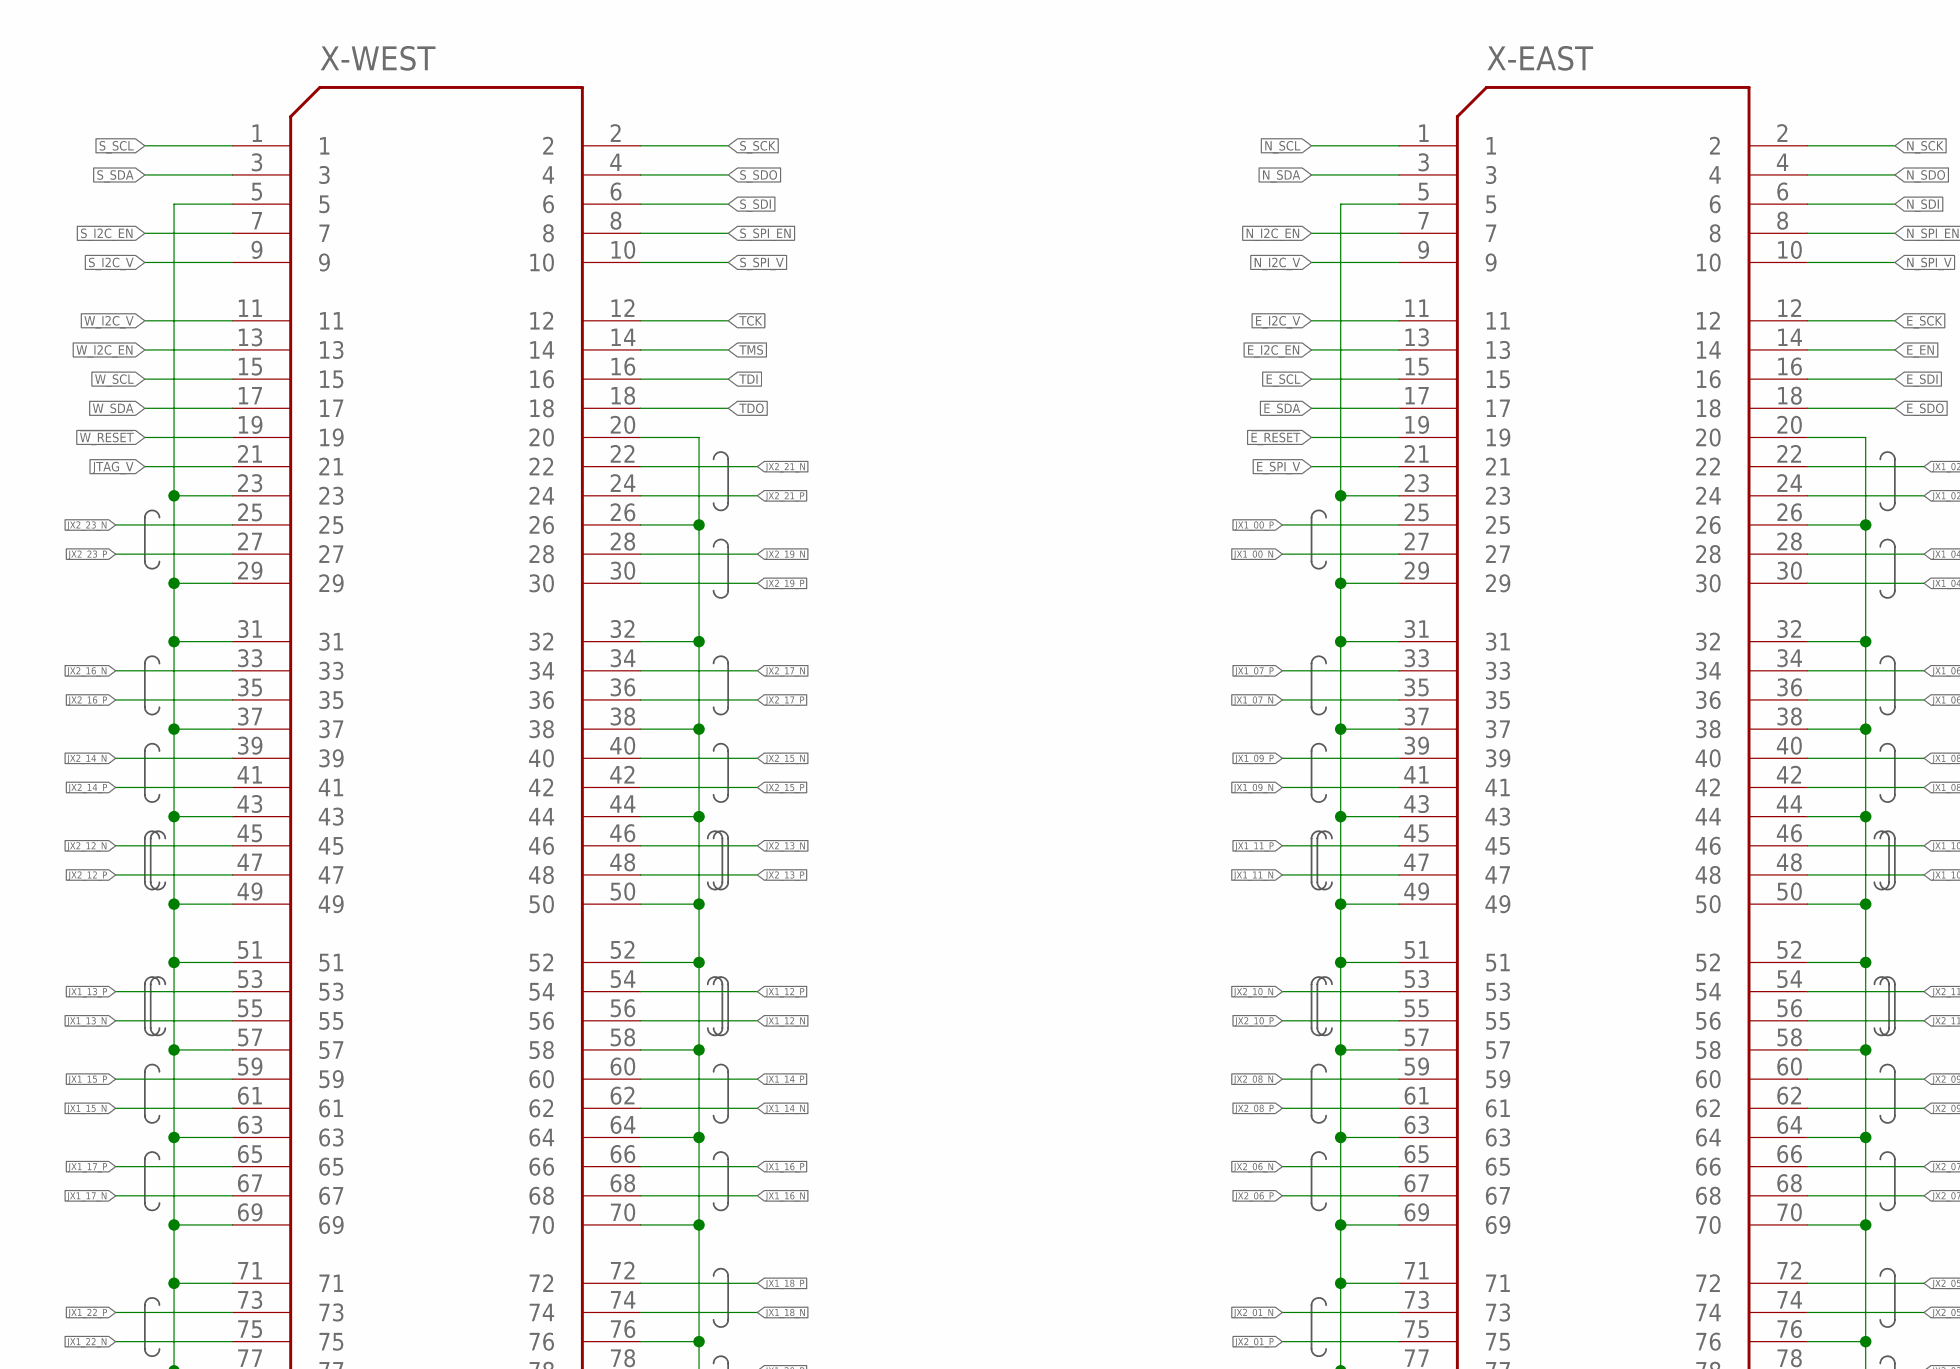
[picture p18: schematic axiom_beta_main_board_v0.31_test.sch, sheet 3, part in row 1, column 1]

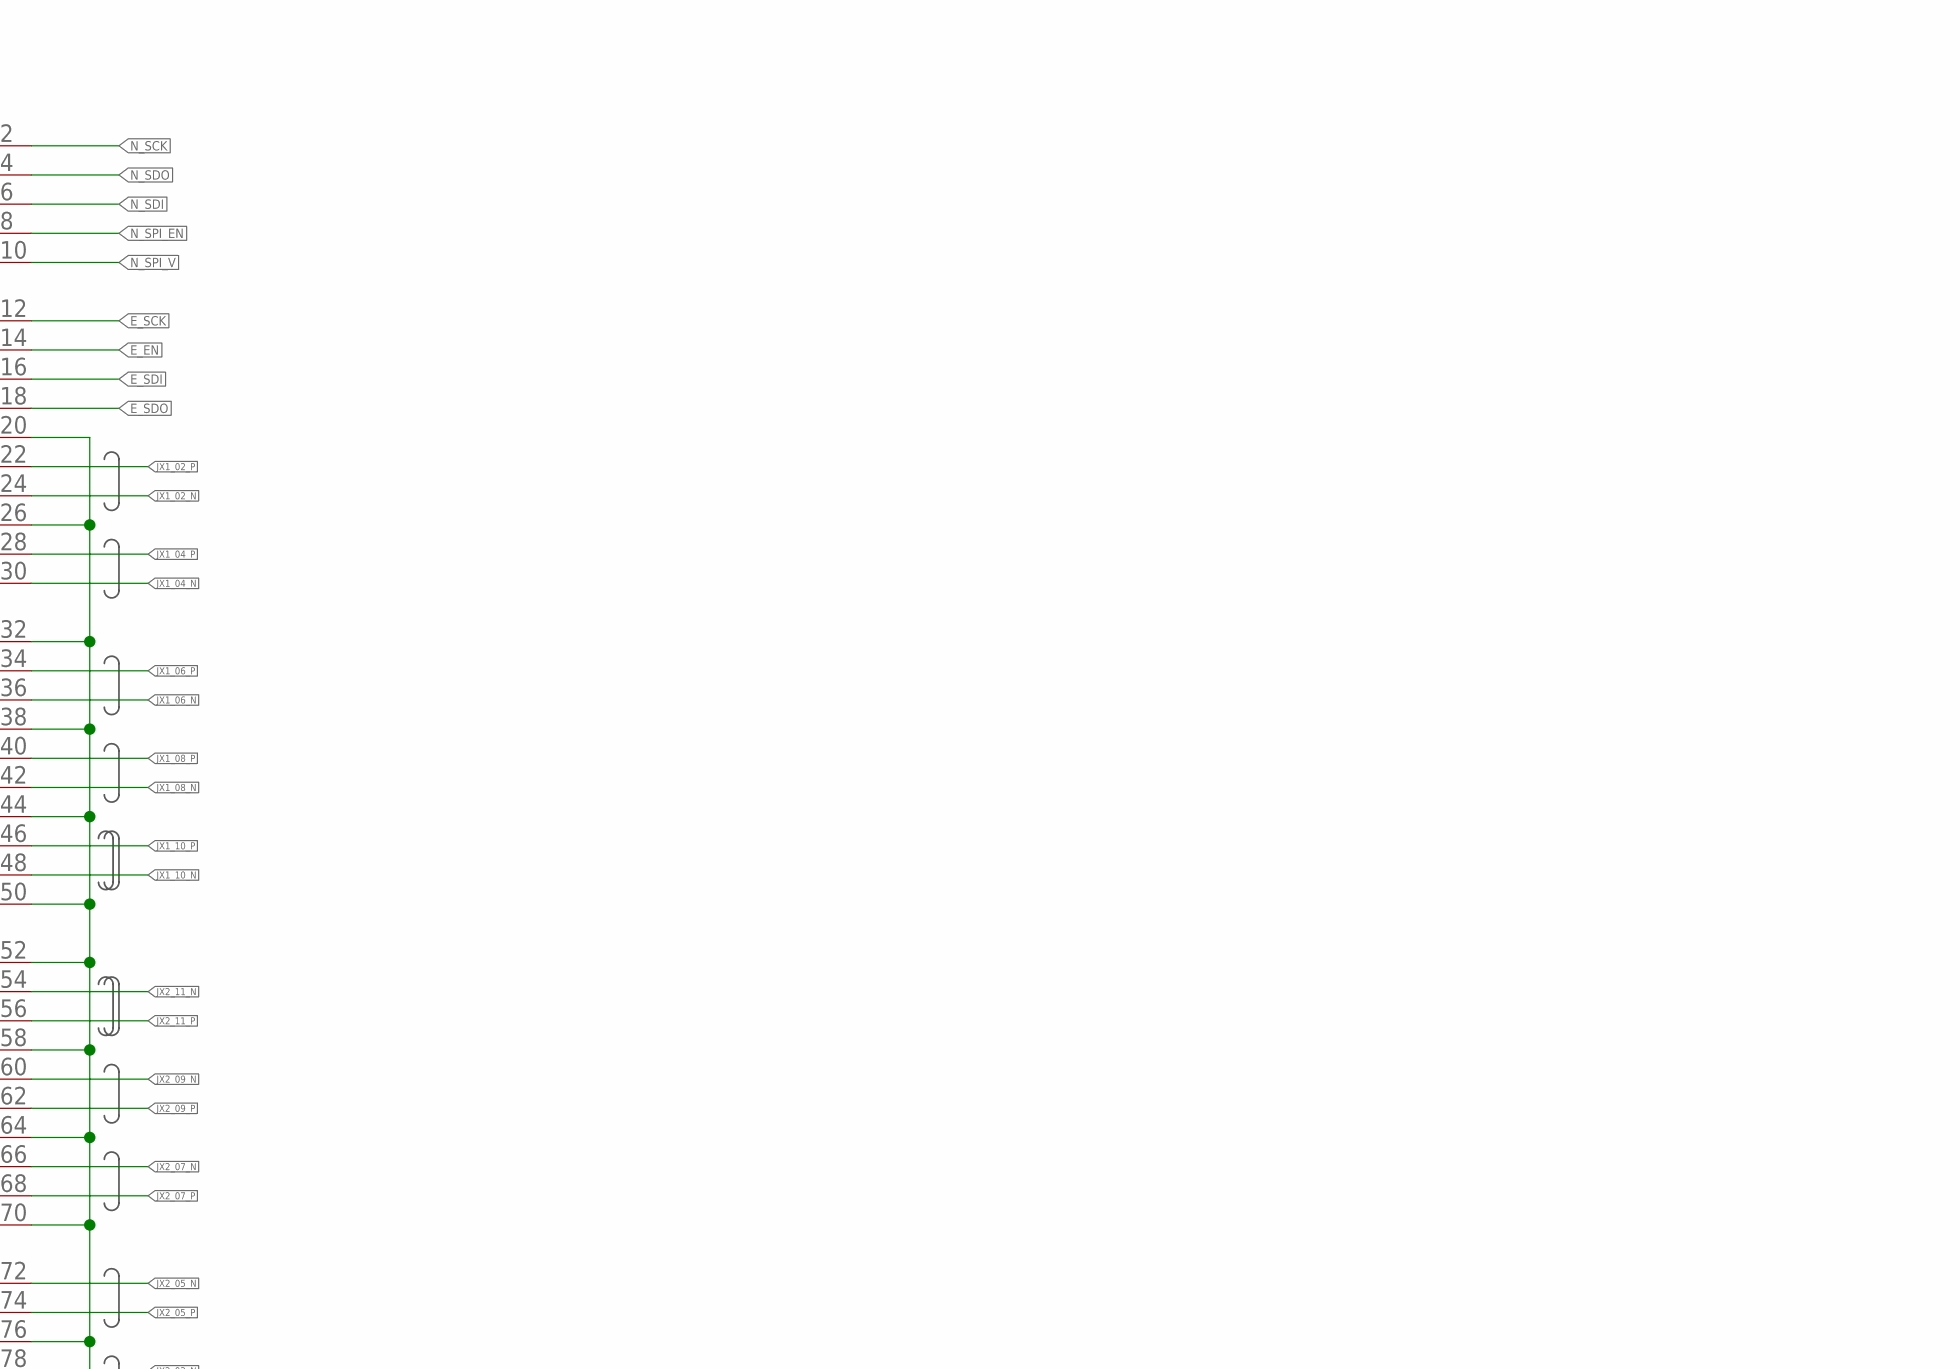
[picture p19: schematic axiom_beta_main_board_v0.31_test.sch, sheet 3, part in row 1, column 2]

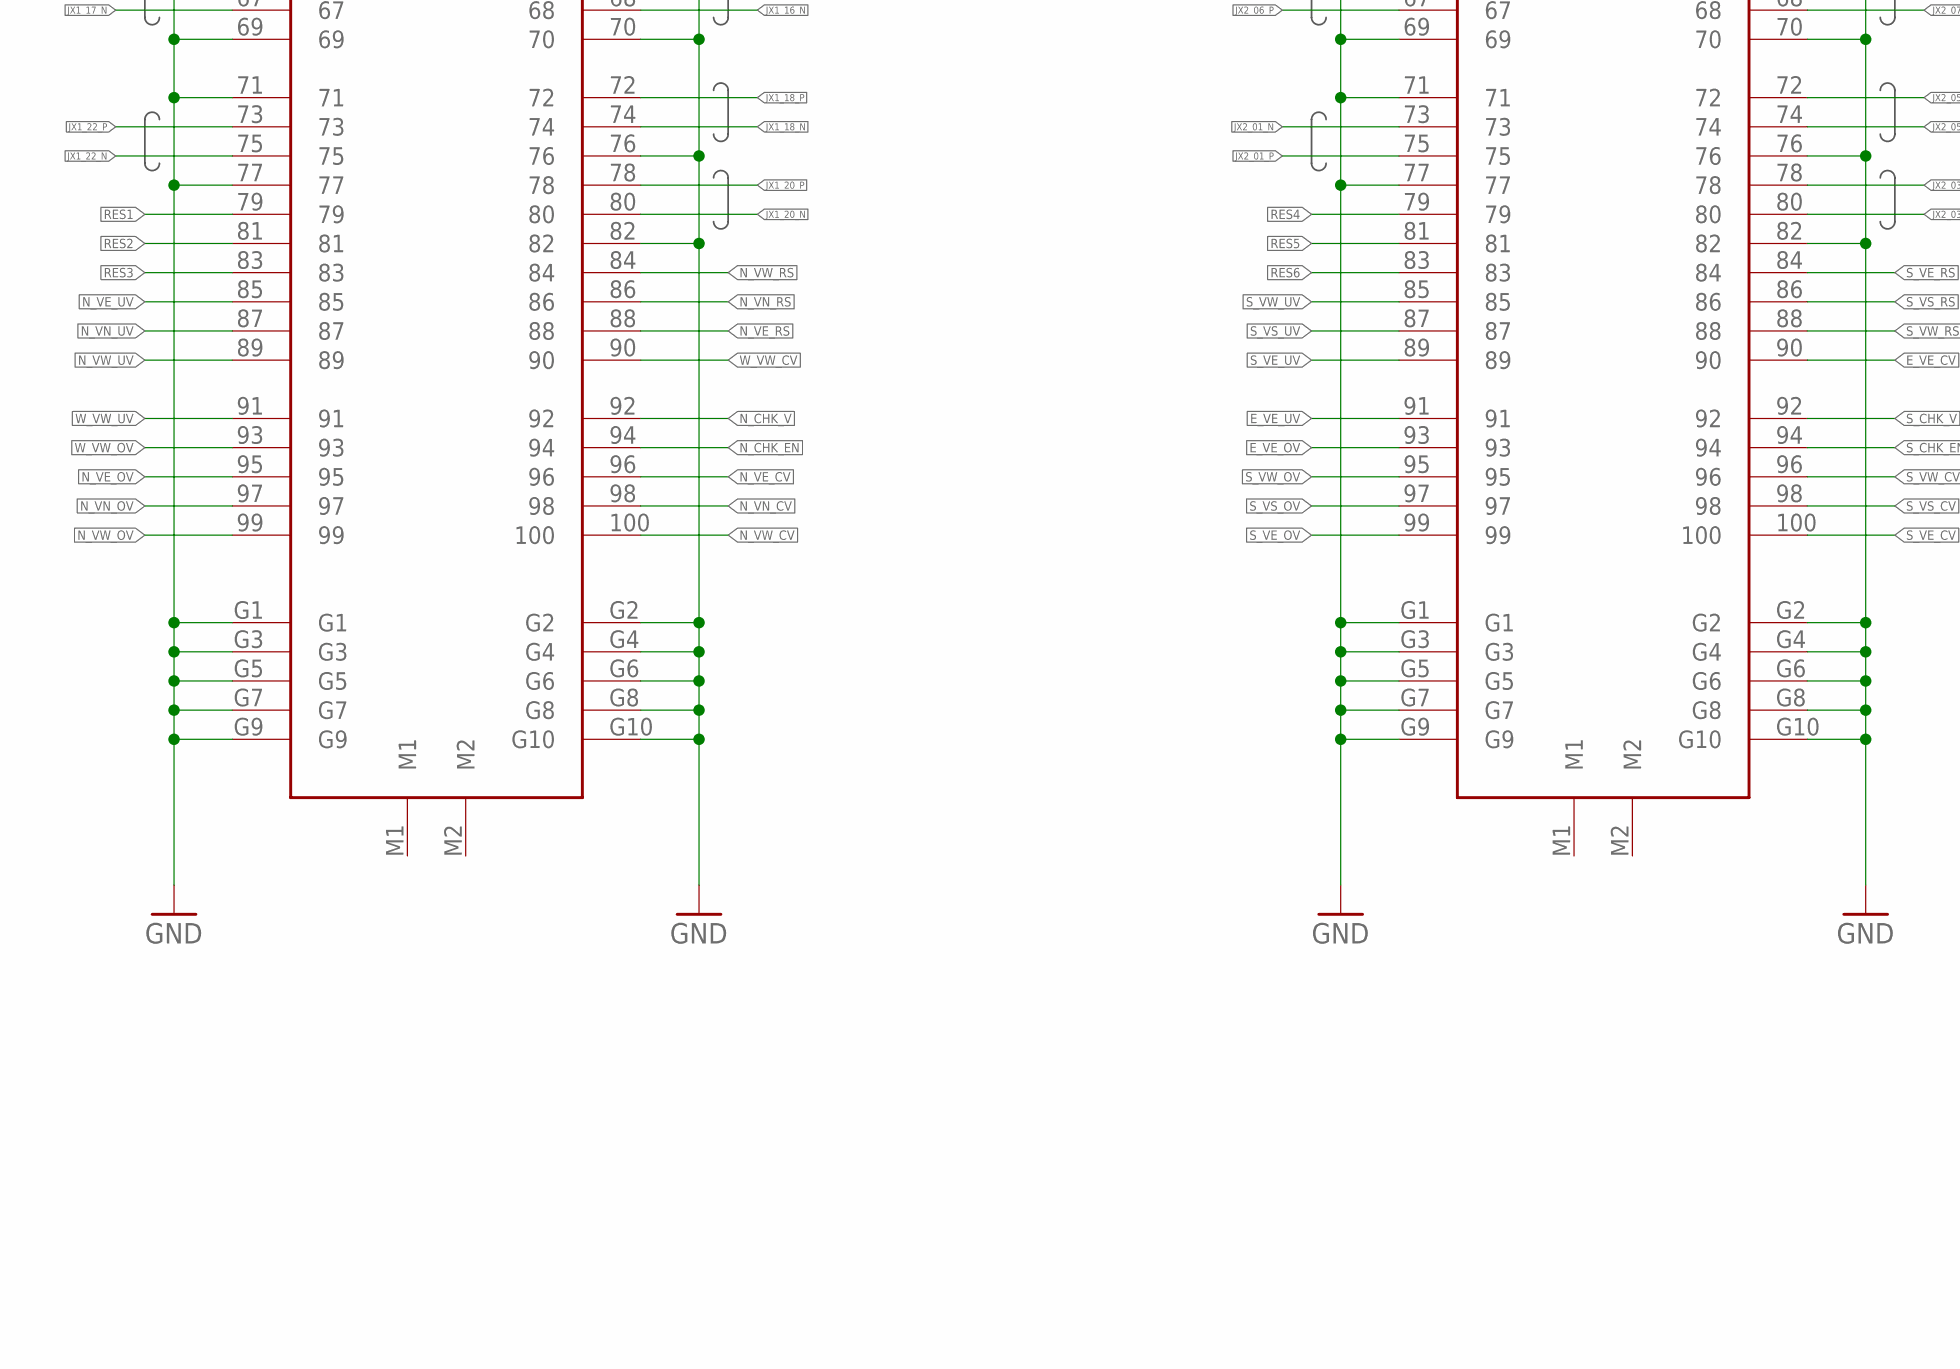
[picture p20: schematic axiom_beta_main_board_v0.31_test.sch, sheet 3, part in row 2, column 1]

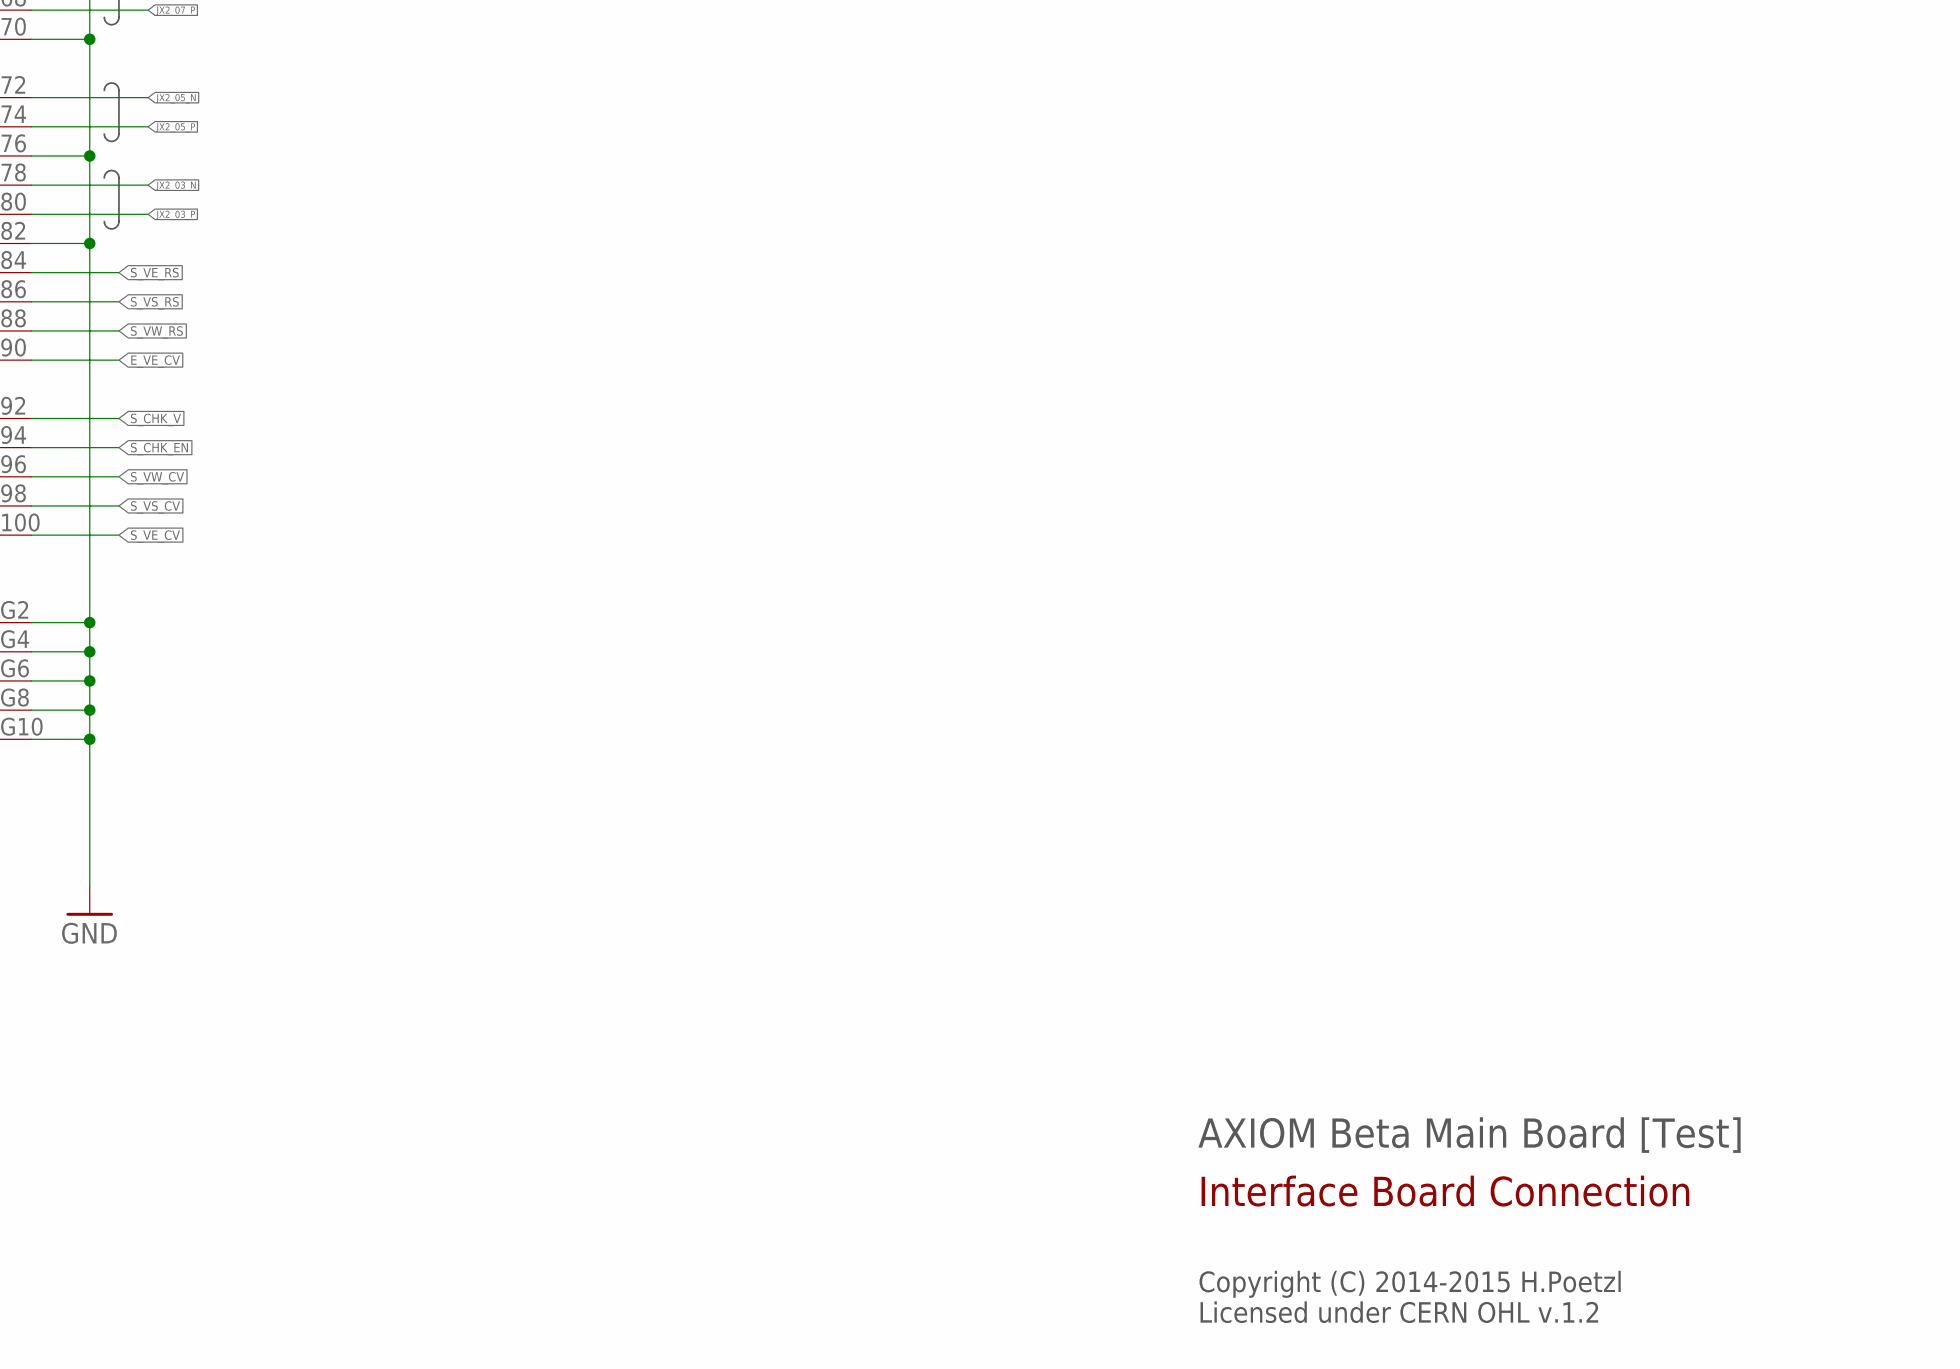
[picture p21: schematic axiom_beta_main_board_v0.31_test.sch, sheet 3, part in row 2, column 2]

Parts:
X-EAST: FX10-100/10S; FX10A-100S/10
X-WEST: FX10-100/10S; FX10A-100S/10

Connections:
!E_RESET!: X-EAST.19
!W_RESET!: X-WEST.19
E_EN: X-EAST.14; also elsewhere on the board
E_I2C_EN: X-EAST.13
E_I2C_V: X-EAST.11; also elsewhere on the board
E_SCK: X-EAST.12; also elsewhere on the board
E_SCL: X-EAST.15; also elsewhere on the board
E_SDA: X-EAST.17; also elsewhere on the board
E_SDI: X-EAST.16; also elsewhere on the board
E_SDO: X-EAST.18; also elsewhere on the board
E_SPI_V: X-EAST.21; also elsewhere on the board
E_VE_CV: X-EAST.90; also elsewhere on the board
E_VE_OV: X-EAST.93; also elsewhere on the board
E_VE_UV: X-EAST.91; also elsewhere on the board
GND: X-EAST.5, X-EAST.20, X-EAST.23, X-EAST.26, X-EAST.29, X-EAST.31, X-EAST.32, X-EAST.37, X-EAST.38, X-EAST.43, X-EAST.44, X-EAST.49, X-EAST.50, X-EAST.51, X-EAST.52, X-EAST.57, X-EAST.58, X-EAST.63, X-EAST.64, X-EAST.69, X-EAST.70, X-EAST.71, X-EAST.76, X-EAST.77, X-EAST.82, X-EAST.G1, X-EAST.G2, X-EAST.G3, X-EAST.G4, X-EAST.G5, X-EAST.G6, X-EAST.G7, X-EAST.G8, X-EAST.G9, X-EAST.G10, X-WEST.5, X-WEST.20, X-WEST.23, X-WEST.26, X-WEST.29, X-WEST.31, X-WEST.32, X-WEST.37, X-WEST.38, X-WEST.43, X-WEST.44, X-WEST.49, X-WEST.50, X-WEST.51, X-WEST.52, X-WEST.57, X-WEST.58, X-WEST.63, X-WEST.64, X-WEST.69, X-WEST.70, X-WEST.71, X-WEST.76, X-WEST.77, X-WEST.82, X-WEST.G1, X-WEST.G2, X-WEST.G3, X-WEST.G4, X-WEST.G5, X-WEST.G6, X-WEST.G7, X-WEST.G8, X-WEST.G9, X-WEST.G10; also elsewhere on the board
JTAG_V: X-WEST.21; also elsewhere on the board
JX1_00_N: X-EAST.27; also elsewhere on the board
JX1_00_P: X-EAST.25; also elsewhere on the board
JX1_02_N: X-EAST.24; also elsewhere on the board
JX1_02_P: X-EAST.22; also elsewhere on the board
JX1_04_N: X-EAST.30; also elsewhere on the board
JX1_04_P: X-EAST.28; also elsewhere on the board
JX1_06_N: X-EAST.36; also elsewhere on the board
JX1_06_P: X-EAST.34; also elsewhere on the board
JX1_07_N: X-EAST.35; also elsewhere on the board
JX1_07_P: X-EAST.33; also elsewhere on the board
JX1_08_N: X-EAST.42; also elsewhere on the board
JX1_08_P: X-EAST.40; also elsewhere on the board
JX1_09_N: X-EAST.41; also elsewhere on the board
JX1_09_P: X-EAST.39; also elsewhere on the board
JX1_10_N: X-EAST.48; also elsewhere on the board
JX1_10_P: X-EAST.46; also elsewhere on the board
JX1_11_N: X-EAST.47; also elsewhere on the board
JX1_11_P: X-EAST.45; also elsewhere on the board
JX1_12_N: X-WEST.56; also elsewhere on the board
JX1_12_P: X-WEST.54; also elsewhere on the board
JX1_13_N: X-WEST.55; also elsewhere on the board
JX1_13_P: X-WEST.53; also elsewhere on the board
JX1_14_N: X-WEST.62; also elsewhere on the board
JX1_14_P: X-WEST.60; also elsewhere on the board
JX1_15_N: X-WEST.61; also elsewhere on the board
JX1_15_P: X-WEST.59; also elsewhere on the board
JX1_16_N: X-WEST.68; also elsewhere on the board
JX1_16_P: X-WEST.66; also elsewhere on the board
JX1_17_N: X-WEST.67; also elsewhere on the board
JX1_17_P: X-WEST.65; also elsewhere on the board
JX1_18_N: X-WEST.74; also elsewhere on the board
JX1_18_P: X-WEST.72; also elsewhere on the board
JX1_20_N: X-WEST.80; also elsewhere on the board
JX1_20_P: X-WEST.78; also elsewhere on the board
JX1_22_N: X-WEST.75; also elsewhere on the board
JX1_22_P: X-WEST.73; also elsewhere on the board
JX2_01_N: X-EAST.73; also elsewhere on the board
JX2_01_P: X-EAST.75; also elsewhere on the board
JX2_03_N: X-EAST.78; also elsewhere on the board
JX2_03_P: X-EAST.80; also elsewhere on the board
JX2_05_N: X-EAST.72; also elsewhere on the board
JX2_05_P: X-EAST.74; also elsewhere on the board
JX2_06_N: X-EAST.65; also elsewhere on the board
JX2_06_P: X-EAST.67; also elsewhere on the board
JX2_07_N: X-EAST.66; also elsewhere on the board
JX2_07_P: X-EAST.68; also elsewhere on the board
JX2_08_N: X-EAST.59; also elsewhere on the board
JX2_08_P: X-EAST.61; also elsewhere on the board
JX2_09_N: X-EAST.60; also elsewhere on the board
JX2_09_P: X-EAST.62; also elsewhere on the board
JX2_10_N: X-EAST.53; also elsewhere on the board
JX2_10_P: X-EAST.55; also elsewhere on the board
JX2_11_N: X-EAST.54; also elsewhere on the board
JX2_11_P: X-EAST.56; also elsewhere on the board
JX2_12_N: X-WEST.45; also elsewhere on the board
JX2_12_P: X-WEST.47; also elsewhere on the board
JX2_13_N: X-WEST.46; also elsewhere on the board
JX2_13_P: X-WEST.48; also elsewhere on the board
JX2_14_N: X-WEST.39; also elsewhere on the board
JX2_14_P: X-WEST.41; also elsewhere on the board
JX2_15_N: X-WEST.40; also elsewhere on the board
JX2_15_P: X-WEST.42; also elsewhere on the board
JX2_16_N: X-WEST.33; also elsewhere on the board
JX2_16_P: X-WEST.35; also elsewhere on the board
JX2_17_N: X-WEST.34; also elsewhere on the board
JX2_17_P: X-WEST.36; also elsewhere on the board
JX2_19_N: X-WEST.28; also elsewhere on the board
JX2_19_P: X-WEST.30; also elsewhere on the board
JX2_21_N: X-WEST.22; also elsewhere on the board
JX2_21_P: X-WEST.24; also elsewhere on the board
JX2_23_N: X-WEST.25; also elsewhere on the board
JX2_23_P: X-WEST.27; also elsewhere on the board
N_CHK_EN: X-WEST.94
N_CHK_V: X-WEST.92; also elsewhere on the board
N_I2C_EN: X-EAST.7
N_I2C_V: X-EAST.9; also elsewhere on the board
N_SCK: X-EAST.2; also elsewhere on the board
N_SCL: X-EAST.1; also elsewhere on the board
N_SDA: X-EAST.3; also elsewhere on the board
N_SDI: X-EAST.6; also elsewhere on the board
N_SDO: X-EAST.4; also elsewhere on the board
N_SPI_EN: X-EAST.8; also elsewhere on the board
N_SPI_V: X-EAST.10; also elsewhere on the board
N_VE_CV: X-WEST.96; also elsewhere on the board
N_VE_OV: X-WEST.95; also elsewhere on the board
N_VE_RS: X-WEST.88; also elsewhere on the board
N_VE_UV: X-WEST.85; also elsewhere on the board
N_VN_CV: X-WEST.98; also elsewhere on the board
N_VN_OV: X-WEST.97; also elsewhere on the board
N_VN_RS: X-WEST.86; also elsewhere on the board
N_VN_UV: X-WEST.87; also elsewhere on the board
N_VW_CV: X-WEST.100; also elsewhere on the board
N_VW_OV: X-WEST.99; also elsewhere on the board
N_VW_RS: X-WEST.84; also elsewhere on the board
N_VW_UV: X-WEST.89; also elsewhere on the board
RES1: X-WEST.79
RES2: X-WEST.81
RES3: X-WEST.83
RES4: X-EAST.79
RES5: X-EAST.81
RES6: X-EAST.83
S_CHK_EN: X-EAST.94
S_CHK_V: X-EAST.92; also elsewhere on the board
S_I2C_EN: X-WEST.7
S_I2C_V: X-WEST.9; also elsewhere on the board
S_SCK: X-WEST.2; also elsewhere on the board
S_SCL: X-WEST.1; also elsewhere on the board
S_SDA: X-WEST.3; also elsewhere on the board
S_SDI: X-WEST.6; also elsewhere on the board
S_SDO: X-WEST.4; also elsewhere on the board
S_SPI_EN: X-WEST.8; also elsewhere on the board
S_SPI_V: X-WEST.10; also elsewhere on the board
S_VE_CV: X-EAST.100; also elsewhere on the board
S_VE_OV: X-EAST.99; also elsewhere on the board
S_VE_RS: X-EAST.84; also elsewhere on the board
S_VE_UV: X-EAST.89; also elsewhere on the board
S_VS_CV: X-EAST.98; also elsewhere on the board
S_VS_OV: X-EAST.97; also elsewhere on the board
S_VS_RS: X-EAST.86; also elsewhere on the board
S_VS_UV: X-EAST.87; also elsewhere on the board
S_VW_CV: X-EAST.96; also elsewhere on the board
S_VW_OV: X-EAST.95; also elsewhere on the board
S_VW_RS: X-EAST.88; also elsewhere on the board
S_VW_UV: X-EAST.85; also elsewhere on the board
TCK: X-WEST.12; also elsewhere on the board
TDI: X-WEST.16; also elsewhere on the board
TDO: X-WEST.18; also elsewhere on the board
TMS: X-WEST.14; also elsewhere on the board
W_I2C_EN: X-WEST.13
W_I2C_V: X-WEST.11; also elsewhere on the board
W_SCL: X-WEST.15; also elsewhere on the board
W_SDA: X-WEST.17; also elsewhere on the board
W_VW_CV: X-WEST.90; also elsewhere on the board
W_VW_OV: X-WEST.93; also elsewhere on the board
W_VW_UV: X-WEST.91; also elsewhere on the board

Notes on the sheet:
AXIOM Beta Main Board [Test]
Copyright (C) 2014-2015 H.Poetzl Licensed under CERN OHL v.1.2
Interface Board Connection
