apertus-open-source-cinema/pcbs/boards/axiom_beta_main_board_v0.31_test.brd

## EAGLE design boards/axiom_beta_main_board_v0.31_test.brd (continued)

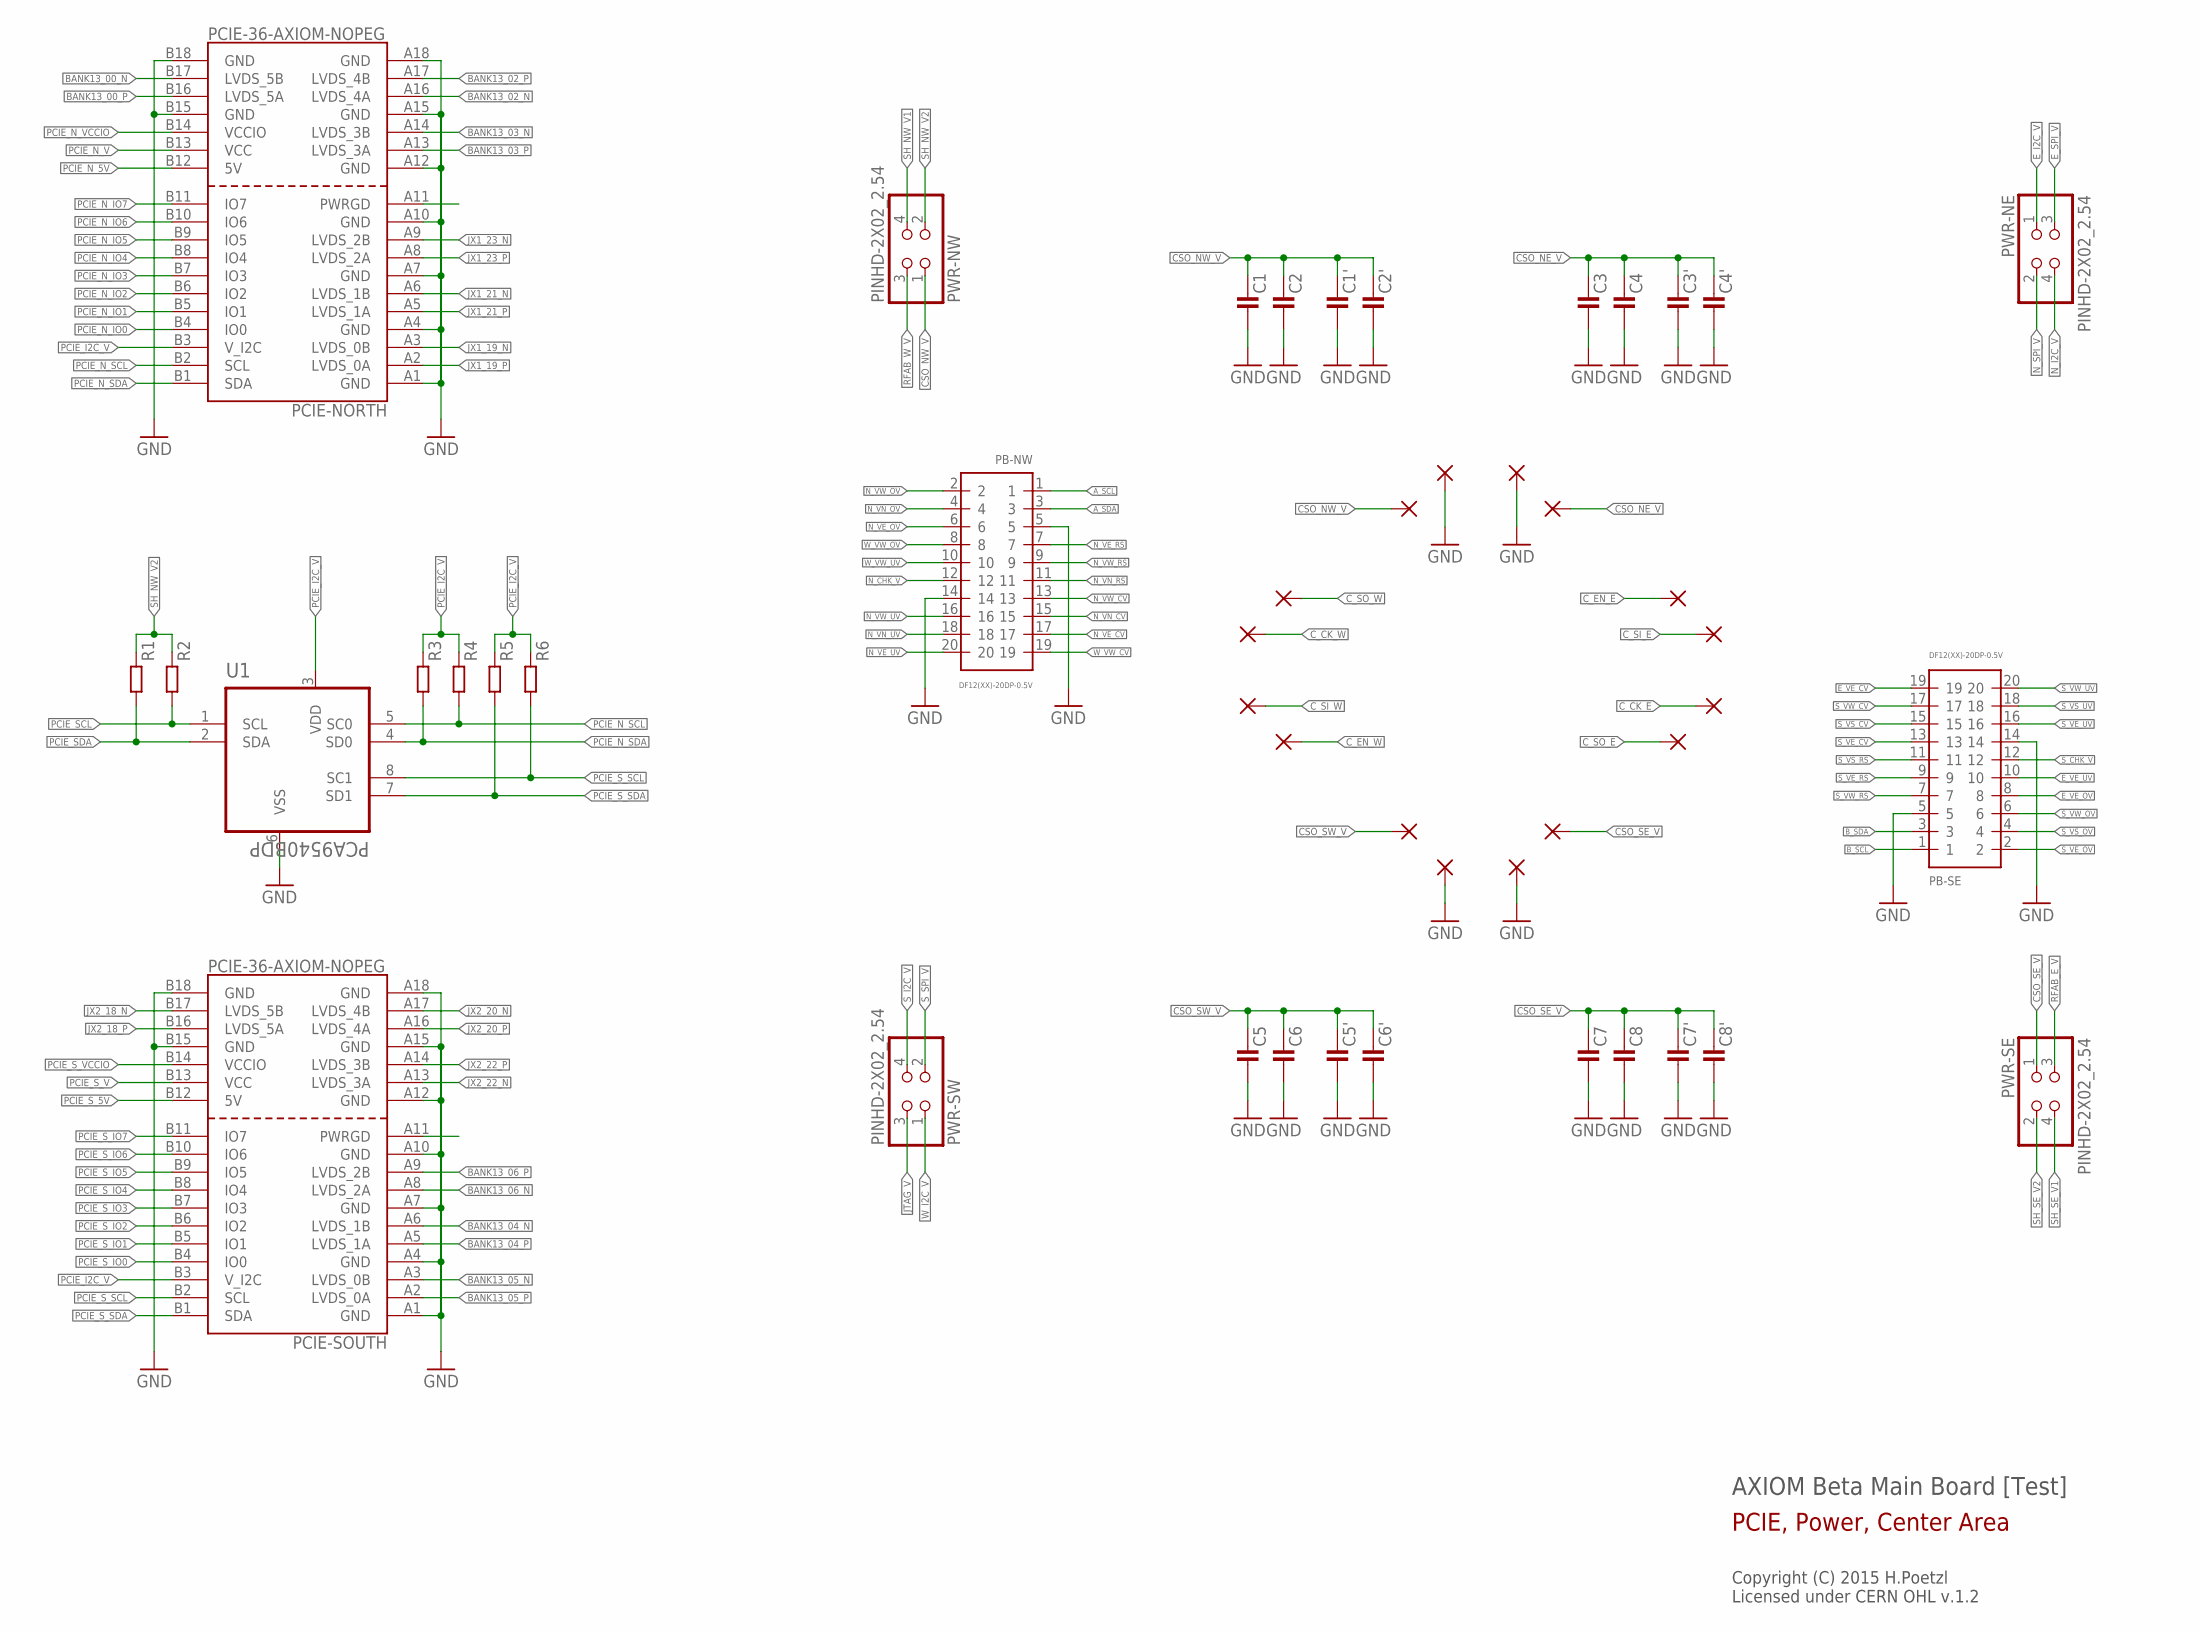
[picture p22: schematic axiom_beta_main_board_v0.31_test.sch, sheet 4]

Parts:
C1, C1', C3, C3', C5, C5', C7, C7': C0805-A; 0805-A
C2, C2', C4, C4', C6, C6', C8, C8': C0603-A; 0603-A
PB-NW: DF12(XX)-20DP-0.5V
PB-SE: DF12(XX)-20DP-0.5V
PCIE-NORTH: PCIE-36-AXIOM-NOPEG; PCIE-36-NOPEG
PCIE-SOUTH: PCIE-36-AXIOM-NOPEG; PCIE-36-NOPEG
PWR-NE: PINHD-2X02_2.54; 2X02
PWR-NW: PINHD-2X02_2.54; 2X02
PWR-SE: PINHD-2X02_2.54; 2X02
PWR-SW: PINHD-2X02_2.54; 2X02
R1, R2, R3, R4, R5, R6: R0402-B; 0402-B
U1: PCA9540BDP; SOP65P490X110-8N
U$1, U$2, U$3, U$4, U$5, U$6, U$11, U$14, U$15, U$16, U$17, U$18, U$19, U$20, U$21, U$22: PINPAD1.27MM; 1.2/0.6

Connections:
A_SCL: PB-NW.1; also elsewhere on the board
A_SDA: PB-NW.3; also elsewhere on the board
BANK13_00_N: PCIE-NORTH.B17 (LVDS_5B); also elsewhere on the board
BANK13_00_P: PCIE-NORTH.B16 (LVDS_5A); also elsewhere on the board
BANK13_02_N: PCIE-NORTH.A16 (LVDS_4A); also elsewhere on the board
BANK13_02_P: PCIE-NORTH.A17 (LVDS_4B); also elsewhere on the board
BANK13_03_N: PCIE-NORTH.A14 (LVDS_3B); also elsewhere on the board
BANK13_03_P: PCIE-NORTH.A13 (LVDS_3A); also elsewhere on the board
BANK13_04_N: PCIE-SOUTH.A6 (LVDS_1B); also elsewhere on the board
BANK13_04_P: PCIE-SOUTH.A5 (LVDS_1A); also elsewhere on the board
BANK13_05_N: PCIE-SOUTH.A3 (LVDS_0B); also elsewhere on the board
BANK13_05_P: PCIE-SOUTH.A2 (LVDS_0A); also elsewhere on the board
BANK13_06_N: PCIE-SOUTH.A8 (LVDS_2A); also elsewhere on the board
BANK13_06_P: PCIE-SOUTH.A9 (LVDS_2B); also elsewhere on the board
B_SCL: PB-SE.1; also elsewhere on the board
B_SDA: PB-SE.3; also elsewhere on the board
CSO_NE_V: C3.1, C3'.1, C4.1, C4'.1, U$19.1; also elsewhere on the board
CSO_NW_V: C1.1, C1'.1, C2.1, C2'.1, PWR-NW.1, U$18.1
CSO_SE_V: C7.1, C7'.1, C8.1, C8'.1, PWR-SE.1, U$21.1
CSO_SW_V: C5.1, C5'.1, C6.1, C6'.1, U$22.1; also elsewhere on the board
C_CK_E: U$14.1; also elsewhere on the board
C_CK_W: U$1.1; also elsewhere on the board
C_EN_E: U$3.1; also elsewhere on the board
C_EN_W: U$4.1; also elsewhere on the board
C_SI_E: U$15.1; also elsewhere on the board
C_SI_W: U$2.1; also elsewhere on the board
C_SO_E: U$16.1; also elsewhere on the board
C_SO_W: U$11.1; also elsewhere on the board
E_I2C_V: PWR-NE.1; also elsewhere on the board
E_SPI_V: PWR-NE.3; also elsewhere on the board
E_VE_CV: PB-SE.19; also elsewhere on the board
E_VE_OV: PB-SE.8; also elsewhere on the board
E_VE_UV: PB-SE.10; also elsewhere on the board
GND: C1.2, C1'.2, C2.2, C2'.2, C3.2, C3'.2, C4.2, C4'.2, C5.2, C5'.2, C6.2, C6'.2, C7.2, C7'.2, C8.2, C8'.2, PB-NW.5, PB-NW.14, PB-SE.5, PB-SE.14, PCIE-NORTH.A1 (GND), PCIE-NORTH.A4 (GND), PCIE-NORTH.A7 (GND), PCIE-NORTH.A10 (GND), PCIE-NORTH.A12 (GND), PCIE-NORTH.A15 (GND), PCIE-NORTH.A18 (GND), PCIE-NORTH.B15 (GND), PCIE-NORTH.B18 (GND), PCIE-SOUTH.A1 (GND), PCIE-SOUTH.A4 (GND), PCIE-SOUTH.A7 (GND), PCIE-SOUTH.A10 (GND), PCIE-SOUTH.A12 (GND), PCIE-SOUTH.A15 (GND), PCIE-SOUTH.A18 (GND), PCIE-SOUTH.B15 (GND), PCIE-SOUTH.B18 (GND), U1.6 (VSS), U$5.1, U$6.1, U$17.1, U$20.1; also elsewhere on the board
JTAG_V: PWR-SW.3; also elsewhere on the board
JX1_19_N: PCIE-NORTH.A3 (LVDS_0B); also elsewhere on the board
JX1_19_P: PCIE-NORTH.A2 (LVDS_0A); also elsewhere on the board
JX1_21_N: PCIE-NORTH.A6 (LVDS_1B); also elsewhere on the board
JX1_21_P: PCIE-NORTH.A5 (LVDS_1A); also elsewhere on the board
JX1_23_N: PCIE-NORTH.A9 (LVDS_2B); also elsewhere on the board
JX1_23_P: PCIE-NORTH.A8 (LVDS_2A); also elsewhere on the board
JX2_18_N: PCIE-SOUTH.B17 (LVDS_5B); also elsewhere on the board
JX2_18_P: PCIE-SOUTH.B16 (LVDS_5A); also elsewhere on the board
JX2_20_N: PCIE-SOUTH.A17 (LVDS_4B); also elsewhere on the board
JX2_20_P: PCIE-SOUTH.A16 (LVDS_4A); also elsewhere on the board
JX2_22_N: PCIE-SOUTH.A13 (LVDS_3A); also elsewhere on the board
JX2_22_P: PCIE-SOUTH.A14 (LVDS_3B); also elsewhere on the board
N_CHK_V: PB-NW.12; also elsewhere on the board
N_I2C_V: PWR-NE.4; also elsewhere on the board
N_SPI_V: PWR-NE.2; also elsewhere on the board
N_VE_CV: PB-NW.17; also elsewhere on the board
N_VE_OV: PB-NW.6; also elsewhere on the board
N_VE_RS: PB-NW.7; also elsewhere on the board
N_VE_UV: PB-NW.20; also elsewhere on the board
N_VN_CV: PB-NW.15; also elsewhere on the board
N_VN_OV: PB-NW.4; also elsewhere on the board
N_VN_RS: PB-NW.11; also elsewhere on the board
N_VN_UV: PB-NW.18; also elsewhere on the board
N_VW_CV: PB-NW.13; also elsewhere on the board
N_VW_OV: PB-NW.2; also elsewhere on the board
N_VW_RS: PB-NW.9; also elsewhere on the board
N_VW_UV: PB-NW.16; also elsewhere on the board
PCIE_I2C_V: PCIE-NORTH.B3 (V_I2C), PCIE-SOUTH.B3 (V_I2C), R3.1, R4.1, R5.1, R6.1, U1.3 (VDD); also elsewhere on the board
PCIE_N_5V: PCIE-NORTH.B12 (5V); also elsewhere on the board
PCIE_N_IO0: PCIE-NORTH.B4 (IO0); also elsewhere on the board
PCIE_N_IO1: PCIE-NORTH.B5 (IO1); also elsewhere on the board
PCIE_N_IO2: PCIE-NORTH.B6 (IO2); also elsewhere on the board
PCIE_N_IO3: PCIE-NORTH.B7 (IO3); also elsewhere on the board
PCIE_N_IO4: PCIE-NORTH.B8 (IO4); also elsewhere on the board
PCIE_N_IO5: PCIE-NORTH.B9 (IO5); also elsewhere on the board
PCIE_N_IO6: PCIE-NORTH.B10 (IO6); also elsewhere on the board
PCIE_N_IO7: PCIE-NORTH.B11 (IO7); also elsewhere on the board
PCIE_N_SCL: PCIE-NORTH.B2 (SCL), R4.2, U1.5 (SC0)
PCIE_N_SDA: PCIE-NORTH.B1 (SDA), R3.2, U1.4 (SD0)
PCIE_N_V: PCIE-NORTH.B13 (VCC); also elsewhere on the board
PCIE_N_VCCIO: PCIE-NORTH.B14 (VCCIO); also elsewhere on the board
PCIE_SCL: R2.2, U1.1 (SCL); also elsewhere on the board
PCIE_SDA: R1.2, U1.2 (SDA); also elsewhere on the board
PCIE_S_5V: PCIE-SOUTH.B12 (5V); also elsewhere on the board
PCIE_S_IO0: PCIE-SOUTH.B4 (IO0); also elsewhere on the board
PCIE_S_IO1: PCIE-SOUTH.B5 (IO1); also elsewhere on the board
PCIE_S_IO2: PCIE-SOUTH.B6 (IO2); also elsewhere on the board
PCIE_S_IO3: PCIE-SOUTH.B7 (IO3); also elsewhere on the board
PCIE_S_IO4: PCIE-SOUTH.B8 (IO4); also elsewhere on the board
PCIE_S_IO5: PCIE-SOUTH.B9 (IO5); also elsewhere on the board
PCIE_S_IO6: PCIE-SOUTH.B10 (IO6); also elsewhere on the board
PCIE_S_IO7: PCIE-SOUTH.B11 (IO7); also elsewhere on the board
PCIE_S_SCL: PCIE-SOUTH.B2 (SCL), R6.2, U1.8 (SC1)
PCIE_S_SDA: PCIE-SOUTH.B1 (SDA), R5.2, U1.7 (SD1)
PCIE_S_V: PCIE-SOUTH.B13 (VCC); also elsewhere on the board
PCIE_S_VCCIO: PCIE-SOUTH.B14 (VCCIO); also elsewhere on the board
RFAB_E_V: PWR-SE.3; also elsewhere on the board
RFAB_W_V: PWR-NW.3; also elsewhere on the board
SH_NW_V1: PWR-NW.4; also elsewhere on the board
SH_NW_V2: PWR-NW.2, R1.1, R2.1; also elsewhere on the board
SH_SE_V1: PWR-SE.4; also elsewhere on the board
SH_SE_V2: PWR-SE.2; also elsewhere on the board
S_CHK_V: PB-SE.12; also elsewhere on the board
S_I2C_V: PWR-SW.4; also elsewhere on the board
S_SPI_V: PWR-SW.2; also elsewhere on the board
S_VE_CV: PB-SE.13; also elsewhere on the board
S_VE_OV: PB-SE.2; also elsewhere on the board
S_VE_RS: PB-SE.9; also elsewhere on the board
S_VE_UV: PB-SE.16; also elsewhere on the board
S_VS_CV: PB-SE.15; also elsewhere on the board
S_VS_OV: PB-SE.4; also elsewhere on the board
S_VS_RS: PB-SE.11; also elsewhere on the board
S_VS_UV: PB-SE.18; also elsewhere on the board
S_VW_CV: PB-SE.17; also elsewhere on the board
S_VW_OV: PB-SE.6; also elsewhere on the board
S_VW_RS: PB-SE.7; also elsewhere on the board
S_VW_UV: PB-SE.20; also elsewhere on the board
W_I2C_V: PWR-SW.1; also elsewhere on the board
W_VW_CV: PB-NW.19; also elsewhere on the board
W_VW_OV: PB-NW.8; also elsewhere on the board
W_VW_UV: PB-NW.10; also elsewhere on the board

Notes on the sheet:
AXIOM Beta Main Board [Test]
Copyright (C) 2015 H.Poetzl Licensed under CERN OHL v.1.2
PCIE, Power, Center Area

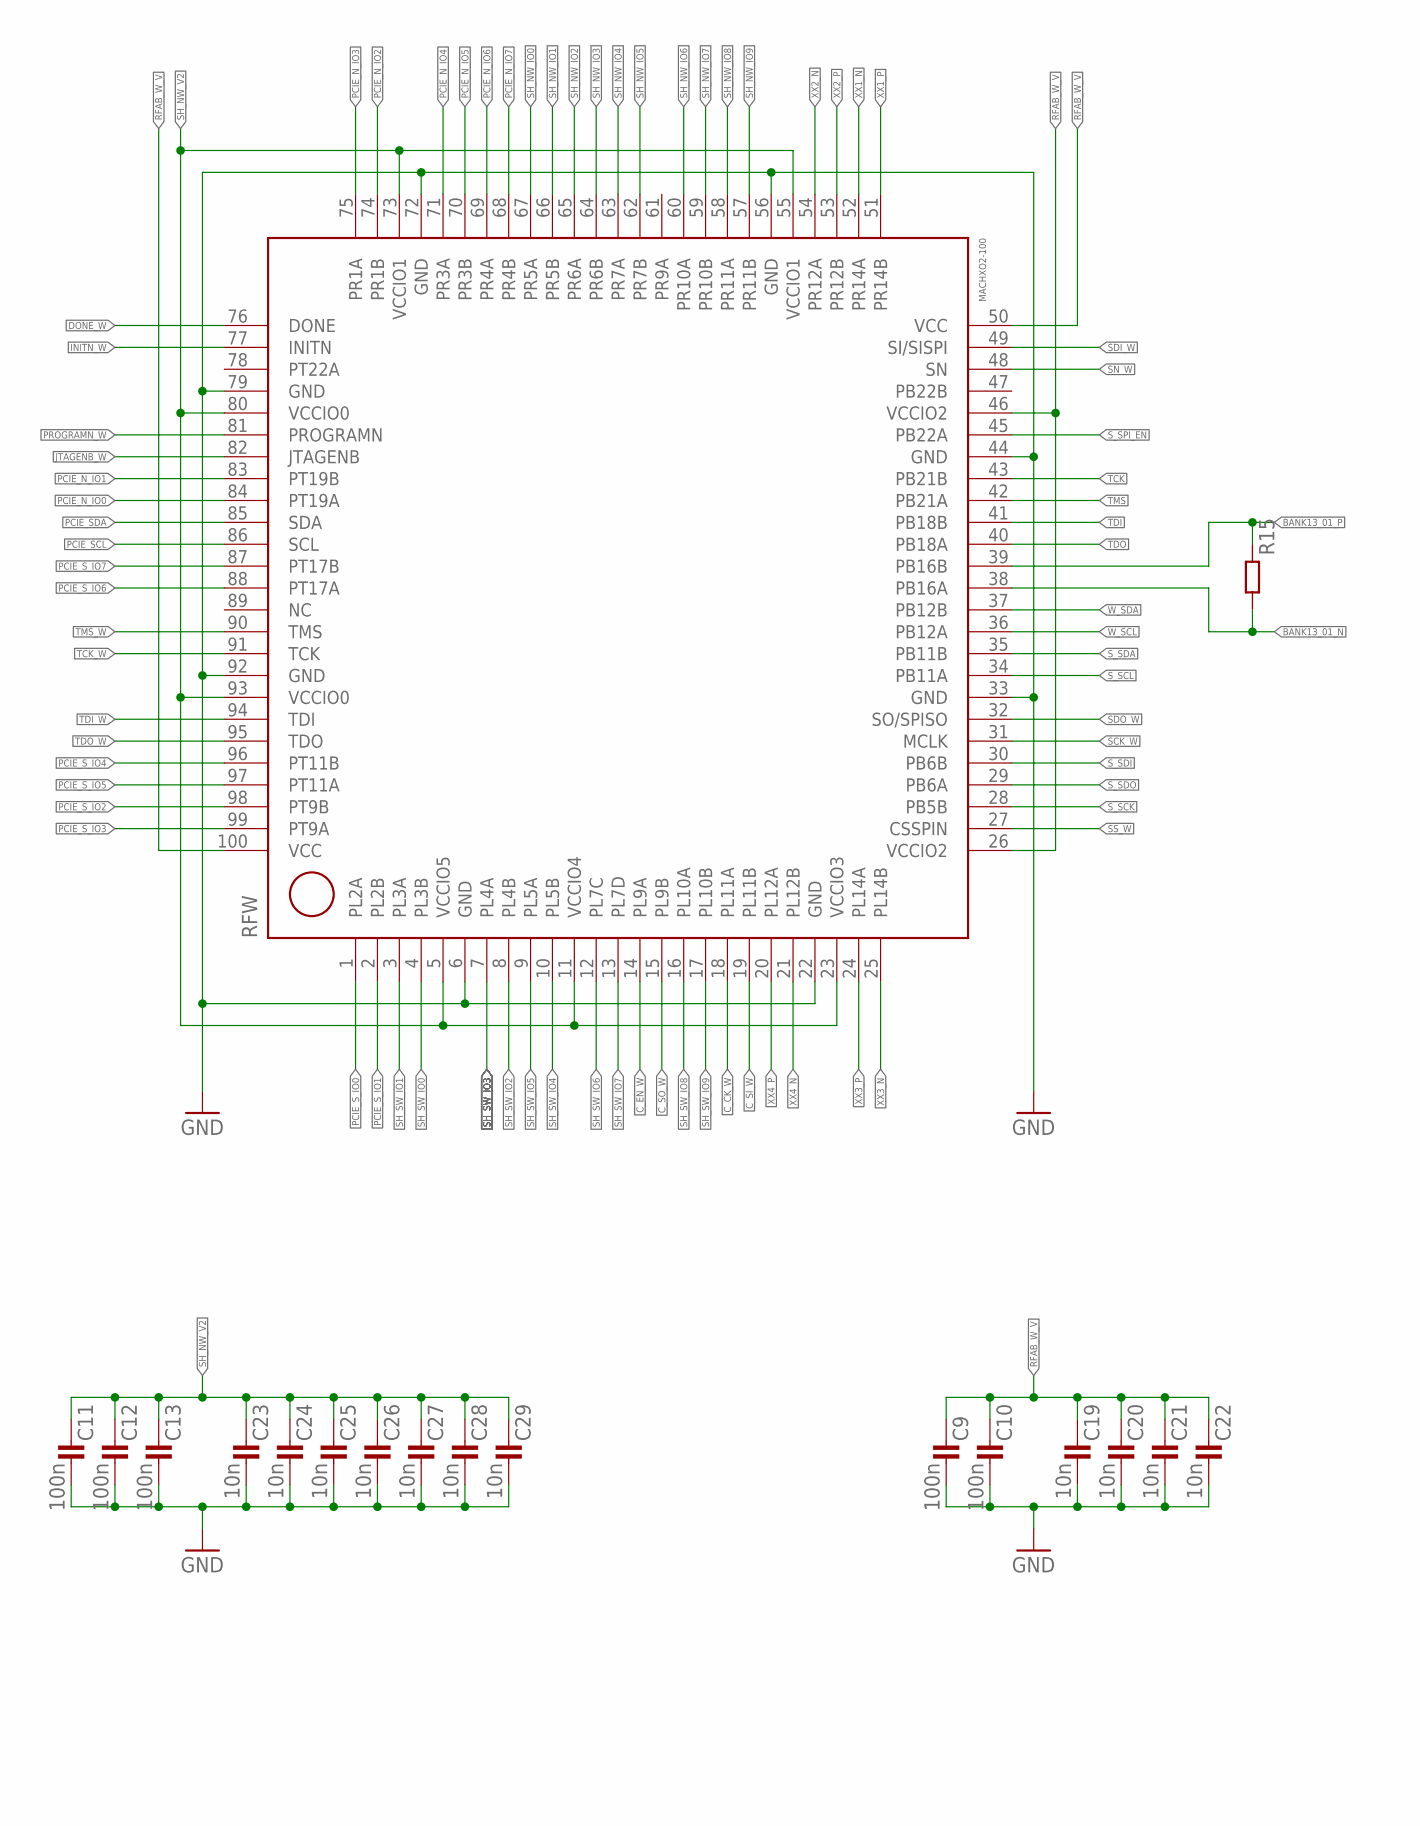
[picture p23: schematic axiom_beta_main_board_v0.31_test.sch, sheet 5, part in row 1, column 1]

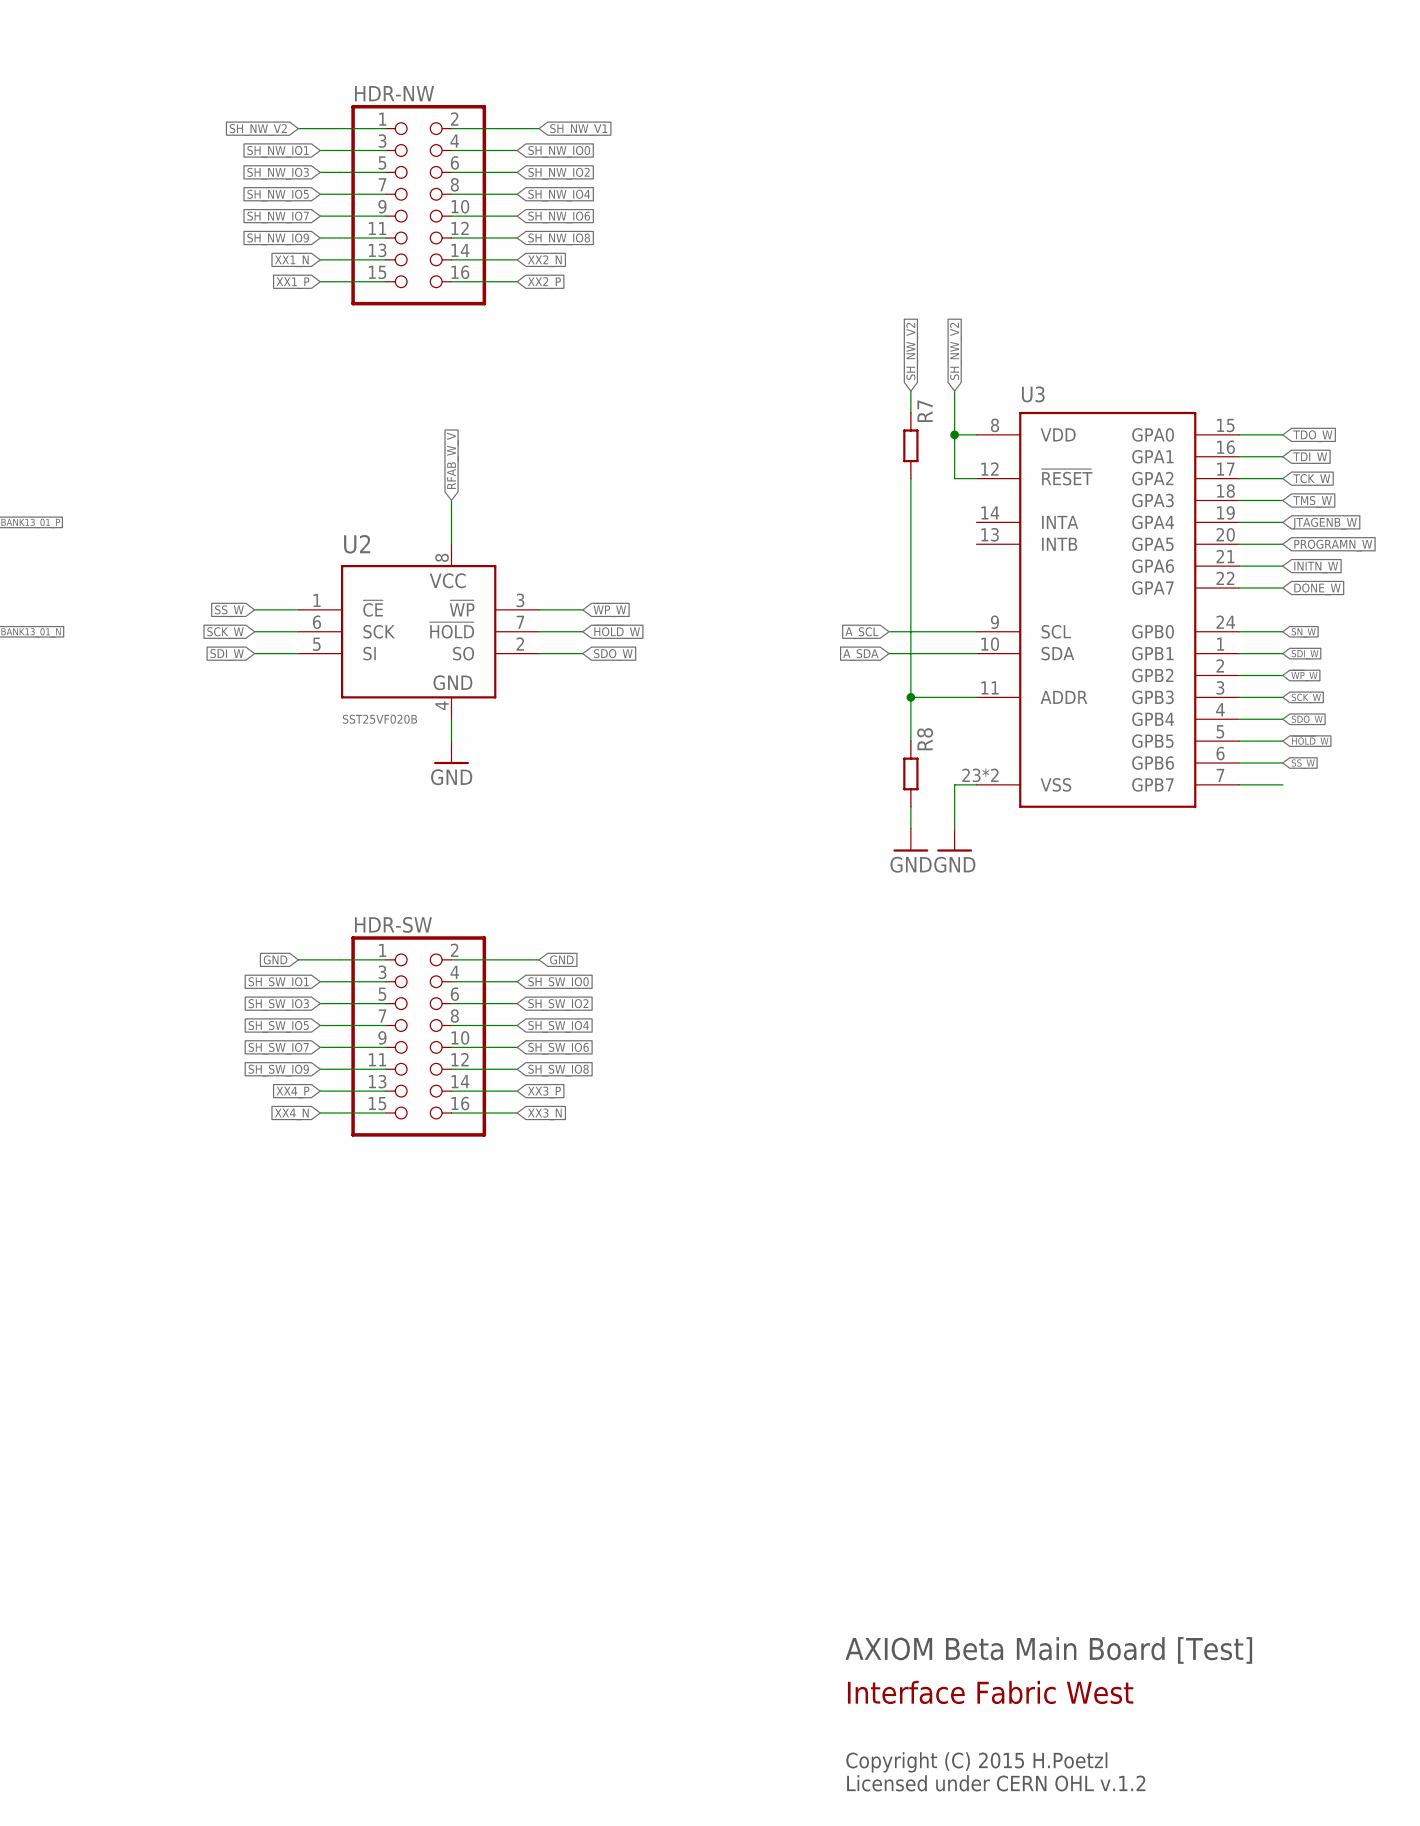
[picture p24: schematic axiom_beta_main_board_v0.31_test.sch, sheet 5, part in row 1, column 2]

Parts:
C9, C10, C11, C12, C13: 100n; 0402-B
C19, C20, C21, C22, C23, C24, C25, C26, C27, C28, C29: 10n; 0402-B
HDR-NW: PINHD-2X08_2.00_LPR; 62101621821
HDR-SW: PINHD-2X08_2.00_LPR; 62101621821
R7, R8: R0402-B; 0402-B
R15: R0201-B; 0201-B
RFW: MACHXO2-100; MACHXO2-100TQFP
U2: SST25VF020B; SOIC127P600X175-8N
U3: MCP23018QFN; QFN50P400X400X80-25N

Connections:
!HOLD!_W: U2.7 (!HOLD), U3.5 (GPB5)
!WP!_W: U2.3 (!WP), U3.2 (GPB2)
A_SCL: U3.9 (SCL); also elsewhere on the board
A_SDA: U3.10 (SDA); also elsewhere on the board
BANK13_01_N: R15.2, RFW.38 (PB16A); also elsewhere on the board
BANK13_01_P: R15.1, RFW.39 (PB16B); also elsewhere on the board
C_CK_W: RFW.18 (PL11A); also elsewhere on the board
C_EN_W: RFW.14 (PL9A); also elsewhere on the board
C_SI_W: RFW.19 (PL11B); also elsewhere on the board
C_SO_W: RFW.15 (PL9B); also elsewhere on the board
DONE_W: RFW.76 (DONE), U3.22 (GPA7)
GND: C9.2, C10.2, C11.2, C12.2, C13.2, C19.2, C20.2, C21.2, C22.2, C23.2, C24.2, C25.2, C26.2, C27.2, C28.2, C29.2, HDR-SW.1, HDR-SW.2, R8.2, RFW.6 (GND), RFW.22 (GND), RFW.33 (GND), RFW.44 (GND), RFW.56 (GND), RFW.72 (GND), RFW.79 (GND), RFW.92 (GND), U2.4 (VSS), U3.23 (VSS), U3.25 (VSS); also elsewhere on the board
INITN_W: RFW.77 (INITN), U3.21 (GPA6)
JTAGENB_W: RFW.82 (JTAGENB), U3.19 (GPA4)
unnamed: R7.2, R8.1, U3.11 (ADDR)
PCIE_N_IO0: RFW.84 (PT19A); also elsewhere on the board
PCIE_N_IO1: RFW.83 (PT19B); also elsewhere on the board
PCIE_N_IO2: RFW.74 (PR1B); also elsewhere on the board
PCIE_N_IO3: RFW.75 (PR1A); also elsewhere on the board
PCIE_N_IO4: RFW.71 (PR3A); also elsewhere on the board
PCIE_N_IO5: RFW.70 (PR3B); also elsewhere on the board
PCIE_N_IO6: RFW.69 (PR4A); also elsewhere on the board
PCIE_N_IO7: RFW.68 (PR4B); also elsewhere on the board
PCIE_SCL: RFW.86 (SCL); also elsewhere on the board
PCIE_SDA: RFW.85 (SDA); also elsewhere on the board
PCIE_S_IO0: RFW.1 (PL2A); also elsewhere on the board
PCIE_S_IO1: RFW.2 (PL2B); also elsewhere on the board
PCIE_S_IO2: RFW.98 (PT9B); also elsewhere on the board
PCIE_S_IO3: RFW.99 (PT9A); also elsewhere on the board
PCIE_S_IO4: RFW.96 (PT11B); also elsewhere on the board
PCIE_S_IO5: RFW.97 (PT11A); also elsewhere on the board
PCIE_S_IO6: RFW.88 (PT17A); also elsewhere on the board
PCIE_S_IO7: RFW.87 (PT17B); also elsewhere on the board
PROGRAMN_W: RFW.81 (PROGRAMN), U3.20 (GPA5)
RFAB_W_V: C9.1, C10.1, C19.1, C20.1, C21.1, C22.1, RFW.26 (VCCIO2), RFW.46 (VCCIO2), RFW.50 (VCC), RFW.100 (VCC), U2.8 (VCC); also elsewhere on the board
SCK_W: RFW.31 (MCLK), U2.6 (SCK), U3.3 (GPB3)
SDI_W: RFW.49 (SI/SISPI), U2.5 (SI), U3.1 (GPB1)
SDO_W: RFW.32 (SO/SPISO), U2.2 (SO), U3.4 (GPB4)
SH_NW_IO0: HDR-NW.4, RFW.67 (PR5A)
SH_NW_IO1: HDR-NW.3, RFW.66 (PR5B)
SH_NW_IO2: HDR-NW.6, RFW.65 (PR6A)
SH_NW_IO3: HDR-NW.5, RFW.64 (PR6B)
SH_NW_IO4: HDR-NW.8, RFW.63 (PR7A)
SH_NW_IO5: HDR-NW.7, RFW.62 (PR7B)
SH_NW_IO6: HDR-NW.10, RFW.60 (PR10A)
SH_NW_IO7: HDR-NW.9, RFW.59 (PR10B)
SH_NW_IO8: HDR-NW.12, RFW.58 (PR11A)
SH_NW_IO9: HDR-NW.11, RFW.57 (PR11B)
SH_NW_V1: HDR-NW.2; also elsewhere on the board
SH_NW_V2: C11.1, C12.1, C13.1, C23.1, C24.1, C25.1, C26.1, C27.1, C28.1, C29.1, HDR-NW.1, R7.1, RFW.5 (VCCIO5), RFW.11 (VCCIO4), RFW.23 (VCCIO3), RFW.55 (VCCIO1), RFW.73 (VCCIO1), RFW.80 (VCCIO0), RFW.93 (VCCIO0), U3.8 (VDD), U3.12 (!RESET); also elsewhere on the board
SH_SW_IO0: HDR-SW.4, RFW.4 (PL3B)
SH_SW_IO1: HDR-SW.3, RFW.3 (PL3A)
SH_SW_IO2: HDR-SW.6, RFW.8 (PL4B)
SH_SW_IO3: HDR-SW.5, RFW.7 (PL4A)
SH_SW_IO4: HDR-SW.8, RFW.10 (PL5B)
SH_SW_IO5: HDR-SW.7, RFW.9 (PL5A)
SH_SW_IO6: HDR-SW.10, RFW.12 (PL7C)
SH_SW_IO7: HDR-SW.9, RFW.13 (PL7D)
SH_SW_IO8: HDR-SW.12, RFW.16 (PL10A)
SH_SW_IO9: HDR-SW.11, RFW.17 (PL10B)
SN_W: RFW.48 (SN), U3.24 (GPB0)
SS_W: RFW.27 (CSSPIN), U2.1 (!CE), U3.6 (GPB6)
S_SCK: RFW.28 (PB5B); also elsewhere on the board
S_SCL: RFW.34 (PB11A); also elsewhere on the board
S_SDA: RFW.35 (PB11B); also elsewhere on the board
S_SDI: RFW.30 (PB6B); also elsewhere on the board
S_SDO: RFW.29 (PB6A); also elsewhere on the board
S_SPI_EN: RFW.45 (PB22A); also elsewhere on the board
TCK: RFW.43 (PB21B); also elsewhere on the board
TCK_W: RFW.91 (TCK), U3.17 (GPA2)
TDI: RFW.41 (PB18B); also elsewhere on the board
TDI_W: RFW.94 (TDI), U3.16 (GPA1)
TDO: RFW.40 (PB18A); also elsewhere on the board
TDO_W: RFW.95 (TDO), U3.15 (GPA0)
TMS: RFW.42 (PB21A); also elsewhere on the board
TMS_W: RFW.90 (TMS), U3.18 (GPA3)
W_SCL: RFW.36 (PB12A); also elsewhere on the board
W_SDA: RFW.37 (PB12B); also elsewhere on the board
XX1_N: HDR-NW.13, RFW.52 (PR14A)
XX1_P: HDR-NW.15, RFW.51 (PR14B)
XX2_N: HDR-NW.14, RFW.54 (PR12A)
XX2_P: HDR-NW.16, RFW.53 (PR12B)
XX3_N: HDR-SW.16, RFW.25 (PL14B)
XX3_P: HDR-SW.14, RFW.24 (PL14A)
XX4_N: HDR-SW.15, RFW.21 (PL12B)
XX4_P: HDR-SW.13, RFW.20 (PL12A)

Notes on the sheet:
AXIOM Beta Main Board [Test]
Copyright (C) 2015 H.Poetzl Licensed under CERN OHL v.1.2
Interface Fabric West
