apertus-open-source-cinema/pcbs/boards/axiom_beta_main_board_v0.31_test.brd

## EAGLE design boards/axiom_beta_main_board_v0.31_test.brd (continued)

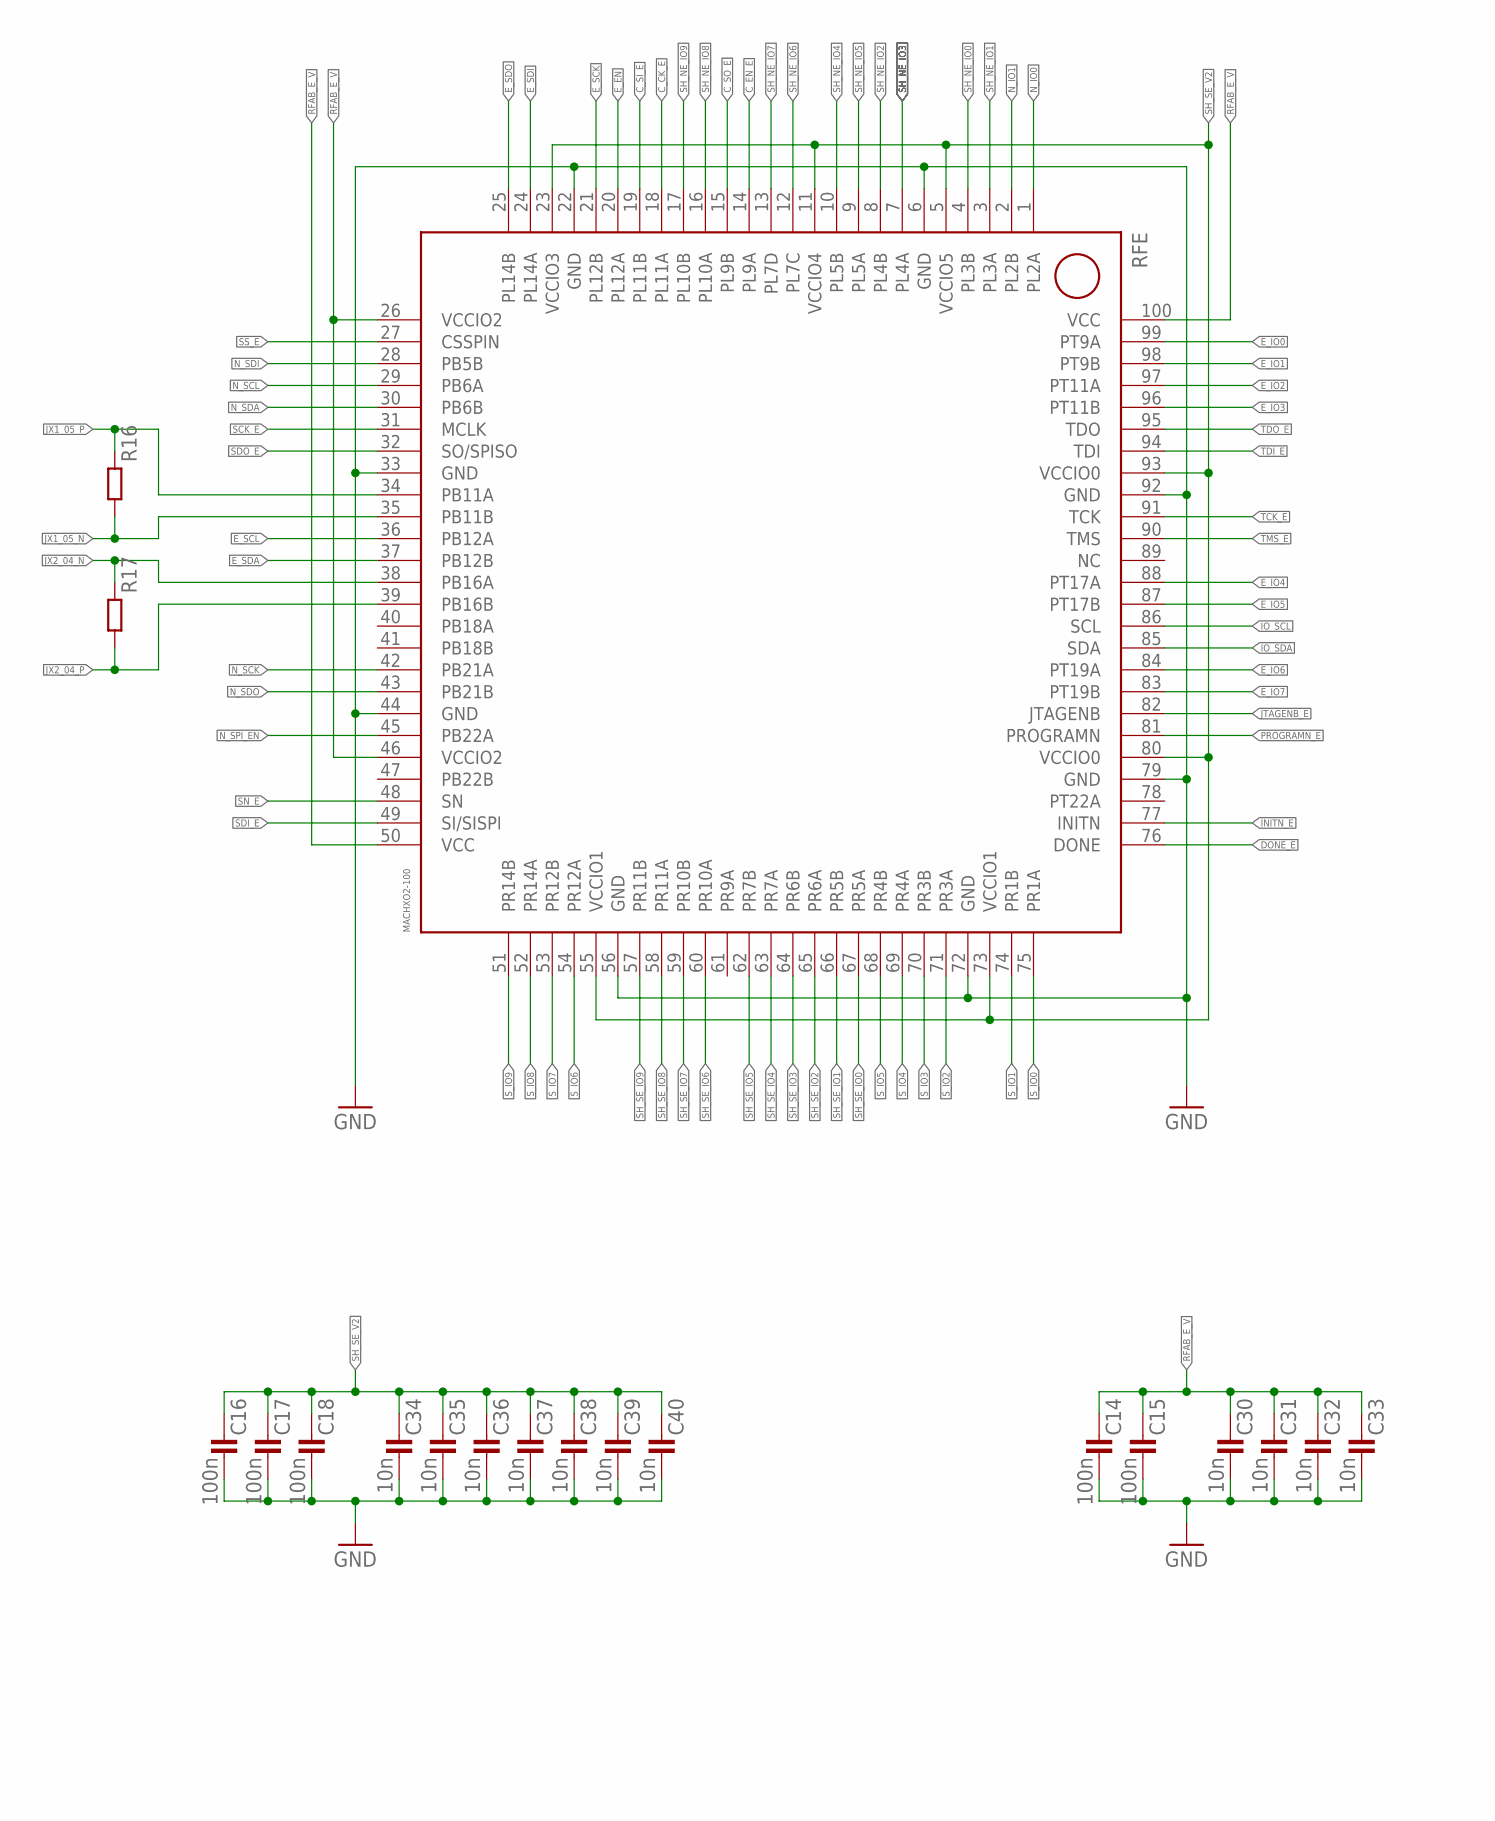
[picture p25: schematic axiom_beta_main_board_v0.31_test.sch, sheet 6, part in row 1, column 1]

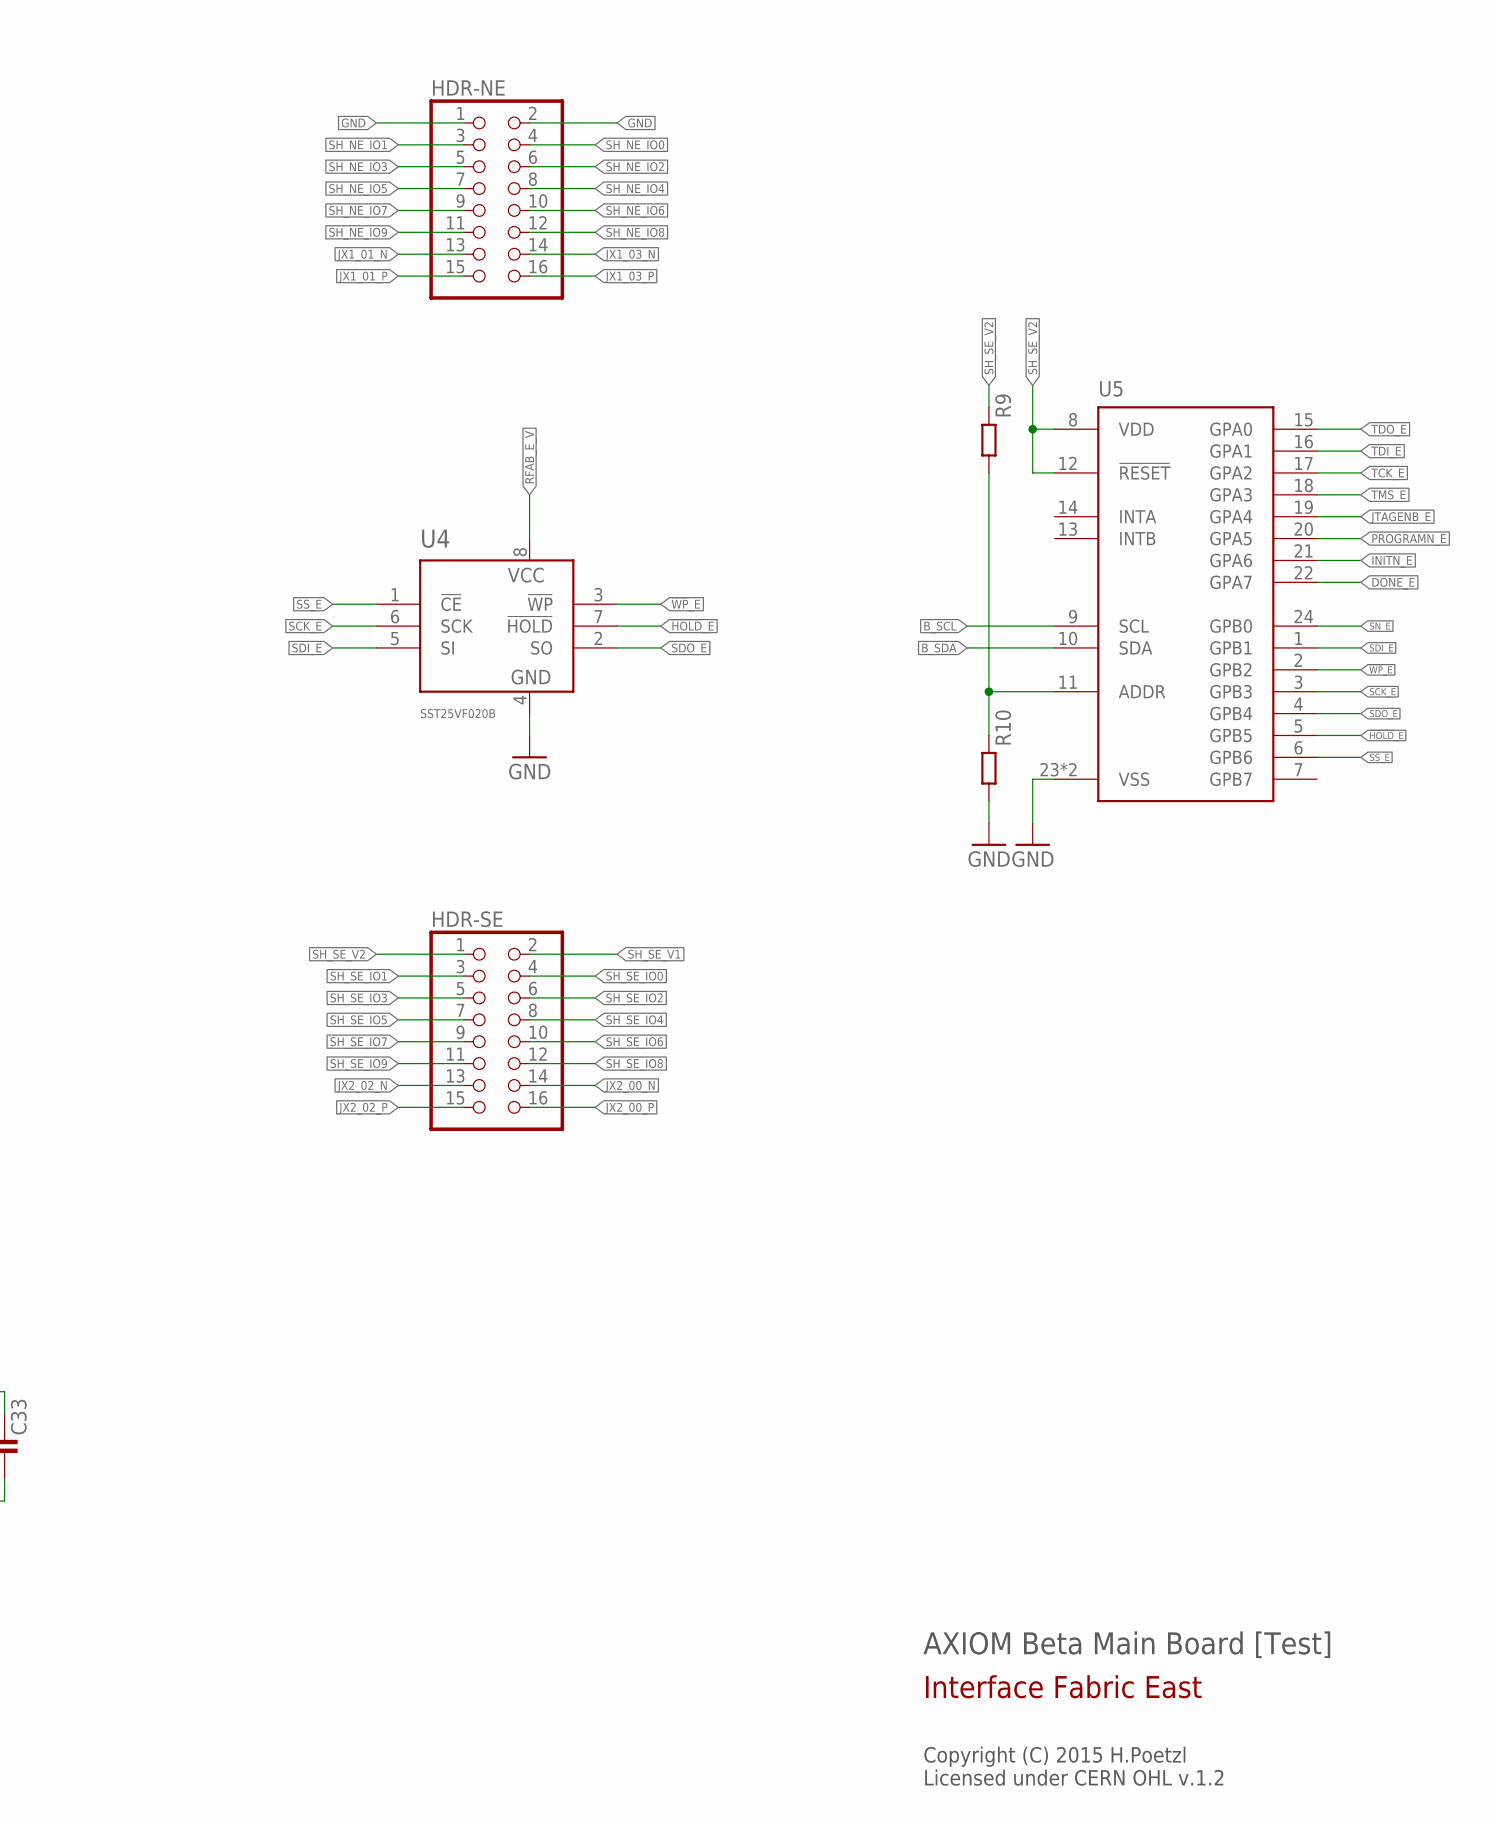
[picture p26: schematic axiom_beta_main_board_v0.31_test.sch, sheet 6, part in row 1, column 2]

Parts:
C14, C15, C16, C17, C18: 100n; 0402-B
C30, C31, C32, C33, C34, C35, C36, C37, C38, C39, C40: 10n; 0402-B
HDR-NE: PINHD-2X08_2.00_LPR; 62101621821
HDR-SE: PINHD-2X08_2.00_LPR; 62101621821
R9, R10: R0402-B; 0402-B
R16, R17: R0201-B; 0201-B
RFE: MACHXO2-100; MACHXO2-100TQFP
U4: SST25VF020B; SOIC127P600X175-8N
U5: MCP23018QFN; QFN50P400X400X80-25N

Connections:
!HOLD!_E: U4.7 (!HOLD), U5.5 (GPB5)
!WP!_E: U4.3 (!WP), U5.2 (GPB2)
B_SCL: U5.9 (SCL); also elsewhere on the board
B_SDA: U5.10 (SDA); also elsewhere on the board
C_CK_E: RFE.18 (PL11A); also elsewhere on the board
C_EN_E: RFE.14 (PL9A); also elsewhere on the board
C_SI_E: RFE.19 (PL11B); also elsewhere on the board
C_SO_E: RFE.15 (PL9B); also elsewhere on the board
DONE_E: RFE.76 (DONE), U5.22 (GPA7)
E_EN: RFE.20 (PL12A); also elsewhere on the board
E_IO0: RFE.99 (PT9A)
E_IO1: RFE.98 (PT9B)
E_IO2: RFE.97 (PT11A)
E_IO3: RFE.96 (PT11B)
E_IO4: RFE.88 (PT17A)
E_IO5: RFE.87 (PT17B)
E_IO6: RFE.84 (PT19A)
E_IO7: RFE.83 (PT19B)
E_SCK: RFE.21 (PL12B); also elsewhere on the board
E_SCL: RFE.36 (PB12A); also elsewhere on the board
E_SDA: RFE.37 (PB12B); also elsewhere on the board
E_SDI: RFE.24 (PL14A); also elsewhere on the board
E_SDO: RFE.25 (PL14B); also elsewhere on the board
GND: C14.2, C15.2, C16.2, C17.2, C18.2, C30.2, C31.2, C32.2, C33.2, C34.2, C35.2, C36.2, C37.2, C38.2, C39.2, C40.2, HDR-NE.1, HDR-NE.2, R10.2, RFE.6 (GND), RFE.22 (GND), RFE.33 (GND), RFE.44 (GND), RFE.56 (GND), RFE.72 (GND), RFE.79 (GND), RFE.92 (GND), U4.4 (VSS), U5.23 (VSS), U5.25 (VSS); also elsewhere on the board
INITN_E: RFE.77 (INITN), U5.21 (GPA6)
IO_SCL: RFE.86 (SCL)
IO_SDA: RFE.85 (SDA)
JTAGENB_E: RFE.82 (JTAGENB), U5.19 (GPA4)
JX1_01_N: HDR-NE.13; also elsewhere on the board
JX1_01_P: HDR-NE.15; also elsewhere on the board
JX1_03_N: HDR-NE.14; also elsewhere on the board
JX1_03_P: HDR-NE.16; also elsewhere on the board
JX1_05_N: R16.2, RFE.35 (PB11B); also elsewhere on the board
JX1_05_P: R16.1, RFE.34 (PB11A); also elsewhere on the board
JX2_00_N: HDR-SE.14; also elsewhere on the board
JX2_00_P: HDR-SE.16; also elsewhere on the board
JX2_02_N: HDR-SE.13; also elsewhere on the board
JX2_02_P: HDR-SE.15; also elsewhere on the board
JX2_04_N: R17.1, RFE.38 (PB16A); also elsewhere on the board
JX2_04_P: R17.2, RFE.39 (PB16B); also elsewhere on the board
unnamed: R9.2, R10.1, U5.11 (ADDR)
N_IO0: RFE.1 (PL2A); also elsewhere on the board
N_IO1: RFE.2 (PL2B)
N_SCK: RFE.42 (PB21A); also elsewhere on the board
N_SCL: RFE.29 (PB6A); also elsewhere on the board
N_SDA: RFE.30 (PB6B); also elsewhere on the board
N_SDI: RFE.28 (PB5B); also elsewhere on the board
N_SDO: RFE.43 (PB21B); also elsewhere on the board
N_SPI_EN: RFE.45 (PB22A); also elsewhere on the board
PROGRAMN_E: RFE.81 (PROGRAMN), U5.20 (GPA5)
RFAB_E_V: C14.1, C15.1, C30.1, C31.1, C32.1, C33.1, RFE.26 (VCCIO2), RFE.46 (VCCIO2), RFE.50 (VCC), RFE.100 (VCC), U4.8 (VCC); also elsewhere on the board
SCK_E: RFE.31 (MCLK), U4.6 (SCK), U5.3 (GPB3)
SDI_E: RFE.49 (SI/SISPI), U4.5 (SI), U5.1 (GPB1)
SDO_E: RFE.32 (SO/SPISO), U4.2 (SO), U5.4 (GPB4)
SH_NE_IO0: HDR-NE.4, RFE.4 (PL3B)
SH_NE_IO1: HDR-NE.3, RFE.3 (PL3A)
SH_NE_IO2: HDR-NE.6, RFE.8 (PL4B)
SH_NE_IO3: HDR-NE.5, RFE.7 (PL4A)
SH_NE_IO4: HDR-NE.8, RFE.10 (PL5B)
SH_NE_IO5: HDR-NE.7, RFE.9 (PL5A)
SH_NE_IO6: HDR-NE.10, RFE.12 (PL7C)
SH_NE_IO7: HDR-NE.9, RFE.13 (PL7D)
SH_NE_IO8: HDR-NE.12, RFE.16 (PL10A)
SH_NE_IO9: HDR-NE.11, RFE.17 (PL10B)
SH_SE_IO0: HDR-SE.4, RFE.67 (PR5A)
SH_SE_IO1: HDR-SE.3, RFE.66 (PR5B)
SH_SE_IO2: HDR-SE.6, RFE.65 (PR6A)
SH_SE_IO3: HDR-SE.5, RFE.64 (PR6B)
SH_SE_IO4: HDR-SE.8, RFE.63 (PR7A)
SH_SE_IO5: HDR-SE.7, RFE.62 (PR7B)
SH_SE_IO6: HDR-SE.10, RFE.60 (PR10A)
SH_SE_IO7: HDR-SE.9, RFE.59 (PR10B)
SH_SE_IO8: HDR-SE.12, RFE.58 (PR11A)
SH_SE_IO9: HDR-SE.11, RFE.57 (PR11B)
SH_SE_V1: HDR-SE.2; also elsewhere on the board
SH_SE_V2: C16.1, C17.1, C18.1, C34.1, C35.1, C36.1, C37.1, C38.1, C39.1, C40.1, HDR-SE.1, R9.1, RFE.5 (VCCIO5), RFE.11 (VCCIO4), RFE.23 (VCCIO3), RFE.55 (VCCIO1), RFE.73 (VCCIO1), RFE.80 (VCCIO0), RFE.93 (VCCIO0), U5.8 (VDD), U5.12 (!RESET); also elsewhere on the board
SN_E: RFE.48 (SN), U5.24 (GPB0)
SS_E: RFE.27 (CSSPIN), U4.1 (!CE), U5.6 (GPB6)
S_IO0: RFE.75 (PR1A); also elsewhere on the board
S_IO1: RFE.74 (PR1B)
S_IO2: RFE.71 (PR3A)
S_IO3: RFE.70 (PR3B)
S_IO4: RFE.69 (PR4A)
S_IO5: RFE.68 (PR4B)
S_IO6: RFE.54 (PR12A)
S_IO7: RFE.53 (PR12B)
S_IO8: RFE.52 (PR14A)
S_IO9: RFE.51 (PR14B)
TCK_E: RFE.91 (TCK), U5.17 (GPA2)
TDI_E: RFE.94 (TDI), U5.16 (GPA1)
TDO_E: RFE.95 (TDO), U5.15 (GPA0)
TMS_E: RFE.90 (TMS), U5.18 (GPA3)

Notes on the sheet:
AXIOM Beta Main Board [Test]
Copyright (C) 2015 H.Poetzl Licensed under CERN OHL v.1.2
Interface Fabric East

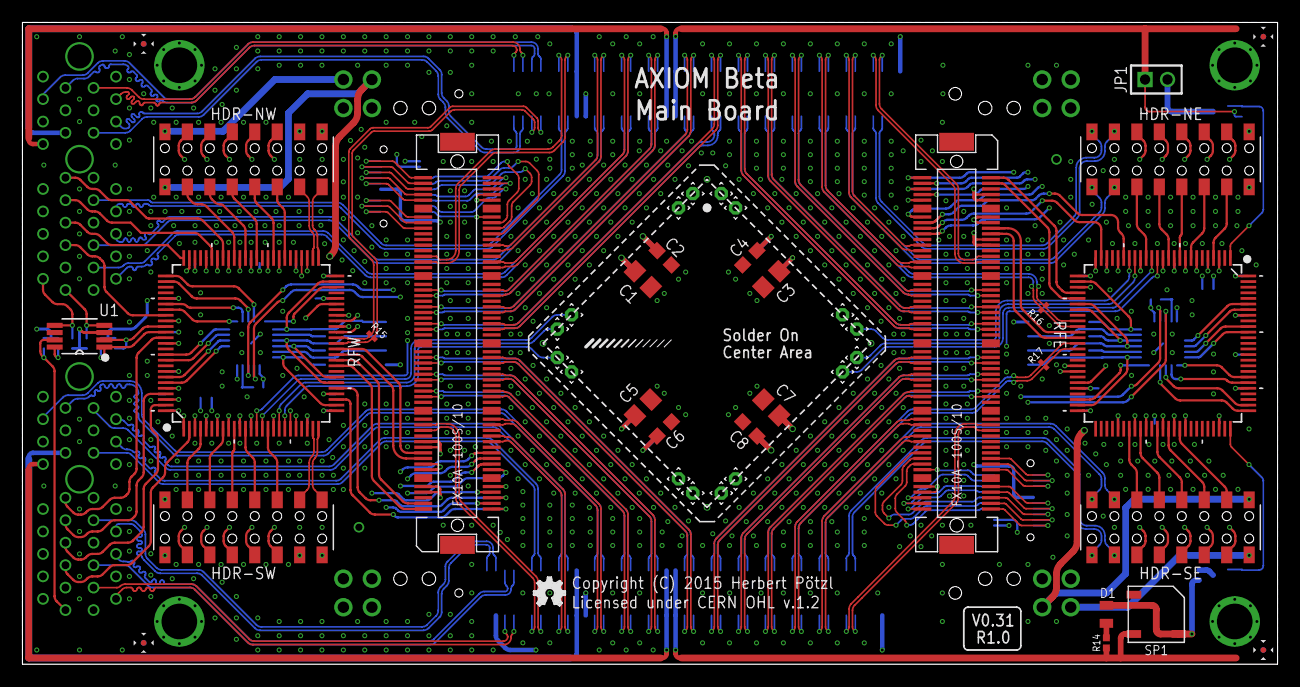
[picture p27: board axiom_beta_main_board_v0.31_test.brd from above]

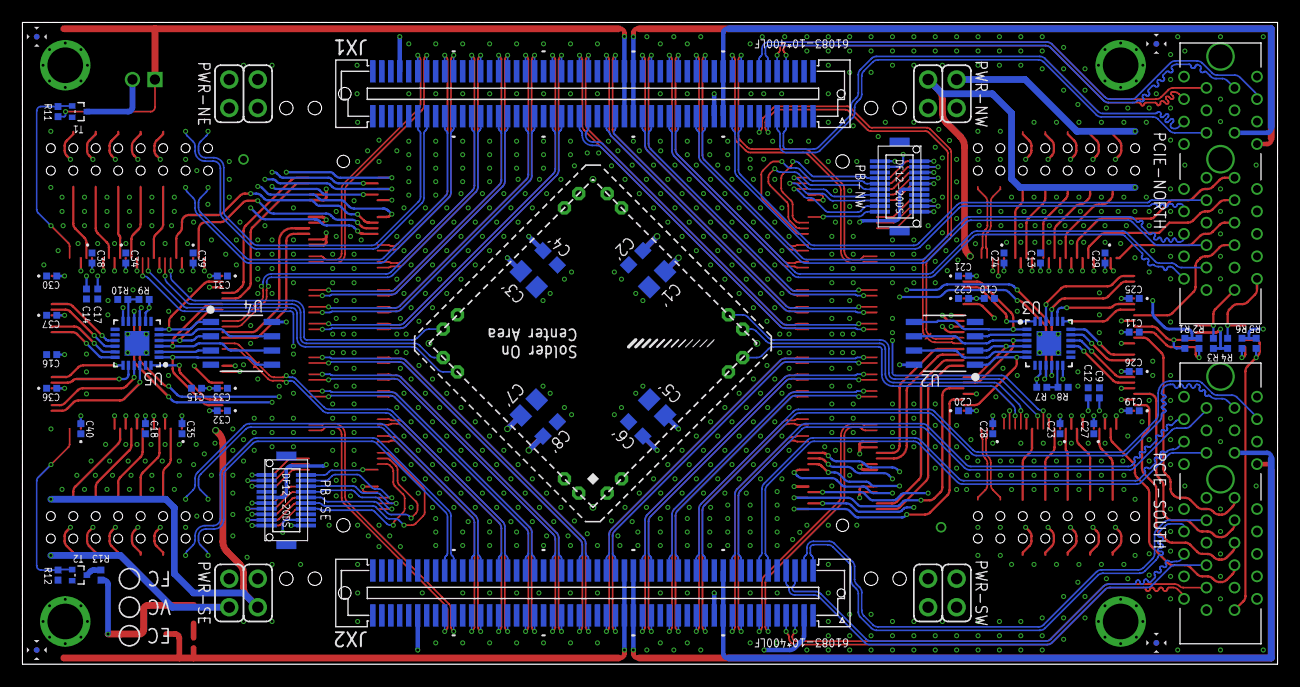
[picture p28: board axiom_beta_main_board_v0.31_test.brd from below]

Board: 4 copper layers, 111.8 x 57.1 mm, 109 parts (68 on the bottom side), 314 nets.

Other parts of the board:
LOGO1: OSHW_LOGO_FILLX0100-NT; OSHW_FILLX100_NOTEXT
