apertus-open-source-cinema/pcbs/boards/axiom_beta_plugin_module_TE0714_SATA_v0.6_r1.2.brd

## EAGLE design boards/axiom_beta_plugin_module_TE0714_SATA_v0.6_r1.2.brd (2021-12-13)

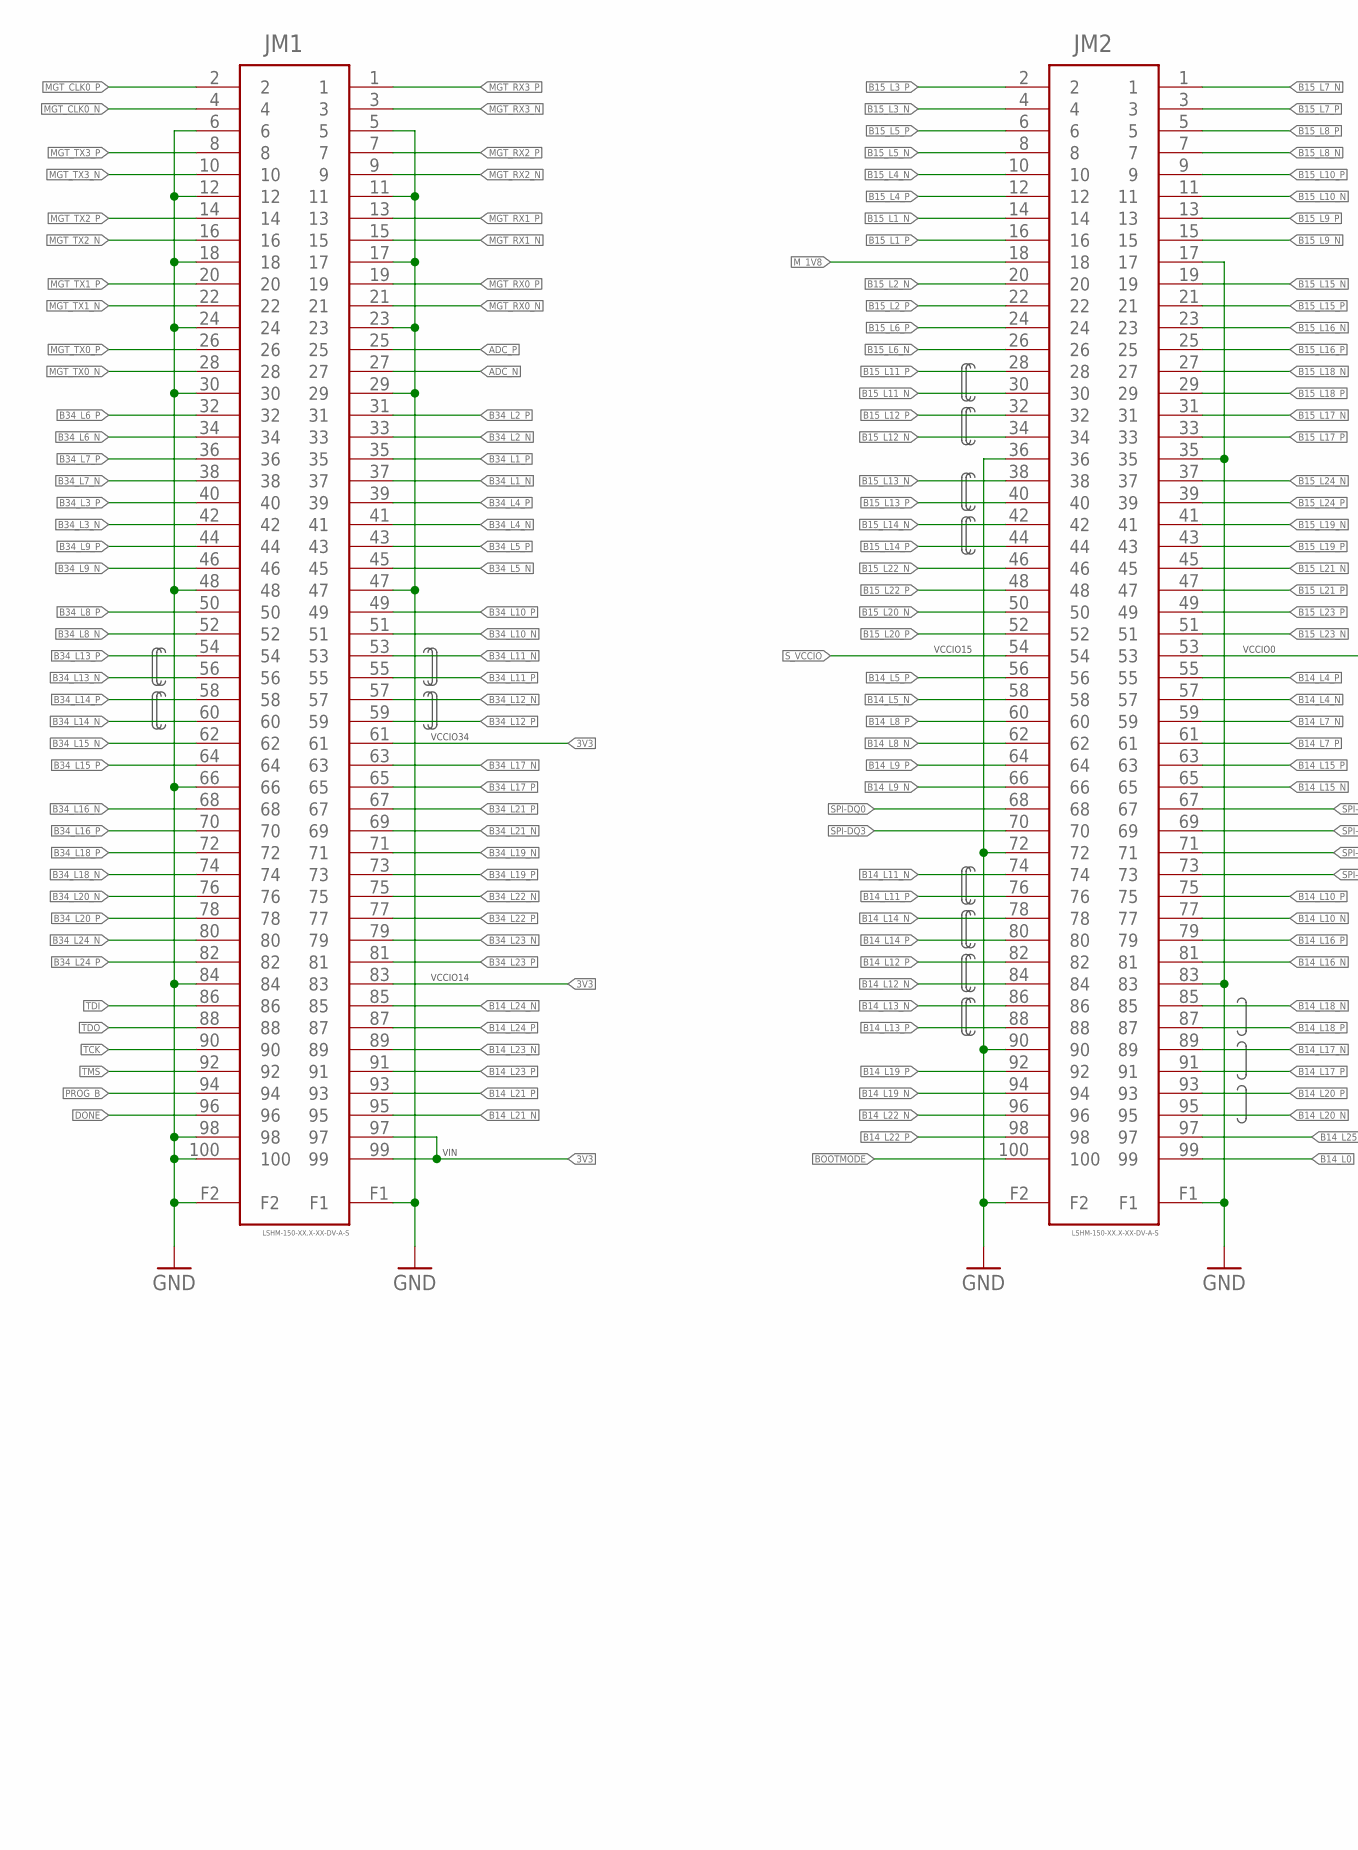
[picture p29: schematic axiom_beta_plugin_module_TE0714_SATA_v0.6_r1.2.sch, sheet 1, part in row 1, column 1]

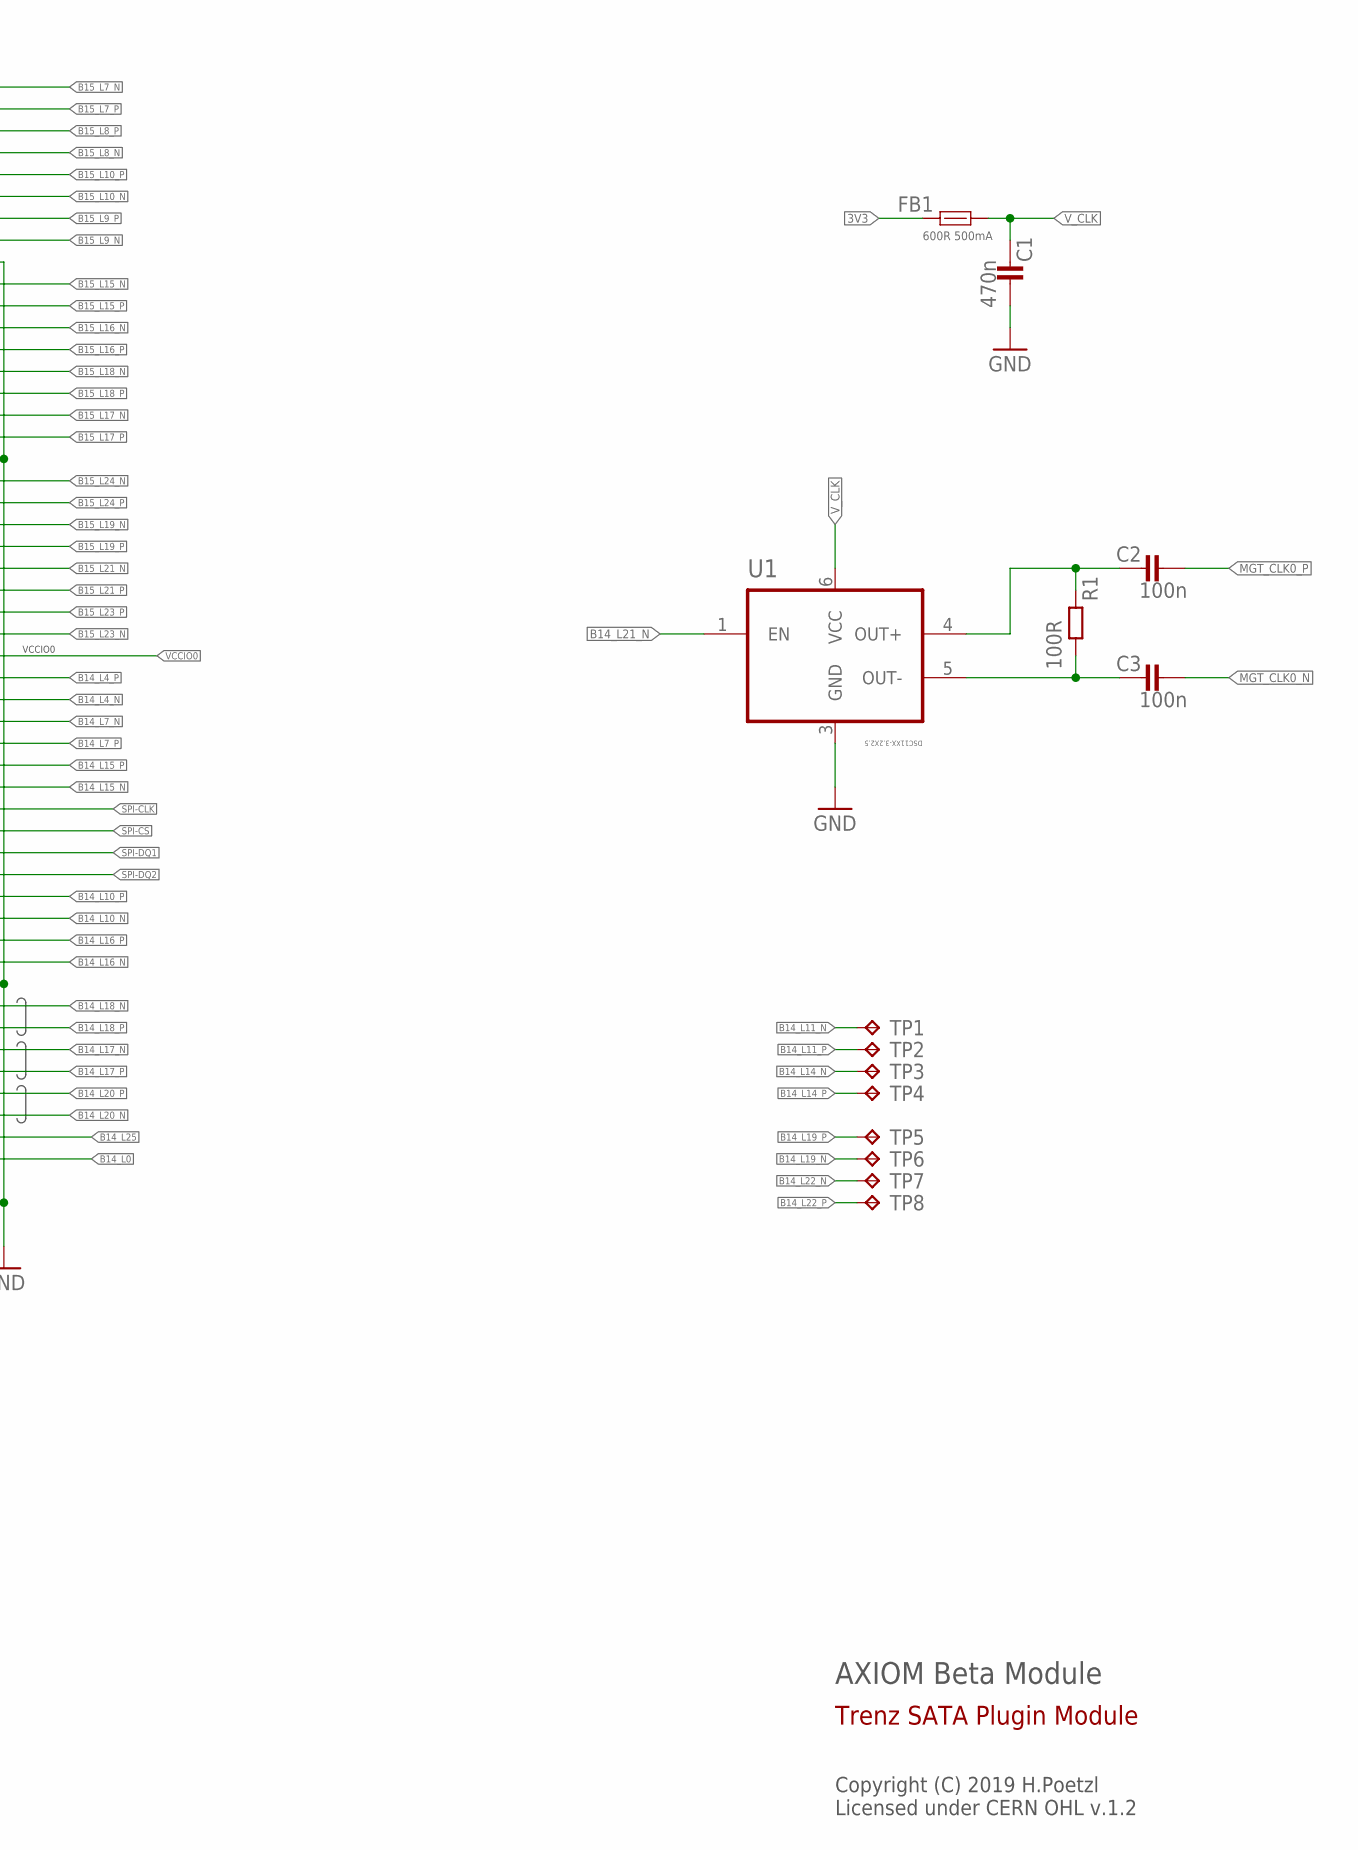
[picture p30: schematic axiom_beta_plugin_module_TE0714_SATA_v0.6_r1.2.sch, sheet 1, part in row 1, column 2]

Parts:
C1: 470n; 0402-C
C2, C3: 100n; 0201-C
FB1: 600R 500mA; 0402-C
JM1, JM2: LSHM-150-XX.X-XX-DV-A-S
R1: 100R; 0201-C
TP1, TP2, TP3, TP4, TP5, TP6, TP7, TP8: TPTP10R; TP10R
U1: DSC11XX-3.2X2.5; 3.2X2.5

Connections:
3V3: FB1.1, JM1.61, JM1.83, JM1.97, JM1.99; also elsewhere on the board
ADC_N: JM1.27
ADC_P: JM1.25
B14_L0: JM2.99; also elsewhere on the board
B14_L4_N: JM2.57
B14_L4_P: JM2.55
B14_L5_N: JM2.58
B14_L5_P: JM2.56
B14_L7_N: JM2.59
B14_L7_P: JM2.61
B14_L8_N: JM2.62
B14_L8_P: JM2.60
B14_L9_N: JM2.66
B14_L9_P: JM2.64
B14_L10_N: JM2.77
B14_L10_P: JM2.75
B14_L11_N: JM2.74, TP1.TP
B14_L11_P: JM2.76, TP2.TP
B14_L12_N: JM2.84
B14_L12_P: JM2.82; also elsewhere on the board
B14_L13_N: JM2.86
B14_L13_P: JM2.88
B14_L14_N: JM2.78, TP3.TP
B14_L14_P: JM2.80, TP4.TP
B14_L15_N: JM2.65
B14_L15_P: JM2.63
B14_L16_N: JM2.81
B14_L16_P: JM2.79
B14_L17_N: JM2.89; also elsewhere on the board
B14_L17_P: JM2.91; also elsewhere on the board
B14_L18_N: JM2.85; also elsewhere on the board
B14_L18_P: JM2.87; also elsewhere on the board
B14_L19_N: JM2.94, TP6.TP
B14_L19_P: JM2.92, TP5.TP
B14_L20_N: JM2.95; also elsewhere on the board
B14_L20_P: JM2.93; also elsewhere on the board
B14_L21_N: JM1.95, U1.1 (EN)
B14_L21_P: JM1.93; also elsewhere on the board
B14_L22_N: JM2.96, TP7.TP
B14_L22_P: JM2.98, TP8.TP
B14_L23_N: JM1.89; also elsewhere on the board
B14_L23_P: JM1.91; also elsewhere on the board
B14_L24_N: JM1.85
B14_L24_P: JM1.87; also elsewhere on the board
B14_L25: JM2.97; also elsewhere on the board
B15_L1_N: JM2.14; also elsewhere on the board
B15_L1_P: JM2.16; also elsewhere on the board
B15_L2_N: JM2.20
B15_L2_P: JM2.22
B15_L3_N: JM2.4
B15_L3_P: JM2.2
B15_L4_N: JM2.10
B15_L4_P: JM2.12
B15_L5_N: JM2.8; also elsewhere on the board
B15_L5_P: JM2.6; also elsewhere on the board
B15_L6_N: JM2.26; also elsewhere on the board
B15_L6_P: JM2.24; also elsewhere on the board
B15_L7_N: JM2.1; also elsewhere on the board
B15_L7_P: JM2.3; also elsewhere on the board
B15_L8_N: JM2.7
B15_L8_P: JM2.5
B15_L9_N: JM2.15
B15_L9_P: JM2.13
B15_L10_N: JM2.11; also elsewhere on the board
B15_L10_P: JM2.9; also elsewhere on the board
B15_L11_N: JM2.30
B15_L11_P: JM2.28
B15_L12_N: JM2.34; also elsewhere on the board
B15_L12_P: JM2.32; also elsewhere on the board
B15_L13_N: JM2.38; also elsewhere on the board
B15_L13_P: JM2.40; also elsewhere on the board
B15_L14_N: JM2.42
B15_L14_P: JM2.44
B15_L15_N: JM2.19; also elsewhere on the board
B15_L15_P: JM2.21; also elsewhere on the board
B15_L16_N: JM2.23
B15_L16_P: JM2.25
B15_L17_N: JM2.31
B15_L17_P: JM2.33
B15_L18_N: JM2.27; also elsewhere on the board
B15_L18_P: JM2.29; also elsewhere on the board
B15_L19_N: JM2.41; also elsewhere on the board
B15_L19_P: JM2.43; also elsewhere on the board
B15_L20_N: JM2.50
B15_L20_P: JM2.52
B15_L21_N: JM2.45
B15_L21_P: JM2.47
B15_L22_N: JM2.46; also elsewhere on the board
B15_L22_P: JM2.48; also elsewhere on the board
B15_L23_N: JM2.51; also elsewhere on the board
B15_L23_P: JM2.49; also elsewhere on the board
B15_L24_N: JM2.37
B15_L24_P: JM2.39
B34_L1_N: JM1.37
B34_L1_P: JM1.35
B34_L2_N: JM1.33
B34_L2_P: JM1.31
B34_L3_N: JM1.42; also elsewhere on the board
B34_L3_P: JM1.40; also elsewhere on the board
B34_L4_N: JM1.41
B34_L4_P: JM1.39
B34_L5_N: JM1.45
B34_L5_P: JM1.43
B34_L6_N: JM1.34
B34_L6_P: JM1.32
B34_L7_N: JM1.38
B34_L7_P: JM1.36
B34_L8_N: JM1.52
B34_L8_P: JM1.50
B34_L9_N: JM1.46; also elsewhere on the board
B34_L9_P: JM1.44; also elsewhere on the board
B34_L10_N: JM1.51
B34_L10_P: JM1.49
B34_L11_N: JM1.53
B34_L11_P: JM1.55
B34_L12_N: JM1.57
B34_L12_P: JM1.59
B34_L13_N: JM1.56
B34_L13_P: JM1.54
B34_L14_N: JM1.60
B34_L14_P: JM1.58
B34_L15_N: JM1.62
B34_L15_P: JM1.64
B34_L16_N: JM1.68
B34_L16_P: JM1.70
B34_L17_N: JM1.63
B34_L17_P: JM1.65
B34_L18_N: JM1.74
B34_L18_P: JM1.72
B34_L19_N: JM1.71
B34_L19_P: JM1.73
B34_L20_N: JM1.76
B34_L20_P: JM1.78
B34_L21_N: JM1.69
B34_L21_P: JM1.67
B34_L22_N: JM1.75
B34_L22_P: JM1.77
B34_L23_N: JM1.79
B34_L23_P: JM1.81
B34_L24_N: JM1.80
B34_L24_P: JM1.82
BOOTMODE: JM2.100
DONE: JM1.96; also elsewhere on the board
GND: C1.2, JM1.5, JM1.6, JM1.11, JM1.12, JM1.17, JM1.18, JM1.23, JM1.24, JM1.29, JM1.30, JM1.47, JM1.48, JM1.66, JM1.84, JM1.98, JM1.100, JM1.F1, JM1.F2, JM2.17, JM2.35, JM2.36, JM2.72, JM2.83, JM2.90, JM2.F1, JM2.F2, U1.3 (GND); also elsewhere on the board
MGT_CLK0_N: C3.2, JM1.4
MGT_CLK0_P: C2.2, JM1.2
MGT_RX0_N: JM1.21; also elsewhere on the board
MGT_RX0_P: JM1.19; also elsewhere on the board
MGT_RX1_N: JM1.15; also elsewhere on the board
MGT_RX1_P: JM1.13; also elsewhere on the board
MGT_RX2_N: JM1.9; also elsewhere on the board
MGT_RX2_P: JM1.7; also elsewhere on the board
MGT_RX3_N: JM1.3; also elsewhere on the board
MGT_RX3_P: JM1.1; also elsewhere on the board
MGT_TX0_N: JM1.28; also elsewhere on the board
MGT_TX0_P: JM1.26; also elsewhere on the board
MGT_TX1_N: JM1.22; also elsewhere on the board
MGT_TX1_P: JM1.20; also elsewhere on the board
MGT_TX2_N: JM1.16; also elsewhere on the board
MGT_TX2_P: JM1.14; also elsewhere on the board
MGT_TX3_N: JM1.10; also elsewhere on the board
MGT_TX3_P: JM1.8; also elsewhere on the board
M_1V8: JM2.18
OUT_N: C3.1, R1.2, U1.5 (OUT-)
OUT_P: C2.1, R1.1, U1.4 (OUT+)
PROG_B: JM1.94
SPI-CLK: JM2.67
SPI-CS: JM2.69
SPI-DQ0: JM2.68
SPI-DQ1: JM2.71
SPI-DQ2: JM2.73
SPI-DQ3: JM2.70
S_VCCIO: JM2.54; also elsewhere on the board
TCK: JM1.90; also elsewhere on the board
TDI: JM1.86; also elsewhere on the board
TDO: JM1.88; also elsewhere on the board
TMS: JM1.92; also elsewhere on the board
VCCIO0: JM2.53; also elsewhere on the board
V_CLK: C1.1, FB1.2, U1.6 (VCC)

Notes on the sheet:
AXIOM Beta Module
Copyright (C) 2019 H.Poetzl Licensed under CERN OHL v.1.2
Trenz SATA Plugin Module
VCCIO34
VCCIO14
VCCIO15
VCCIO0
VIN
