apertus-open-source-cinema/pcbs/boards/axiom_beta_plugin_module_TE0714_SATA_v0.6_r1.2.brd

## EAGLE design boards/axiom_beta_plugin_module_TE0714_SATA_v0.6_r1.2.brd (continued)

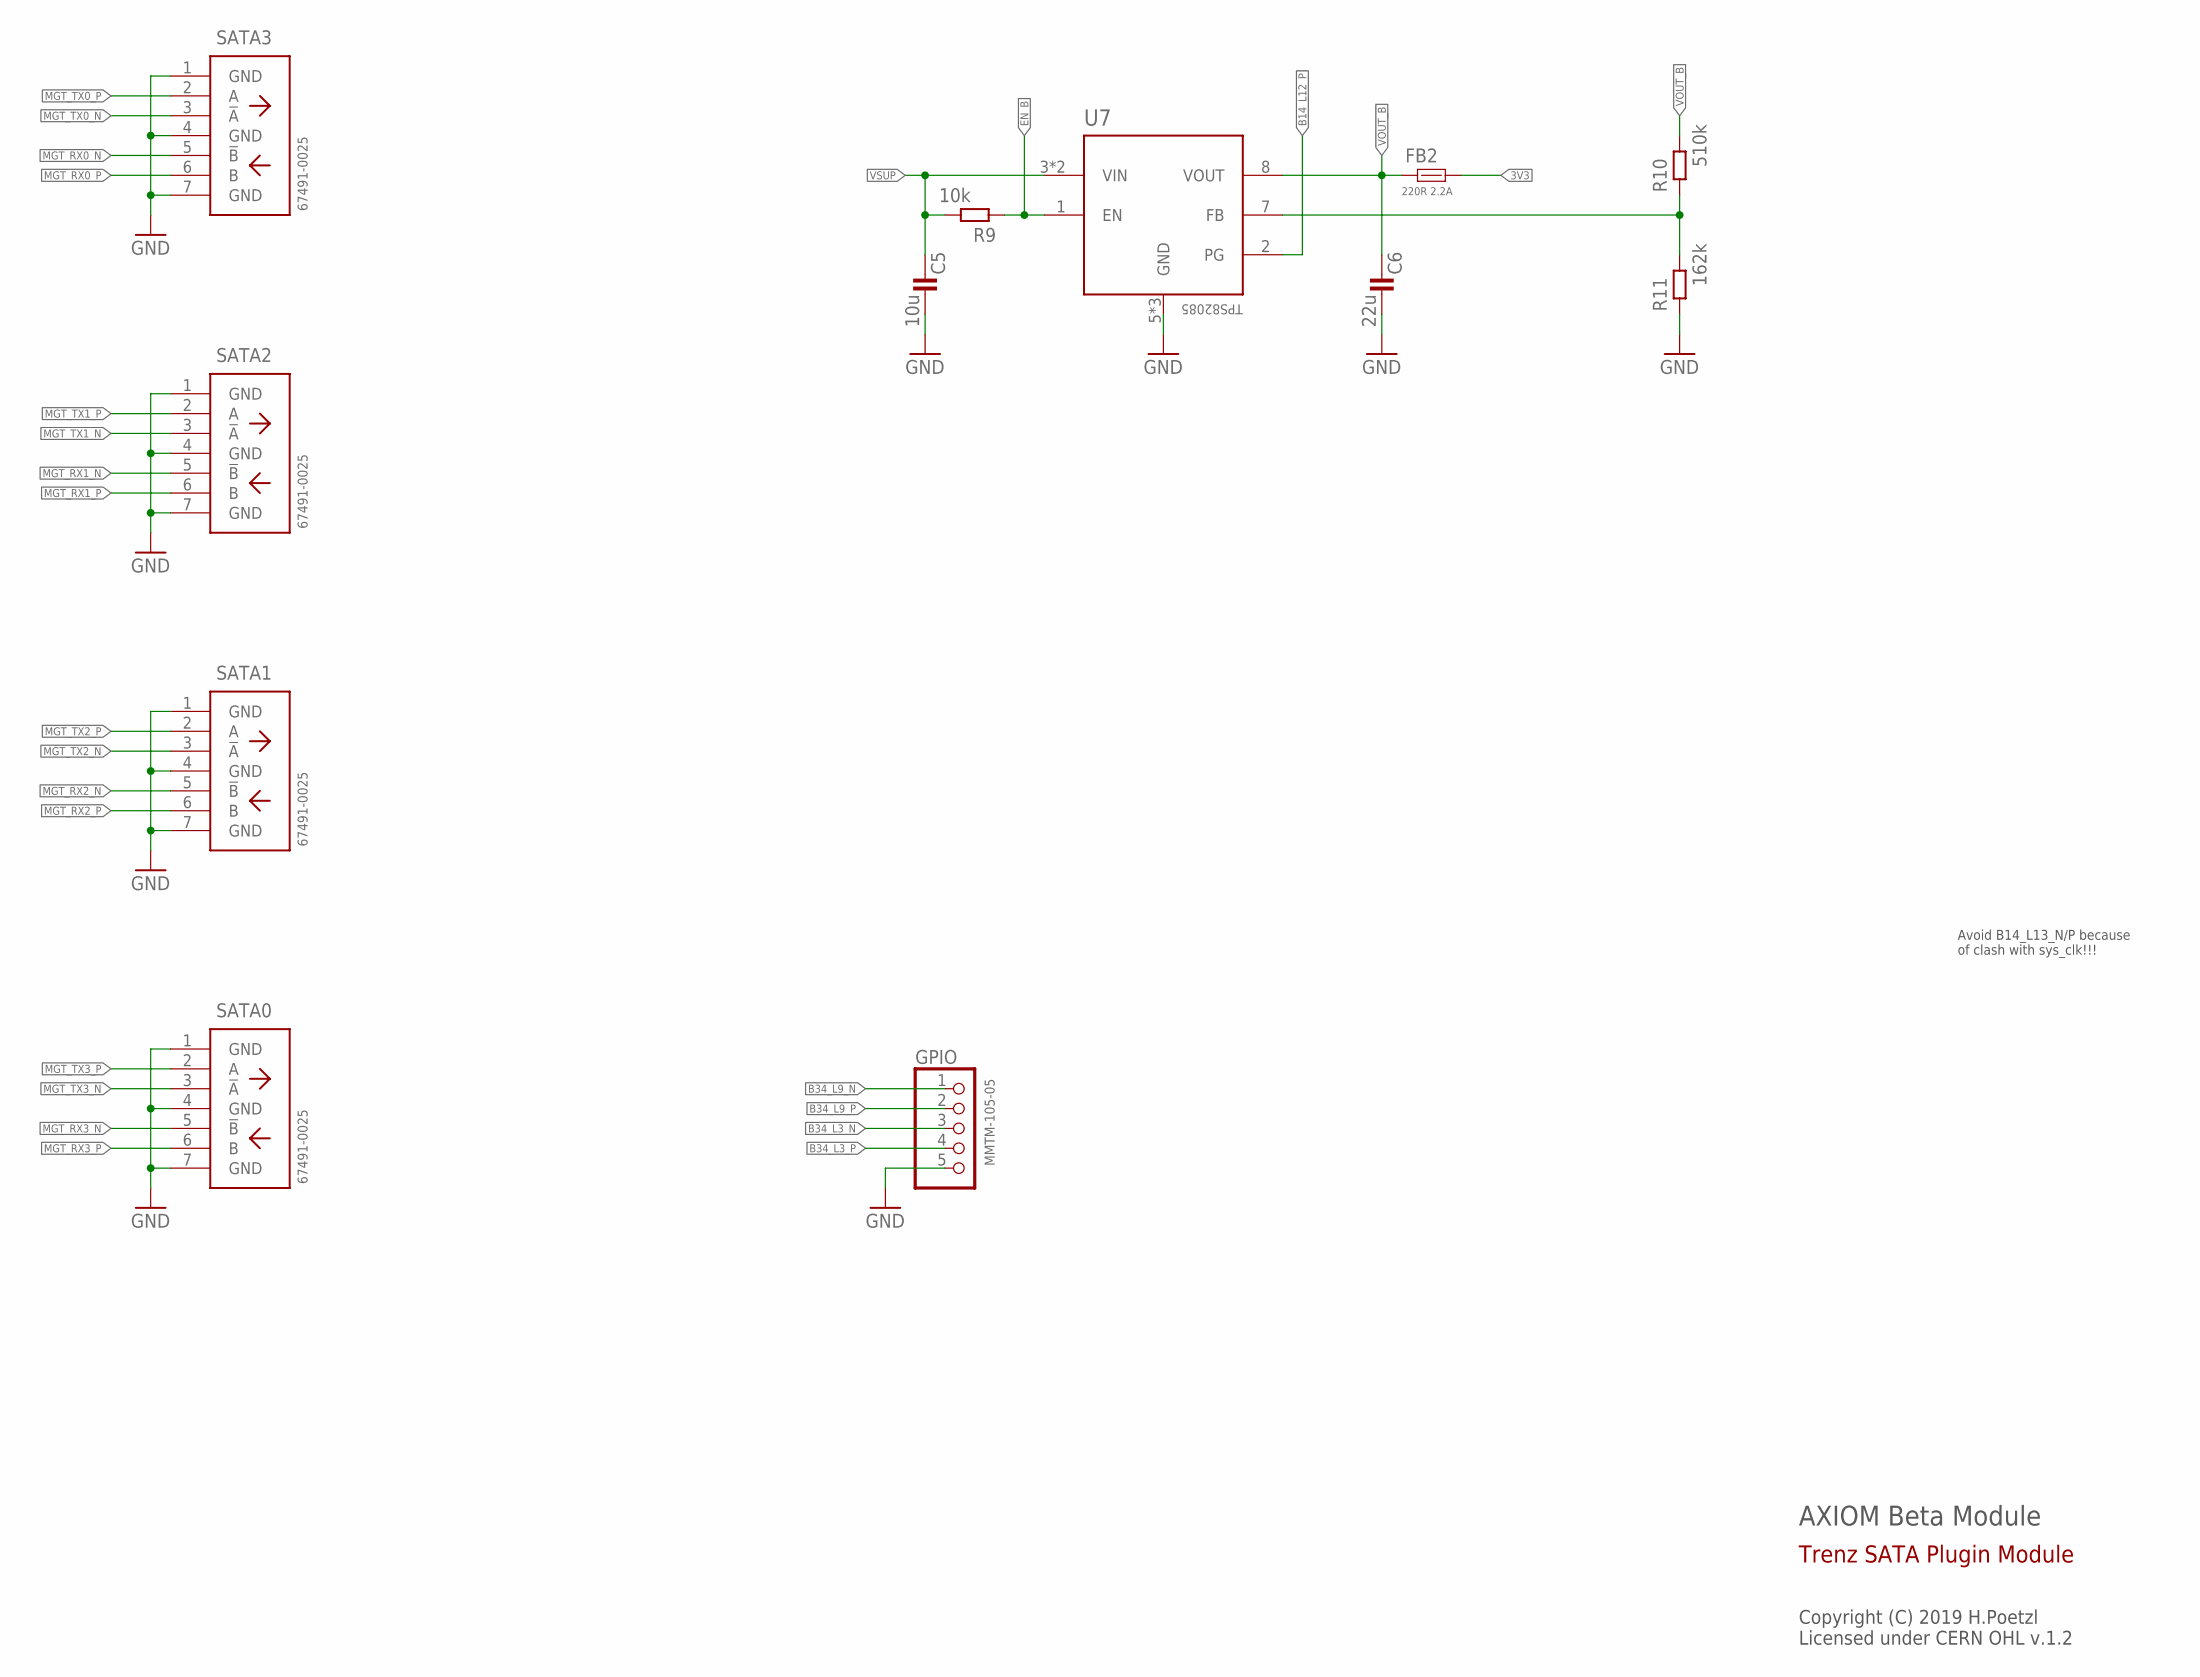
[picture p31: schematic axiom_beta_plugin_module_TE0714_SATA_v0.6_r1.2.sch, sheet 2]

Parts:
C5: 10u; 0603-C
C6: 22u; 0603-C
FB2: 220R 2.2A; 0603-C
GPIO: MMTM-105-05; 1X05M
R9: 10k; 0201-C
R10: 510k; 0201-C
R11: 162k; 0201-C
SATA0, SATA1, SATA2, SATA3: 67491-0025; SATA7-VERT-S
U7: TPS82085; MICROSIP

Connections:
3V3: FB2.2; also elsewhere on the board
B14_L12_P: U7.2 (PG); also elsewhere on the board
B34_L3_N: GPIO.3; also elsewhere on the board
B34_L3_P: GPIO.4; also elsewhere on the board
B34_L9_N: GPIO.1; also elsewhere on the board
B34_L9_P: GPIO.2; also elsewhere on the board
EN_B: R9.1, U7.1 (EN)
FB_B: R10.1, R11.2, U7.7 (FB)
GND: C5.2, C6.2, GPIO.5, R11.1, SATA0.1 (GND), SATA0.4 (GND), SATA0.7 (GND), SATA1.1 (GND), SATA1.4 (GND), SATA1.7 (GND), SATA2.1 (GND), SATA2.4 (GND), SATA2.7 (GND), SATA3.1 (GND), SATA3.4 (GND), SATA3.7 (GND), U7.5 (GND), U7.6 (GND), U7.EP (GND); also elsewhere on the board
MGT_RX0_N: SATA3.5 (!B); also elsewhere on the board
MGT_RX0_P: SATA3.6 (B); also elsewhere on the board
MGT_RX1_N: SATA2.5 (!B); also elsewhere on the board
MGT_RX1_P: SATA2.6 (B); also elsewhere on the board
MGT_RX2_N: SATA1.5 (!B); also elsewhere on the board
MGT_RX2_P: SATA1.6 (B); also elsewhere on the board
MGT_RX3_N: SATA0.5 (!B); also elsewhere on the board
MGT_RX3_P: SATA0.6 (B); also elsewhere on the board
MGT_TX0_N: SATA3.3 (!A); also elsewhere on the board
MGT_TX0_P: SATA3.2 (A); also elsewhere on the board
MGT_TX1_N: SATA2.3 (!A); also elsewhere on the board
MGT_TX1_P: SATA2.2 (A); also elsewhere on the board
MGT_TX2_N: SATA1.3 (!A); also elsewhere on the board
MGT_TX2_P: SATA1.2 (A); also elsewhere on the board
MGT_TX3_N: SATA0.3 (!A); also elsewhere on the board
MGT_TX3_P: SATA0.2 (A); also elsewhere on the board
VOUT_B: C6.1, FB2.1, R10.2, U7.8 (VOUT)
VSUP: C5.1, R9.2, U7.3 (VIN), U7.4 (VIN); also elsewhere on the board

Notes on the sheet:
AXIOM Beta Module
Copyright (C) 2019 H.Poetzl Licensed under CERN OHL v.1.2
Trenz SATA Plugin Module
Avoid B14_L13_N/P because of clash with sys_clk!!!

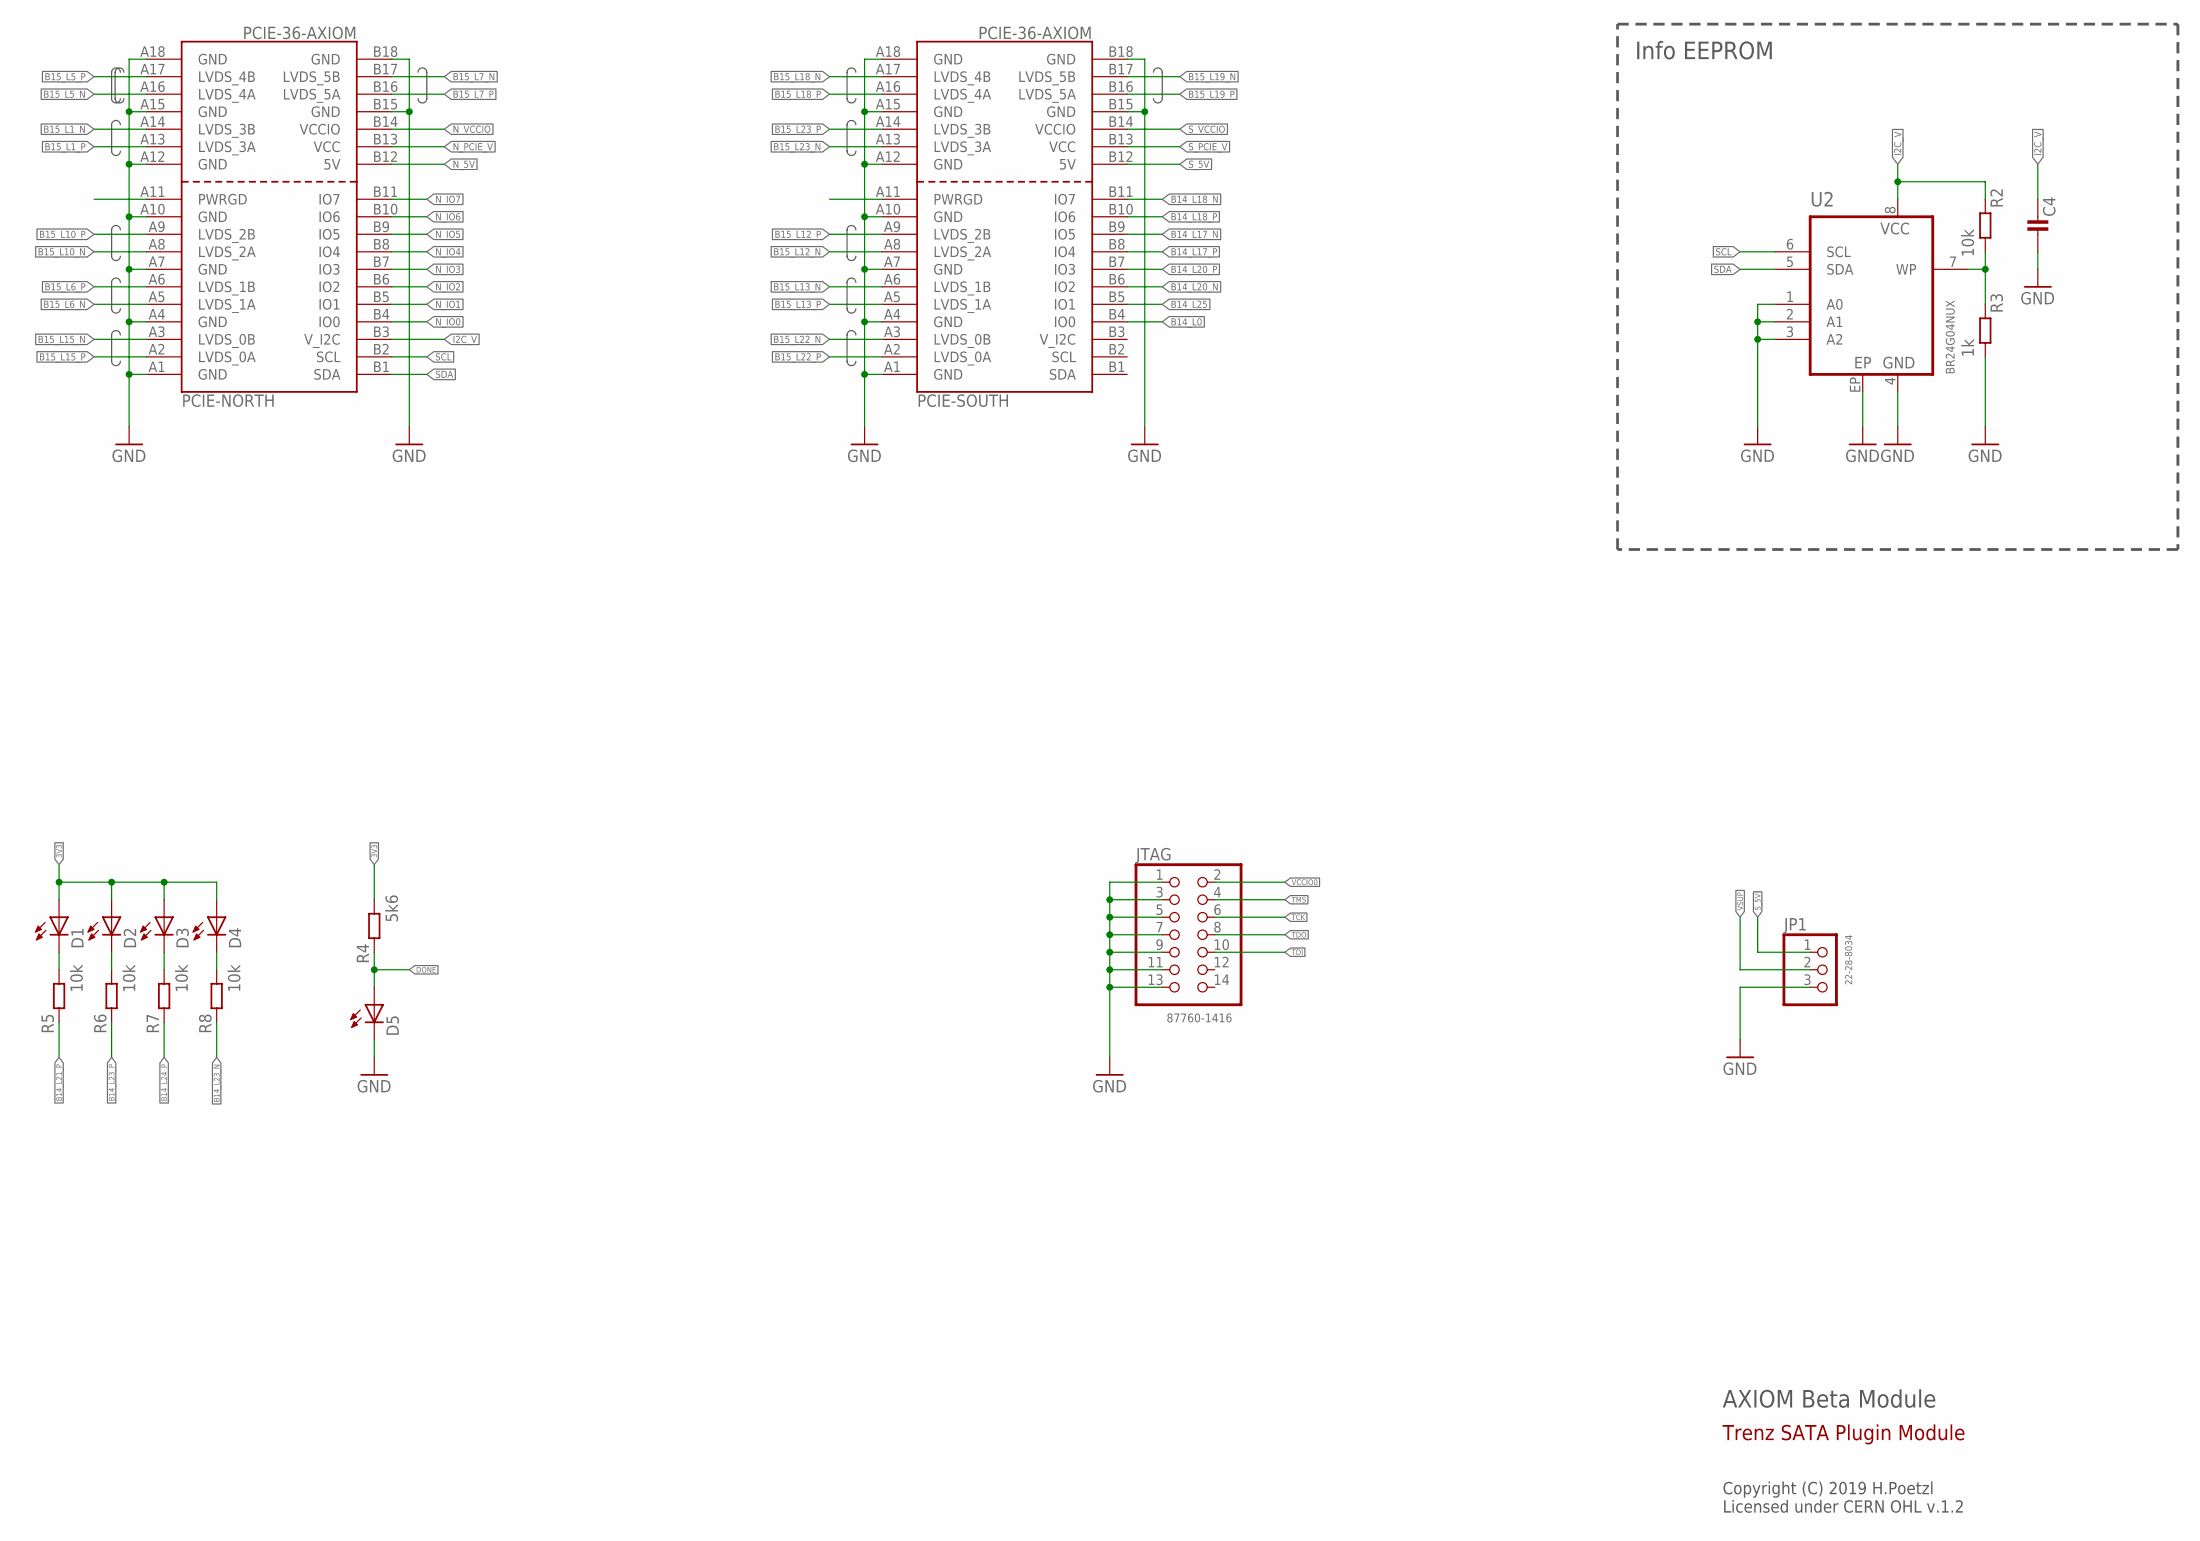
[picture p32: schematic axiom_beta_plugin_module_TE0714_SATA_v0.6_r1.2.sch, sheet 3]

Parts:
C4: C0402-B; 0402-B
D1, D2, D3, D4, D5: LED; CHIPLED_0603
JP1: 22-28-8034; 1X03/90-S
JTAG: 87760-1416; 2X07M
PCIE-NORTH: PCIE-36-AXIOM
PCIE-SOUTH: PCIE-36-AXIOM
R2: 10k; 0402-B
R3: 1k; 0402-B
R4: 5k6; 0402-C
R5, R6, R7, R8: 10k; 0402-C
U2: BR24G04NUX; DFN200X300X100-9N

Connections:
3V3: D1.A, D2.A, D3.A, D4.A, R4.2; also elsewhere on the board
B14_L0: PCIE-SOUTH.B4 (IO0); also elsewhere on the board
B14_L17_N: PCIE-SOUTH.B9 (IO5); also elsewhere on the board
B14_L17_P: PCIE-SOUTH.B8 (IO4); also elsewhere on the board
B14_L18_N: PCIE-SOUTH.B11 (IO7); also elsewhere on the board
B14_L18_P: PCIE-SOUTH.B10 (IO6); also elsewhere on the board
B14_L20_N: PCIE-SOUTH.B6 (IO2); also elsewhere on the board
B14_L20_P: PCIE-SOUTH.B7 (IO3); also elsewhere on the board
B14_L21_P: R5.1; also elsewhere on the board
B14_L23_N: R8.1; also elsewhere on the board
B14_L23_P: R6.1; also elsewhere on the board
B14_L24_P: R7.1; also elsewhere on the board
B14_L25: PCIE-SOUTH.B5 (IO1); also elsewhere on the board
B15_L1_N: PCIE-NORTH.A14 (LVDS_3B); also elsewhere on the board
B15_L1_P: PCIE-NORTH.A13 (LVDS_3A); also elsewhere on the board
B15_L5_N: PCIE-NORTH.A16 (LVDS_4A); also elsewhere on the board
B15_L5_P: PCIE-NORTH.A17 (LVDS_4B); also elsewhere on the board
B15_L6_N: PCIE-NORTH.A5 (LVDS_1A); also elsewhere on the board
B15_L6_P: PCIE-NORTH.A6 (LVDS_1B); also elsewhere on the board
B15_L7_N: PCIE-NORTH.B17 (LVDS_5B); also elsewhere on the board
B15_L7_P: PCIE-NORTH.B16 (LVDS_5A); also elsewhere on the board
B15_L10_N: PCIE-NORTH.A8 (LVDS_2A); also elsewhere on the board
B15_L10_P: PCIE-NORTH.A9 (LVDS_2B); also elsewhere on the board
B15_L12_N: PCIE-SOUTH.A8 (LVDS_2A); also elsewhere on the board
B15_L12_P: PCIE-SOUTH.A9 (LVDS_2B); also elsewhere on the board
B15_L13_N: PCIE-SOUTH.A6 (LVDS_1B); also elsewhere on the board
B15_L13_P: PCIE-SOUTH.A5 (LVDS_1A); also elsewhere on the board
B15_L15_N: PCIE-NORTH.A3 (LVDS_0B); also elsewhere on the board
B15_L15_P: PCIE-NORTH.A2 (LVDS_0A); also elsewhere on the board
B15_L18_N: PCIE-SOUTH.A17 (LVDS_4B); also elsewhere on the board
B15_L18_P: PCIE-SOUTH.A16 (LVDS_4A); also elsewhere on the board
B15_L19_N: PCIE-SOUTH.B17 (LVDS_5B); also elsewhere on the board
B15_L19_P: PCIE-SOUTH.B16 (LVDS_5A); also elsewhere on the board
B15_L22_N: PCIE-SOUTH.A3 (LVDS_0B); also elsewhere on the board
B15_L22_P: PCIE-SOUTH.A2 (LVDS_0A); also elsewhere on the board
B15_L23_N: PCIE-SOUTH.A13 (LVDS_3A); also elsewhere on the board
B15_L23_P: PCIE-SOUTH.A14 (LVDS_3B); also elsewhere on the board
DONE: D5.A, R4.1; also elsewhere on the board
GND: C4.2, D5.C, JP1.3, JTAG.1, JTAG.3, JTAG.5, JTAG.7, JTAG.9, JTAG.11, JTAG.13, PCIE-NORTH.A1 (GND), PCIE-NORTH.A4 (GND), PCIE-NORTH.A7 (GND), PCIE-NORTH.A10 (GND), PCIE-NORTH.A12 (GND), PCIE-NORTH.A15 (GND), PCIE-NORTH.A18 (GND), PCIE-NORTH.B15 (GND), PCIE-NORTH.B18 (GND), PCIE-SOUTH.A1 (GND), PCIE-SOUTH.A4 (GND), PCIE-SOUTH.A7 (GND), PCIE-SOUTH.A10 (GND), PCIE-SOUTH.A12 (GND), PCIE-SOUTH.A15 (GND), PCIE-SOUTH.A18 (GND), PCIE-SOUTH.B15 (GND), PCIE-SOUTH.B18 (GND), R3.2, U2.1 (A0), U2.2 (A1), U2.3 (A2), U2.4 (GND), U2.EP; also elsewhere on the board
I2C_V: C4.1, PCIE-NORTH.B3 (V_I2C), R2.1, U2.8 (VCC)
unnamed: D1.C, R5.2
unnamed: D2.C, R6.2
unnamed: D3.C, R7.2
unnamed: D4.C, R8.2
unnamed: R2.2, R3.1, U2.7 (WP)
N_5V: PCIE-NORTH.B12 (5V)
N_IO0: PCIE-NORTH.B4 (IO0)
N_IO1: PCIE-NORTH.B5 (IO1)
N_IO2: PCIE-NORTH.B6 (IO2)
N_IO3: PCIE-NORTH.B7 (IO3)
N_IO4: PCIE-NORTH.B8 (IO4)
N_IO5: PCIE-NORTH.B9 (IO5)
N_IO6: PCIE-NORTH.B10 (IO6)
N_IO7: PCIE-NORTH.B11 (IO7)
N_PCIE_V: PCIE-NORTH.B13 (VCC)
N_VCCIO: PCIE-NORTH.B14 (VCCIO)
SCL: PCIE-NORTH.B2 (SCL), U2.6 (SCL)
SDA: PCIE-NORTH.B1 (SDA), U2.5 (SDA)
S_5V: JP1.1, PCIE-SOUTH.B12 (5V)
S_PCIE_V: PCIE-SOUTH.B13 (VCC)
S_VCCIO: PCIE-SOUTH.B14 (VCCIO); also elsewhere on the board
TCK: JTAG.6; also elsewhere on the board
TDI: JTAG.10; also elsewhere on the board
TDO: JTAG.8; also elsewhere on the board
TMS: JTAG.4; also elsewhere on the board
VCCIO0: JTAG.2; also elsewhere on the board
VSUP: JP1.2; also elsewhere on the board

Notes on the sheet:
AXIOM Beta Module
Copyright (C) 2019 H.Poetzl Licensed under CERN OHL v.1.2
Trenz SATA Plugin Module
Info EEPROM

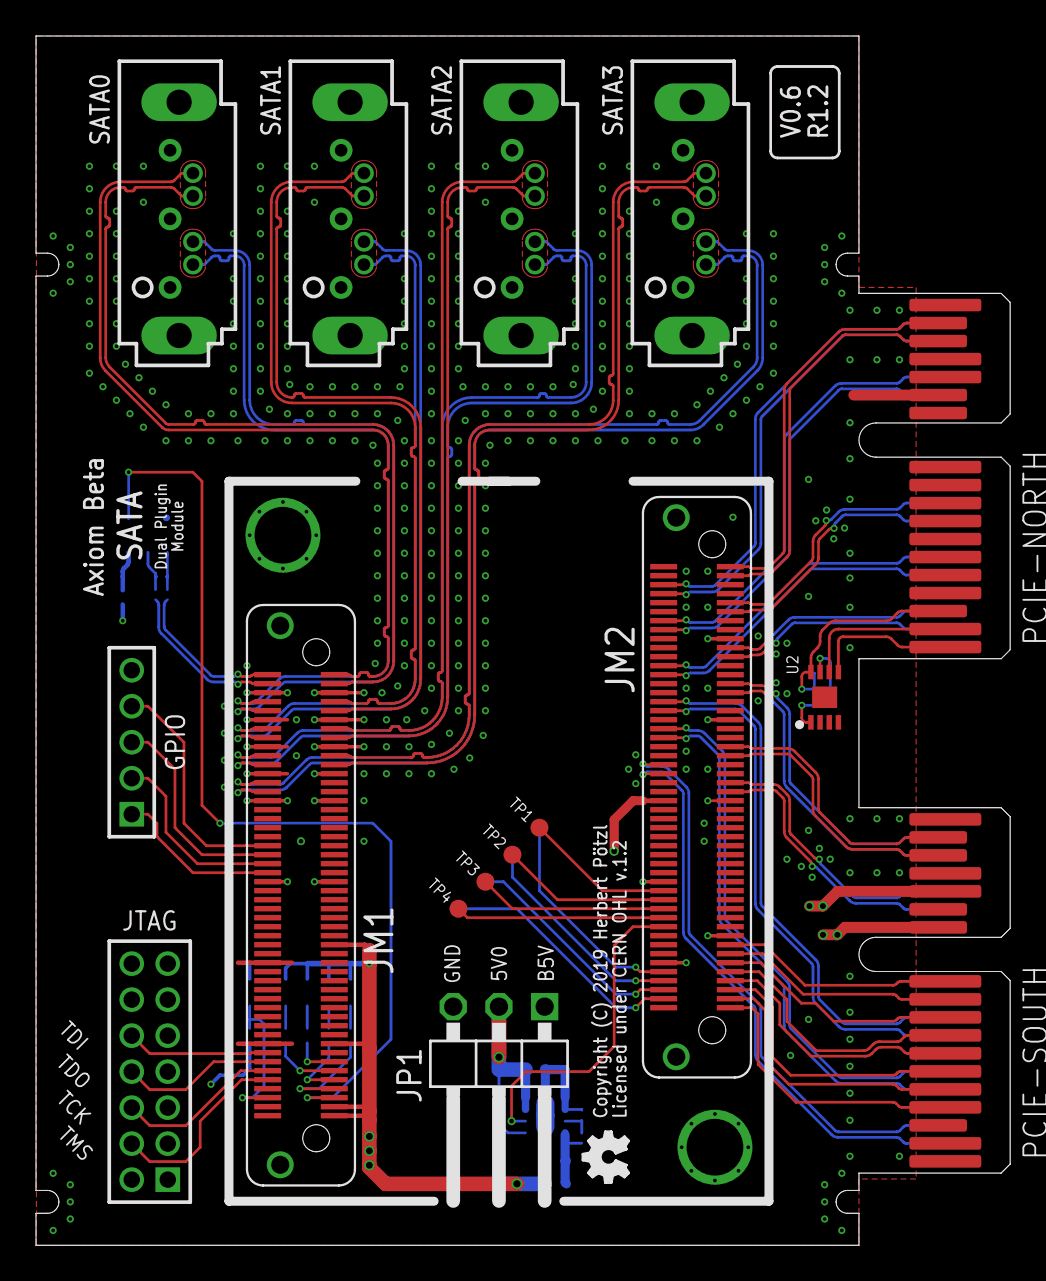
[picture p33: board axiom_beta_plugin_module_TE0714_SATA_v0.6_r1.2.brd from above]

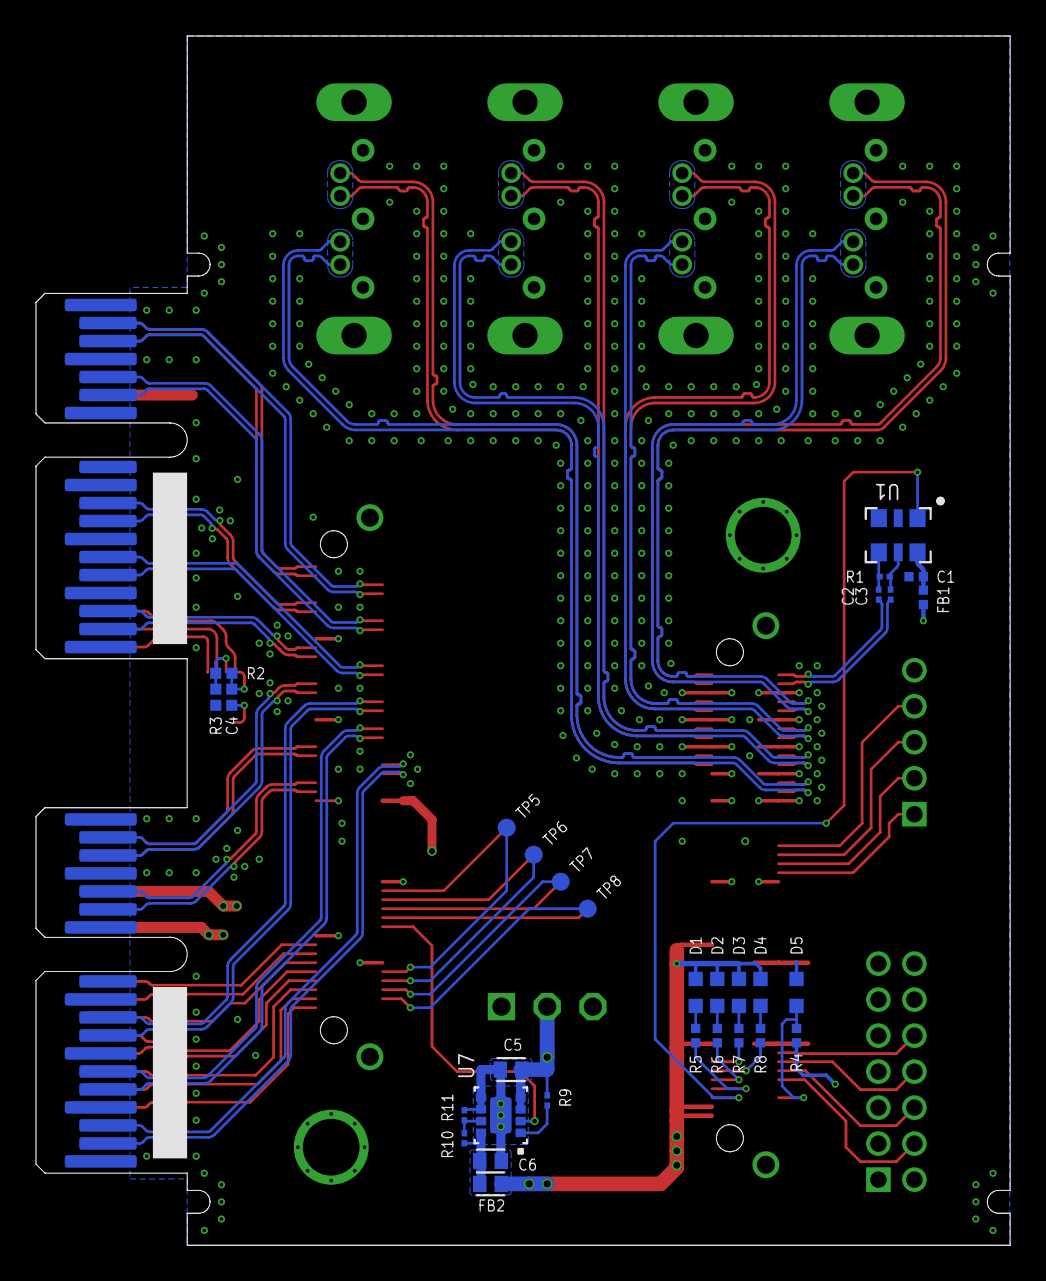
[picture p34: board axiom_beta_plugin_module_TE0714_SATA_v0.6_r1.2.brd from below]

Board: 4 copper layers, 54.1 x 67.2 mm, 47 parts (30 on the bottom side), 93 nets.

Other parts of the board:
LOGO2: OSHW_LOGO_FILLX0100-NT; OSHW_FILLX100_NOTEXT
