apertus-open-source-cinema/pcbs/(notices)

Notices in the files:
boards/remote_v0.14.sch:
Copyright (C) 2018 H.Poetzl
boards/axiom_beta_main_board_v0.37_r1.1.sch:
Copyright (C) 2014-2020 H.Poetzl
Copyright (C) 2015-2020 H.Poetzl
boards/axiom_beta_sensor_cmv12000_zif_v0.18_r1.5.sch:
Copyright (C) 2014-2015 Herbert Poetzl
boards/axiom_beta_sensor_cmv12000_tht_v0.16.sch:
Copyright (C) 2014-2017 H. Pötzl
boards/axiom_beta_power_board_v0.34.sch:
Copyright (C) 2014-2017 H.Poetzl
Copyright (C) 2014-2019 H.Poetzl
boards/axiom_beta_shield_debug_v0.2.sch:
Copyright (C) 2015-2017 H.Pötzl
boards/axiom_beta_plugin_module_TE0714_SDI_v0.10.sch:
Copyright (C) 2017 H.Poetzl
boards/qad-center-v0.8.sch:
Copyright (C) 2013 H.Poetzl
Licensed under CERN OHL v.1.1
boards/axiom_beta_interface_dummy_v0.8.sch:
Copyright (C) 2014 Herbert Poetzl
boards/axiom_beta_power_board_v2.23.sch:
Copyright (C) 2014-2018 H.Poetzl
boards/axiom_beta_shield_ESP32_v0.1.sch:
Copyright (C) 2017 H.Pötzl
boards/sensor_frontend_test_v0.5.sch:
Copyright (C) 2016 Herbert Poetzl
boards/axiom_beta_plugin_module_1xPMOD_v0.1_r1.1.brd:
Copyright (C) 2016 Herbert Pötzl
parts and their libraries:
microbuilder: This work is placed in the public domain, and may be freely used for commercial and non-commercial work with the following conditions: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
SparkFun-Connectors: Licensing: CC v3.0 Share-Alike You are welcome to use this library for commercial purposes.
